MIDORIINU/DSE-CII/README.md

# DSE-CII
Repositorio de DSE/CII 2019 - 1C

* Luna Diego

* Neumarkt Fernández Leonardo

* Rizzo Gonzalo Gabriel

Prototipo:

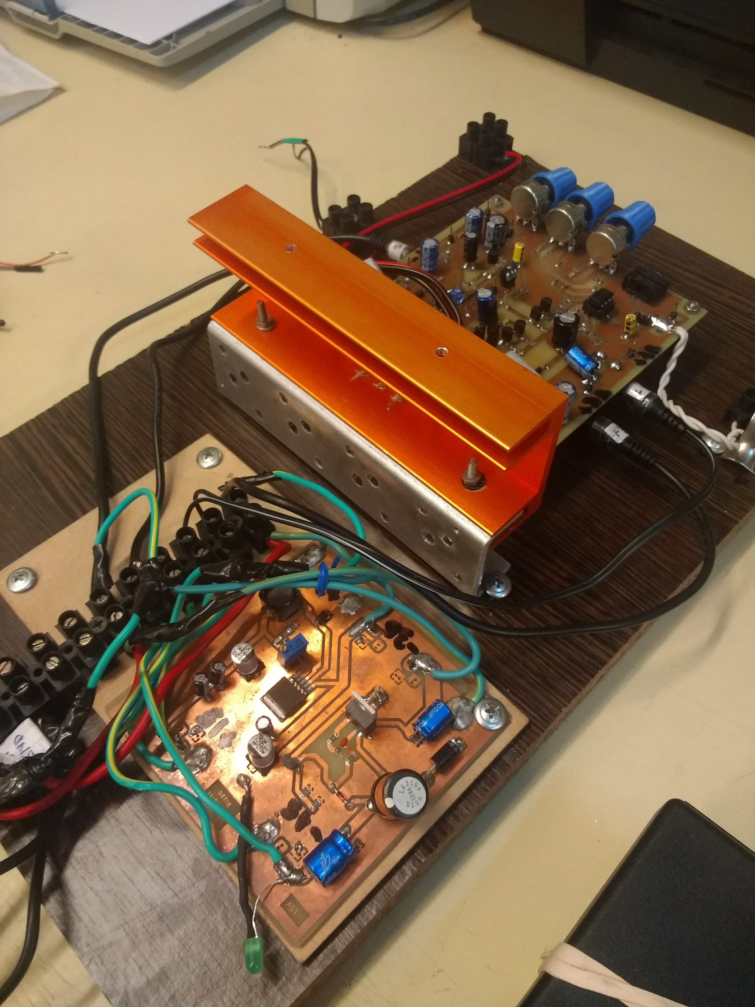
[picture p1: informe/final/informe/img/fotos/2.jpg]


Aprobado 20/12/2019.
