MIDORIINU/DSE-CII/informe/final/informe/datasheets.tex

%*********************************************

\subsection{BD135}
\label{datasheet_BD135}
\emph{NPN Plastic Medium-Power Silicon Transistors}\\
Manufacturer page:	\weblink{https://www.onsemi.com/PowerSolutions/product.do?id=BD135}{https://www.onsemi.com/PowerSolutions/product.do?id=BD135}\\
Manufacturer Datasheet:	\weblink{https://www.onsemi.com/pub/Collateral/BD135-D.PDF}{https://www.onsemi.com/pub/Collateral/BD135-D.PDF}\\

\subsection{BD136}
\label{datasheet_BD136}
\emph{PNP Plastic Medium-Power Silicon  Transistors}\\
Manufacturer page:	\weblink{https://www.onsemi.com/PowerSolutions/product.do?id=BD136}{https://www.onsemi.com/PowerSolutions/product.do?id=BD136}\\
Manufacturer Datasheet:	\weblink{https://www.onsemi.com/pub/Collateral/BD136G-D.PDF}{https://www.onsemi.com/pub/Collateral/BD136G-D.PDF}\\

\subsection{BC556}
\label{datasheet_BC556}
\emph{PNP Silicon Transistor}\\
Manufacturer page:	\weblink{https://www.onsemi.com/PowerSolutions/product.do?id=BC556}{https://www.onsemi.com/PowerSolutions/product.do?id=BC556}\\
Manufacturer Datasheet:	\weblink{https://www.onsemi.com/pub/Collateral/BC556BTA-D.pdf}{https://www.onsemi.com/pub/Collateral/BC556BTA-D.pdf}\\

\subsection{MJL21193}
\label{datasheet_MJL21193}
\emph{PNP Bipolar Power Transistor}\\
Manufacturer page:	\weblink{https://www.onsemi.com/PowerSolutions/product.do?id=MJL21193}{https://www.onsemi.com/PowerSolutions/product.do?id=MJL21193}\\
Manufacturer Datasheet:	\weblink{https://www.onsemi.com/pub/Collateral/MJL21193-D.PDF}{https://www.onsemi.com/pub/Collateral/MJL21193-D.PDF}\\

\subsection{MJL21194}
\label{datasheet_MJL21194}
\emph{NPN Bipolar Power Transistor}\\
Manufacturer page:	\weblink{https://www.onsemi.com/PowerSolutions/product.do?id=MJL21194}{https://www.onsemi.com/PowerSolutions/product.do?id=MJL21194}\\
Manufacturer Datasheet:	\weblink{https://www.onsemi.com/pub/Collateral/MJL21193-D.PDF}{https://www.onsemi.com/pub/Collateral/MJL21193-D.PDF}\\

\subsection{1N4148}
\label{datasheet_NE5532}
\emph{Small signal diode}\\
Manufacturer page:	\weblink{https://www.onsemi.com/PowerSolutions/product.do?id=1N4148}{https://www.onsemi.com/PowerSolutions/product.do?id=1N4148}\\
Manufacturer Datasheet:	\weblink{https://www.vishay.com/docs/81857/1n4148.pdf}{https://www.vishay.com/docs/81857/1n4148.pdf}\\

\subsection{1N4370}
\label{datasheet_1N4370}
\emph{Zener Voltage Regulator Diode}\\
Manufacturer page:	\weblink{https://www.microsemi.com/existing-parts/parts/121321}{https://www.microsemi.com/existing-parts/parts/121321}\\
Manufacturer Datasheet:	\weblink{http://pdf.datasheetcatalog.com/datasheet/microsemi/1N746\_759A\_4370\_4372A.pdf}{http://pdf.datasheetcatalog.com/datasheet/microsemi/1N746\_759A\_4370\_4372A.pdf}\\

\subsection{1N4007}
\label{datasheet_1N4007}
\emph{Silicon rectifier diode}\\
Manufacturer page:	\weblink{https://www.onsemi.com/products/discretes-drivers/diodes-rectifiers/rectifiers/1n4007}{https://www.onsemi.com/products/discretes-drivers/diodes-rectifiers/rectifiers/1n4007}\\
Manufacturer Datasheet:	\weblink{http://pdf.datasheetcatalog.com/datasheet/fairchild/1N4007.pdf}{http://pdf.datasheetcatalog.com/datasheet/fairchild/1N4007.pdf}\\

\subsection{1N5822}
\label{datasheet_1N5822}
\emph{Schottky Barrier Rectifier}\\
Manufacturer page:	\weblink{https://www.onsemi.com/products/discretes-drivers/diodes-rectifiers/schottky-diodes-schottky-rectifiers/1n5822}{https://www.onsemi.com/products/discretes-drivers/diodes-rectifiers/schottky-diodes-schottky-rectifiers/1n5822}\\
Manufacturer Datasheet:	\weblink{https://www.onsemi.com/pub/Collateral/1N5820-D.PDF}{https://www.onsemi.com/pub/Collateral/1N5820-D.PDF}\\

\subsection{Metal film resistor}
\label{datasheet_METALFILMRESISTOR}
\emph{Metal film resistor}\\
Manufacturer page:	\weblink{https://www.vishay.com/resistors-fixed/metal-film/tab/doclibrary/}{https://www.vishay.com/resistors-fixed/metal-film/tab/doclibrary/}\\

\subsection{Carbon film resistor}
\label{datasheet_CARBONFILMRESISTOR}
\emph{Carbon film resistor}\\
Manufacturer page:	\weblink{http://www.vishay.com/resistors-fixed/carbon-film/tab/doclibrary/}{http://www.vishay.com/resistors-fixed/carbon-film/tab/doclibrary/}\\

\subsection{Ceramic capacitor}
\label{datasheet_CERAMIC_CAPACITOR}
\emph{Ceramic disk capacitor}\\
Manufacturer page:	\weblink{https://www.vishay.com/capacitors/ceramic/disc/}{https://www.vishay.com/capacitors/ceramic/disc/}\\

\subsection{Electrolitic Aluminum capacitor}
\label{datasheet_ELECTROLITIC_CAPACITOR}
\emph{Electrolitic aluminum capacitor}\\
Manufacturer page:	\weblink{https://www.vishay.com/capacitors/aluminum/}{https://www.vishay.com/capacitors/aluminum/}\\
