MIDORIINU/DSE-CII/informe/final/informe/caratula.tex

\begin{titlepage}
%
% Sin cabecera ni pie de página:
%

\thispagestyle{empty}

 %Título:

	\begin{center}

   	\begin{figure}[H]
    		\centering
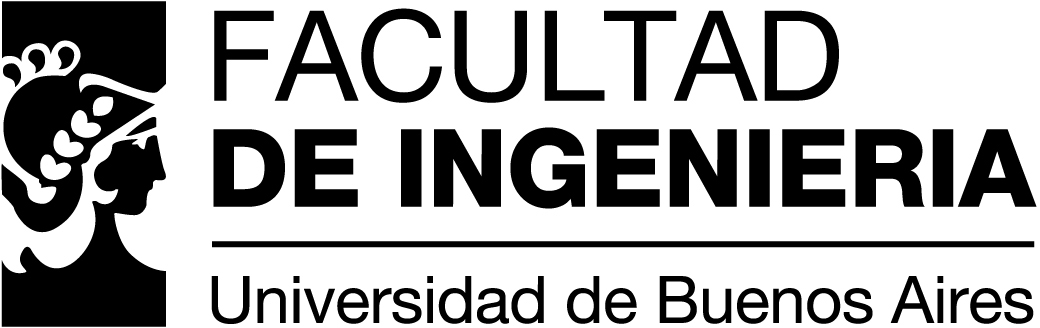
[picture p25: informe/final/informe/img/fiuba.png]
    		
  	\end{figure}

		\vspace{1.0cm}

		\textsc{\huge \materia}\\
		\vspace{0.30cm}
		\Huge{\titulo}\\
		\HRule \\
		\vspace{0.15cm}
		\Large{\textbf{\titulolargo}}\\
		\HRule \\
		\vspace{0.15cm}

		\begin{flushleft}
		    \resizebox{0.95 \textwidth}{!}{%
			\begin{tabularx}{\textwidth}{@{\extracolsep{\fill}} ll|l}
				\emph{Alumnos:}&&\emph{Docentes:} \\
				\autorA & Padrón N\textdegree \space \padronA & \docenteA \\
				\mailA  &  & \docenteB \\
				\autorB & Padrón N\textdegree \space \padronB & \docenteC \\
				\mailB  &  & \docenteD \\				
				\autorC & Padrón N\textdegree \space \padronC & \docenteE \\
				\mailC  &  &  \\	
				        &  & \\
			\end{tabularx}
			}
		\end{flushleft}

% \begin{normalsize}\textbf{(\textbf{*}) Docente asignado.}\end{normalsize}

		\vfill
%        \vspace{0.6cm}
		% Bottom of the page
		{\Large \thedate}

	\end{center}

\end{titlepage}
