MIDORIINU/DSE-CII/informe/final/informe-compilado/TP_Final_med_Informe.pdf

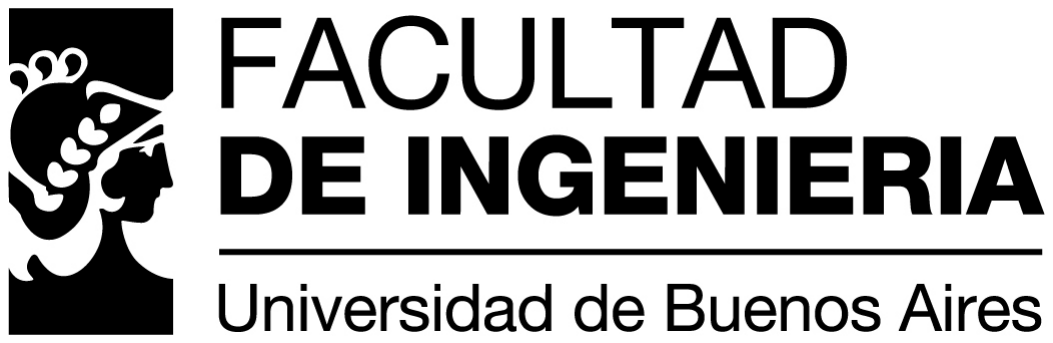
[picture p38: figure]

### Circuitos electrónicos II - 66.10 Diseño de circuitos electrónicos - 86.10

# Trabajo práctico final

## Diseño y construcción de un amplificador clase G - mediciones

Alumnos: | | Docentes:
Luna Diego | Padrón N° 75451 | Ing. Bertuccio José Alberto
diegorluna@gmail.com | | Ing. Marchi Edgardo
Neumarkt Fernández Leonardo Padrón N° 97471 | Ing. Bulacio Matías
leoneu928@gmail.com | | Ing. D’Angiolo Federico
Rizzo Gonzalo Gabriel | Padrón N° 96772 | Ing. Gamez Pablo

## gonzalorizzo95@gmail.com

## 12 de Diciembre de 2019

Circuitos electrónicos II - 66.10
Diseño de circuitos electrónicos - 86.10 | Trabajo práctico final

## Índice

Índice | I
1. Consideraciones previas al diseño | 1
2. Diseño circuital | 2
3. Simulaciones | 7
4. Mediciones | 23
5. Observaciones y conclusiones | 34
6. Bibliografía | 35
Apéndices | 37
A. Hojas de datos | 37

1

er c. 2019 | Índice | I

Circuitos electrónicos II - 66.10
Diseño de circuitos electrónicos - 86.10 | Trabajo práctico final
II | Índice | 1er c. 2019

Circuitos electrónicos II - 66.10
Diseño de circuitos electrónicos - 86.10 | Trabajo práctico final

## Índice de figuras

2.1. Circuito pre-amplificador | | 2
2.2. Circuito Step Down | | 3
2.3. Circuito Step Up | | 3
2.4. Vista 3D del PCB de la fuente switching interna | | 4
2.5. Esquemático de amplificador con clase G | | 5
2.6. PCB del amplificador | | 6
2.7. Vista 3D del PCB del amplificador | | 6
3.1. Circuito simulado mostrando los valores de polarización | | 8
3.2. Ganancia de lazo (simulación) | 10
3.3. Ancho de banda a baja potencia (simulación) | 12
3.4. Ancho de banda de potencia (simulación) | 14
3.5. Valores de impedancia de entrada (simulación) | 16
3.6. Valores de impedancia de salida (simulación) | 17
3.7. THD en función de la frecuencia (simulación) | 18
3.8. THD en función de la potencia (simulación) | 19
3.9. Tiempo de crecimiento (simulación) | 21
3.10. Tiempo de crecimiento, zoom sobre la pendiente (simulación) | 22
4.1. Medición de fl a baja potencia, mostrando el corrimiento de fase | 26
4.2. Cálculo del corrimiento de fase para fl a baja potencia | 27
4.3. Cálculo del corrimiento de fase para fh a baja potencia | 28
4.4. Medición de fl a máxima potencia, mostrando el corrimiento de fase | 29
4.5. Medición de fl a máxima potencia, mostrando el corrimiento de fase | 30
4.6. Medición de la sensibilidad del circuito amplificador | 31
4.7. Verificación de tiempo de crecimiento del generador | 32
4.8. Medición del Slew Rate del circuito amplificador | 33

1

er c. 2019 | Índice | III

Circuitos electrónicos II - 66.10
Diseño de circuitos electrónicos - 86.10 | Trabajo práctico final

## Índice de cuadros

3.1. Punto de reposo de los transistores y máxima potencia disipada en operación | 7
4.1. Primer punto de operación | 24
4.2. Segundo punto de operación | 24
4.3. Valores significativos del ancho de banda a baja potencia | 25
4.4. Comparación de ancho de banda a baja potencia | 25
4.5. Valores significativos del ancho de banda a máxima potencia | 28
4.6. Comparación de ancho de banda a máxima potencia | 29
4.7. Comparación del Slew Rate | 33
IV | Índice | 1er c. 2019

Circuitos electrónicos II - 66.10
Diseño de circuitos electrónicos - 86.10 | Trabajo práctico final

## 1. Consideraciones previas al diseño

### 1.1. Objetivo y requerimientos de usuario

El objetivo del presente trabajo es armar un circuito amplificador que amplifique una señal de audio que será reproducida en un Bafle (asumimos respuesta resistiva pura en todo el ancho de banda). Debe proveer al usuario con una buena calidad de sonido (algo subjetivo, no obstante acá solo se consideran medidas reales)

con volumen alto, sin consumir mucha más energía de la necesaria, ni ser muy grande y pesado. Es decir, debe tener baja distorsión (THD), alta relación señal-ruido (SNR), eficiencia razonable y buena potencia

máxima de salida.

### 1.2. Especificaciones

A continuación se enumeran las especificaciones que fueron tenidas en consideración para la implemen-tación del amplificador de audio.

- Máxima Potencia de Salida: > 40WRMS@8Ω
- Salida clase G
- THD: < 0,1%@1kHz, < 0,2%@10kHz , a 40W RMS@8Ω
- Slew-Rate: > 5

V
µS
- Impedancia de entrada: > 21kΩ
- Sensibilidad: 1,1V pico @8Ω
- Ancho de banda: 10Hz −→ 50kHz
- Factor de amortiguamiento: > 100
- Ancho de banda de potencia: > 30kHz
- Alimentación:
- Baja tensión: ±15V nominal (desde transformador de 10V + 10V), ripple máximo 10%
- Alta tensión: ±35V nominal (desde fuente switching implementada de 15V + 15V más fuente de alimentación de 25V + 25V), ripple máximo 10%
- Máxima excursión: 25V

1

er c. 2019 | Consideraciones previas al diseño | 1

Circuitos electrónicos II - 66.10
Diseño de circuitos electrónicos - 86.10 | Trabajo práctico final

## 2. Diseño circuital

### 2.1. Circuito Pre-amplificador

El circuito pre-amplificador consta de un integrado TL072 con una configuración de realimentación paralelo-serie, que tiene como fin, amplificar la señal de entrada para ser tratada mediante los filtros siguientes al capacitor de acople C12.

Los filtros tienen como fin disminuir el volumen de las frecuencias bajas o altas a modo de incluir una etapa de procesamiento de señal al proyecto. Esto se logra con los potenciómetros incluidos en la placa, para que el ajuste sea de fácil manejo.

Por último, se utiliza un divisor resistivo para controlar el volumen del amplificador en conjunto.

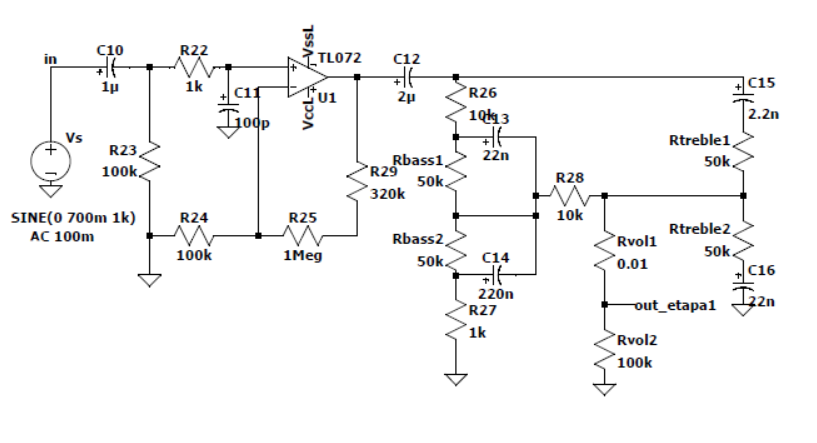
[picture p39: figure]

Figura 2.1: Circuito pre-amplificador.

### 2.2. Fuente Switching

El circuito amplificador se alimenta con 4 tensiones diferentes, las cuales son +35V, +15V, −35V y −15V ,

para ello se diseñaron dos fuentes switching, una step down para bajar de 35V a 15V y una step up para subir de −35V a −15V.

A partir de las hojas de datos de los reguladores LM2576 y LM2577, en configuraciones indicadas para entregar las alimentaciones correspondientes. Se implementaron los siguientes circuitos tomados de las hojas de datos:

2 | Diseño circuital | 1er c. 2019

Circuitos electrónicos II - 66.10
Diseño de circuitos electrónicos - 86.10 | Trabajo práctico final

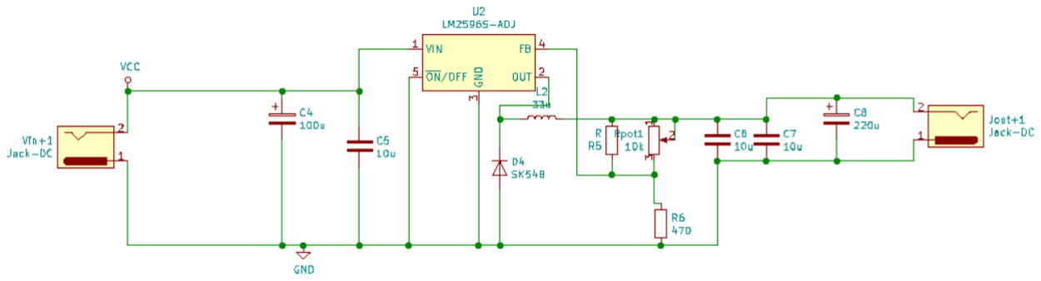
[picture p40: figure]

Figura 2.2: Circuito Step Down.

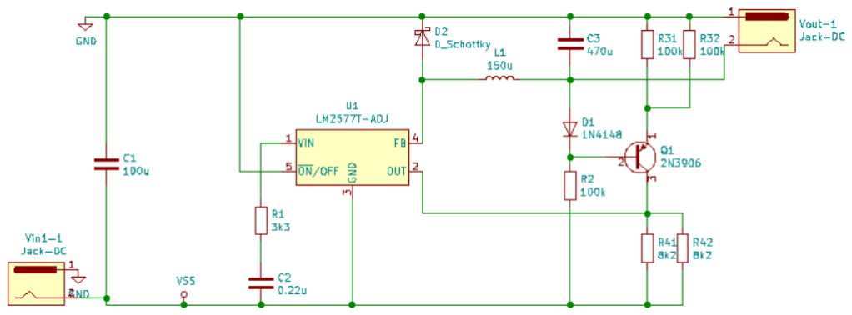
[picture p41: figure]

Figura 2.3: Circuito Step Up.

Luego se diseñó el PCB de la fuente Switching en Kicad a partir de los circuitos mencionados, el resultado se puede observar a continuación:

1

er c. 2019 | Diseño circuital | 3

Circuitos electrónicos II - 66.10
Diseño de circuitos electrónicos - 86.10 | Trabajo práctico final

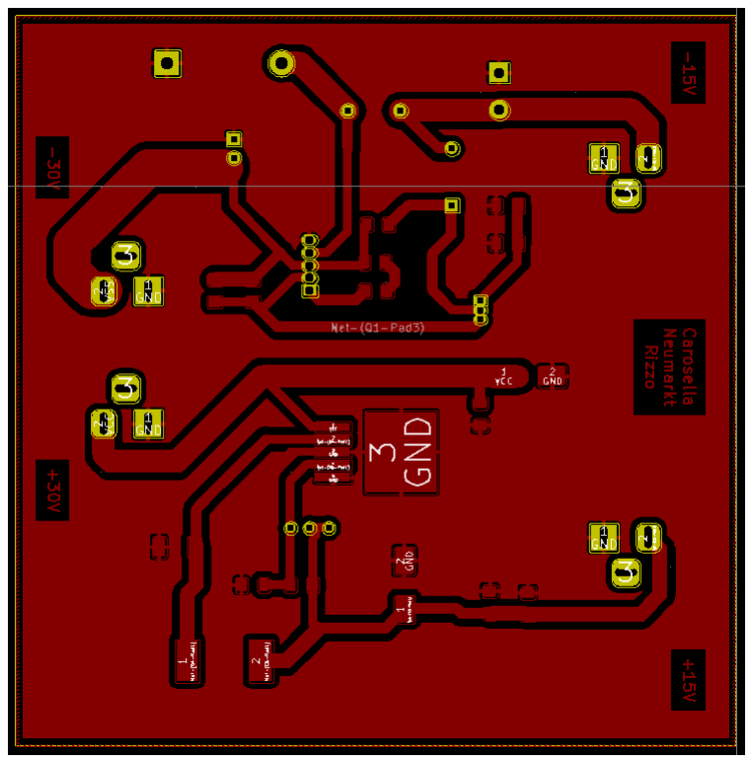
[picture p42: figure]
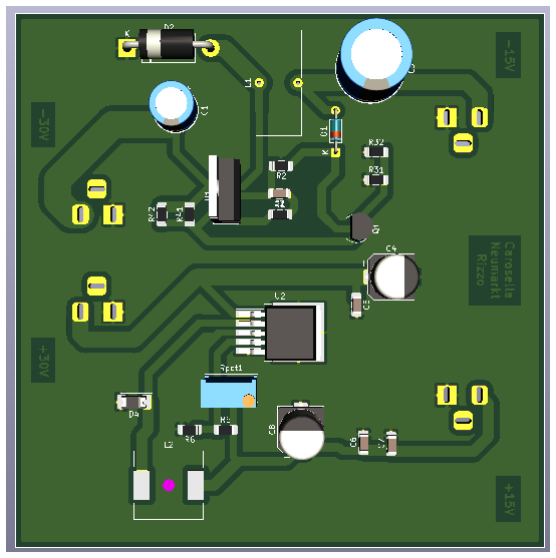
[picture p43: figure]

(a) Vista superior. | (b) Vista inferior.

Figura 2.4: Vista 3D del PCB de la fuente switching interna.

### 2.3. Circuito amplificador

A continuación, se muestran el esquemático del circuito implementado en Kicad. En primer lugar, en la figura [2.5] muestra el amplificador principal clase G diseñado junto con el circuito de pre-amplificador.

Luego se prosiguió por realizar el diseño del PCB. Para ello se aplicó un plano de masa en la capa superior de la placa. Por otro lado se utilizaron pistan anchas y cortas, de un espesor de 60mils a 118mils y separaciones entre pistas mayores a 12mils. A continuación se muestran imágenes del PCB para el amplificador clase G a implementar:

4 | Diseño circuital | 1er c. 2019

Circuitos electrónicos II - 66.10
Diseño de circuitos electrónicos - 86.10 | Trabajo práctico final

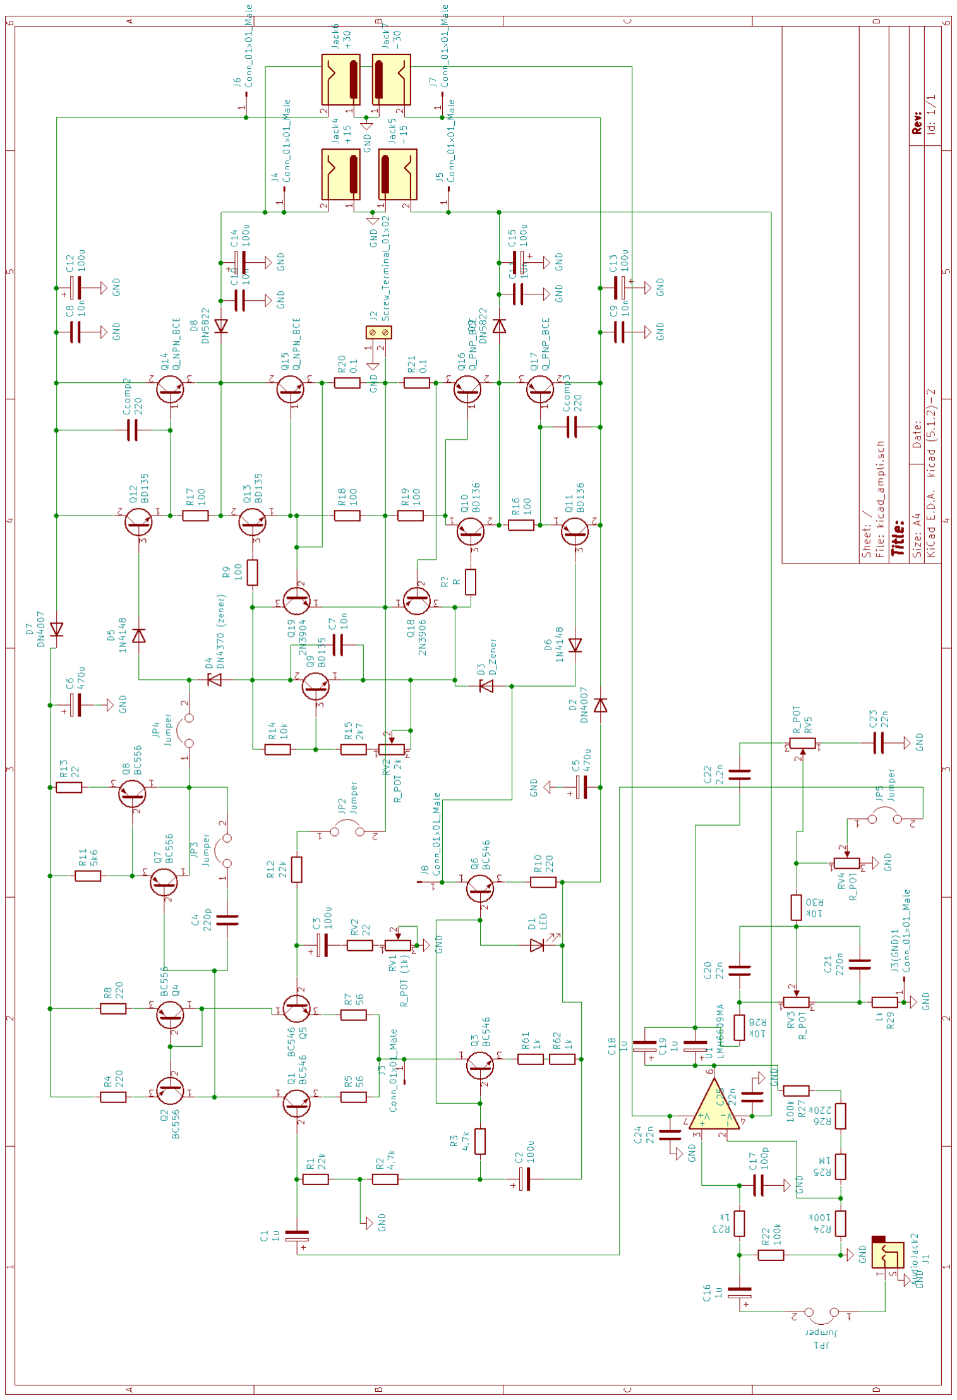
[picture p44: figure]

Figura 2.5: Esquemático de amplificador con clase G.

1

er c. 2019 | Diseño circuital | 5

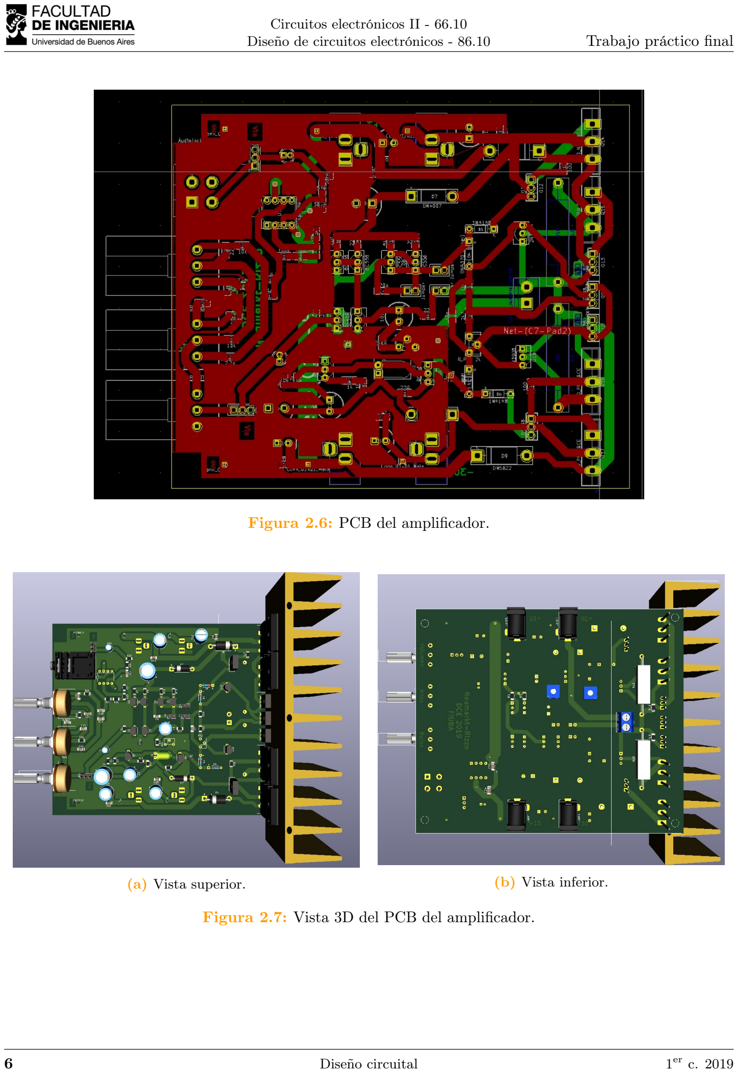
[picture p45: page 12]

Circuitos electrónicos II - 66.10
Diseño de circuitos electrónicos - 86.10 | Trabajo práctico final

Figura 2.6: PCB del amplificador.

(a) Vista superior. | (b) Vista inferior.

Figura 2.7: Vista 3D del PCB del amplificador.

6 | Diseño circuital | 1er c. 2019

Circuitos electrónicos II - 66.10
Diseño de circuitos electrónicos - 86.10 | Trabajo práctico final

## 3. Simulaciones

### 3.1. Polarización

Se simularon los valores en reposo de los transistores de la etapa amplificadora clase G, junto con la máxima potencia disipada en cada uno. Los resultados se muestran en el cuadro [3.1]

Transistor | VBEQ | VCEQ | ICQ | PQ
Q1 (BC546C) | 612mV | 33,87V | 549µA | 18,6mW
Q2 (BC556B) | −610mV | −1,31V | 549µA | 722µW
Q3 (BC546B) | 631mV | 31,78V | 1,1mA | 35mW
Q4 (BC556B) | −610mV | 33,78V | 549µA | 334mW
Q5 (BC546B) | 612mV | 34,6V | 549µA | 19mW
Q6 (BC546B) | 693mV | 28,8V | 9,71mA | 280mW
Q7 (BC556B) | −557mV | 30V | 170µA | 5mW
Q8 (BC556B) | −669mV | 30,71V | 9,57mA | 294mW
Q9 (BD135) | 676mV | 2,96V | 9,40mA | 28mW
Q10(BD136) | −722mV | 13,9V | 15mA | 208mW
Q11(BD136) | 10,95V | 20,32V | 31pA | 1,1anoW
Q12(BD135) | −10,93V | 20,32V | 31pA | 1,1anoW
Q13(BD135) | 693mV | 13,88V | 18,9mA | 263mW
Q14(MJL21194) | 1,04nV | 20,32V | 26pA | 522pW
Q15(MJL21194) | 722mV | 14,6V | 714mA | 10,43W
Q16(MJL21193) | −678mV | 14,6V | 718mA | 10,49W
Q17(MJL21193) | −986mV | 20,32V | 1,76pA | 459pW
Q18(2N3906) | −72mV | 1,47V | 1,47pA | 2,2pW
Q19(2N3904) | 72mV | 1,48V | 1,58pA | 2,3pW

Cuadro 3.1: Punto de reposo de los transistores y máxima potencia disipada en operación.

En la figura [3.1] se pueden verificar los resultados de la simulación con las referencias en el circuito

pertinente.

1

er c. 2019 | Simulaciones | 7

Circuitos electrónicos II - 66.10
Diseño de circuitos electrónicos - 86.10 | Trabajo práctico final

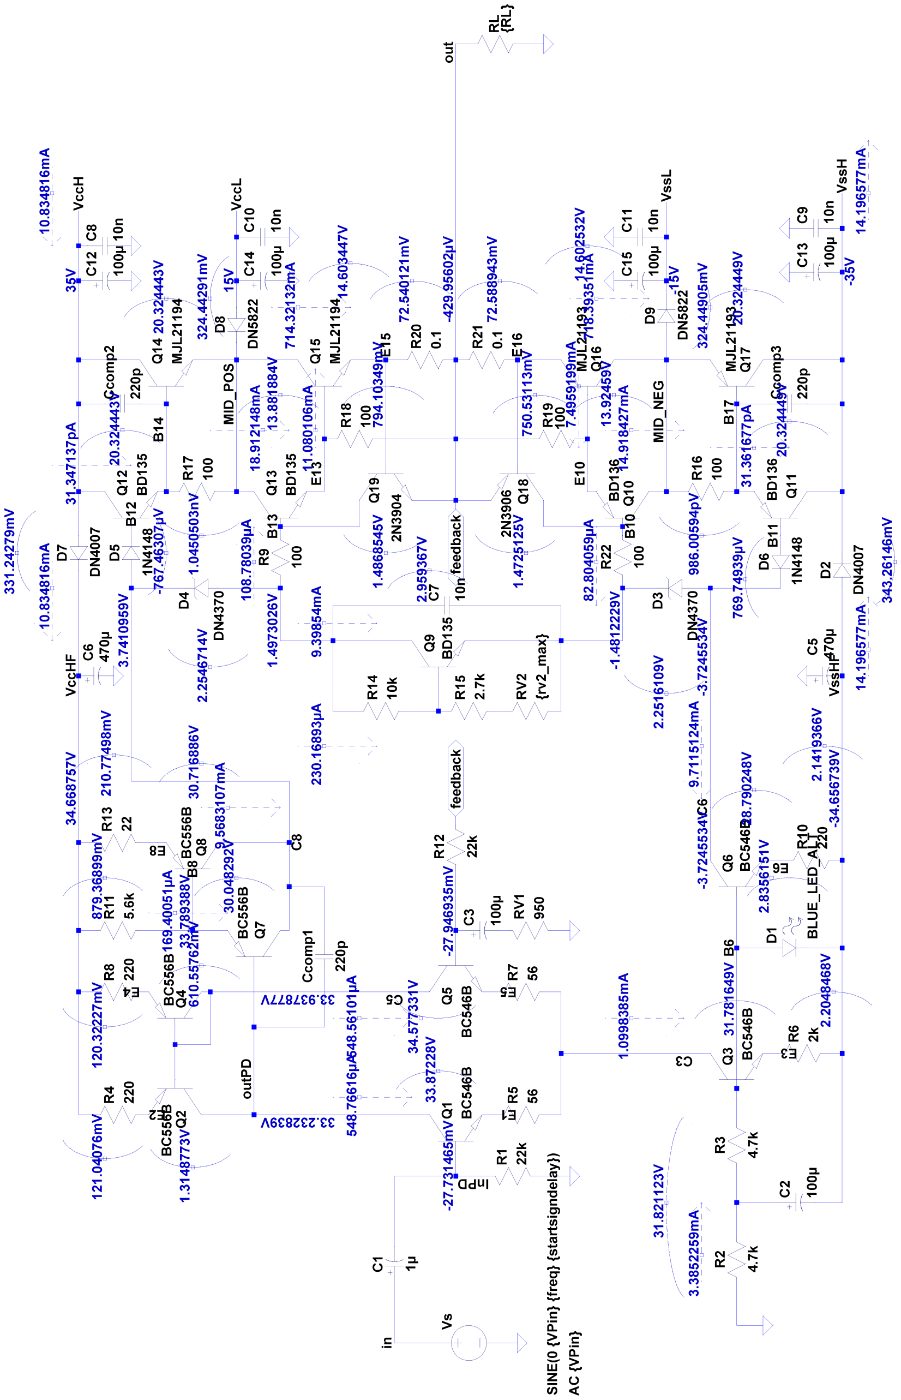
[picture p46: figure]

Figura 3.1: Circuito simulado mostrando los valores de polarización.

8 | Simulaciones | 1er c. 2019

Circuitos electrónicos II - 66.10
Diseño de circuitos electrónicos - 86.10 | Trabajo práctico final

### 3.2. Ganancia de lazo

En la figura [3.2] se puede observar la ganancia de lazo del circuito, simulado a distintas frecuencias. A

su vez, se especifica el margen de ganancia y de fase, para verificar la correcta estabilización del circuito. Obteniéndose de este modo:

- Margen de ganancia: 29,21dB
- Margen de fase: 86,12°

1

er c. 2019 | Simulaciones | 9

Circuitos electrónicos II - 66.10
Diseño de circuitos electrónicos - 86.10 | Trabajo práctico final

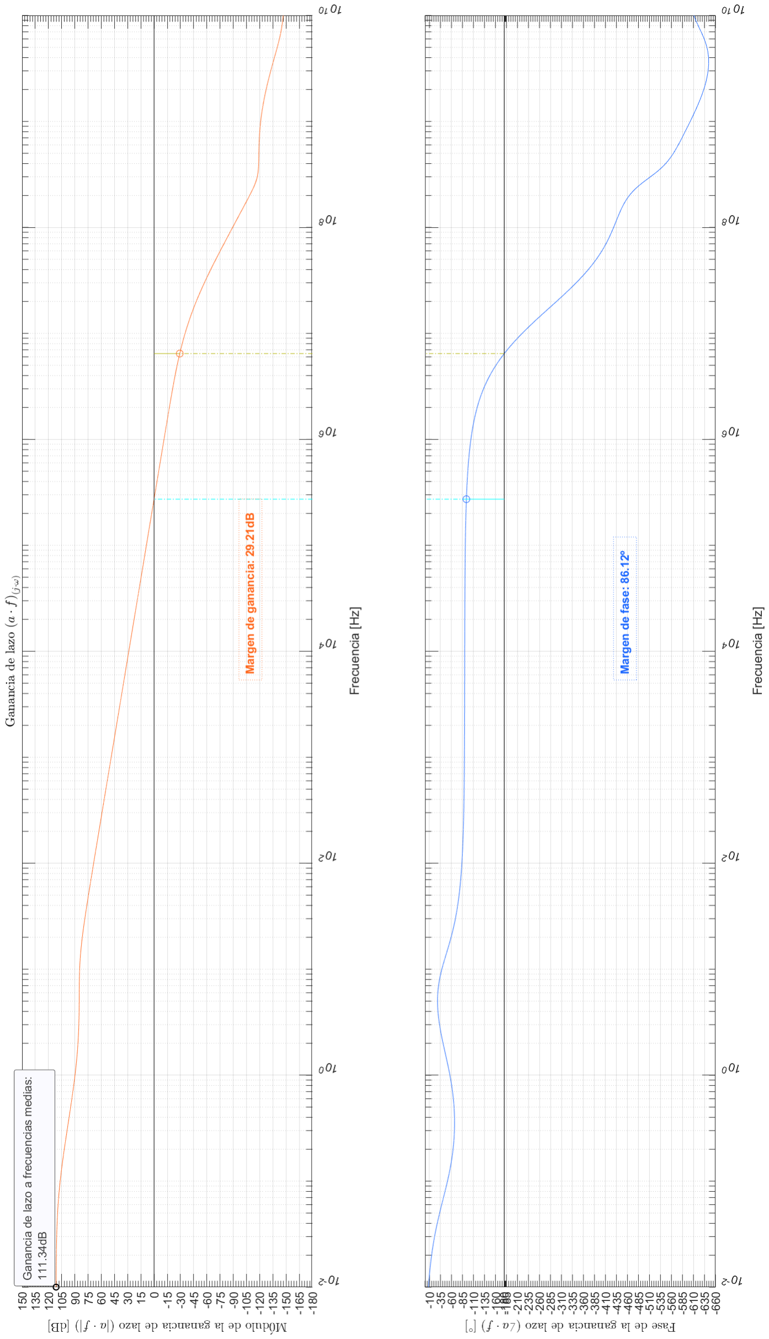
[picture p47: figure]

Figura 3.2: Ganancia de lazo (simulación).

10 | Simulaciones | 1er c. 2019

Circuitos electrónicos II - 66.10
Diseño de circuitos electrónicos - 86.10 | Trabajo práctico final

### 3.3. Ancho de banda

En la figura [3.3] se muestra el resultado de la simulación del ancho de banda del circuito.

Obtenemos un ancho de banda de 97,89kHz con frecuencias de corte:

- fl = 22,34Hz
- fh = 97,92kHz

1

er c. 2019 | Simulaciones | 11

Circuitos electrónicos II - 66.10
Diseño de circuitos electrónicos - 86.10 | Trabajo práctico final

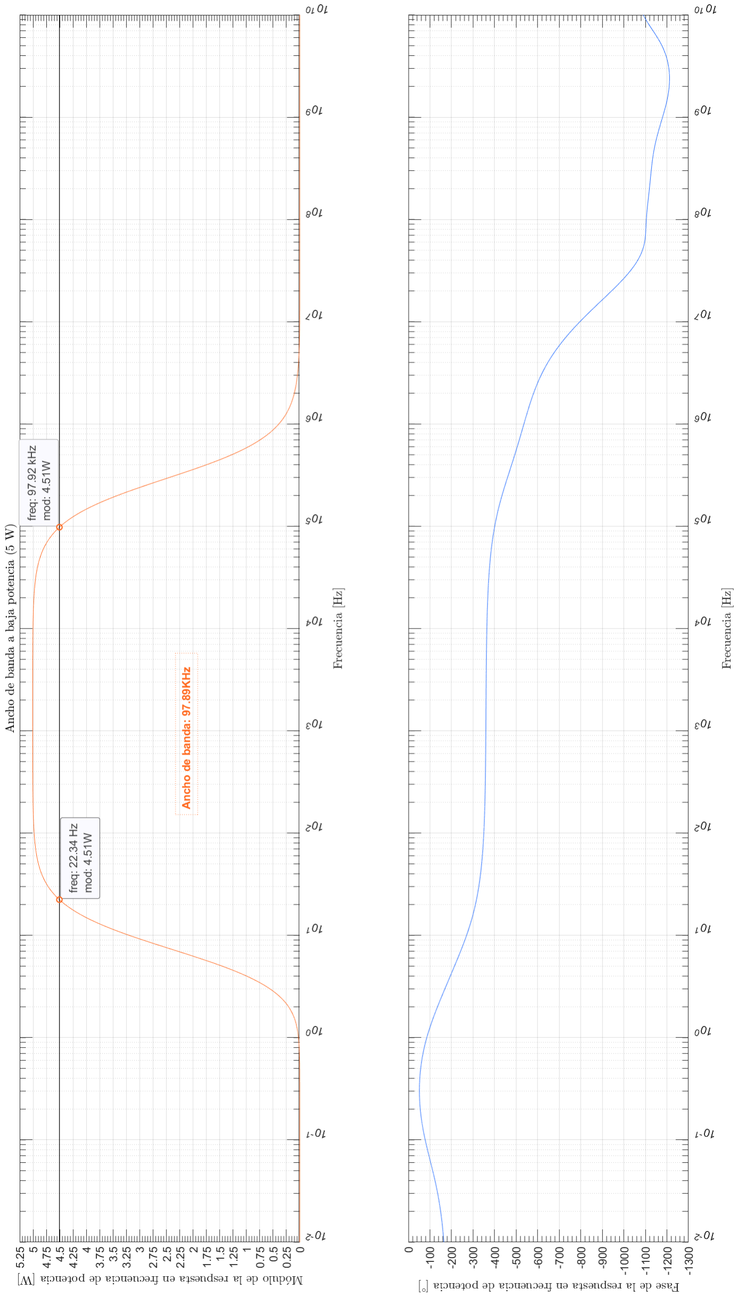
[picture p48: figure]

Figura 3.3: Ancho de banda a baja potencia (simulación).

12 | Simulaciones | 1er c. 2019

Circuitos electrónicos II - 66.10
Diseño de circuitos electrónicos - 86.10 | Trabajo práctico final

### 3.4. Ancho de banda de potencia

En la figura [3.4], se observa el resultado de la simulación del ancho de banda de potencia simulado.

Obtenemos en el circuito un ancho de banda de potencia de 97,89kHz con frecuencias de corte:

- fl = 22,34Hz
- fh = 97,84kHz

1

er c. 2019 | Simulaciones | 13

Circuitos electrónicos II - 66.10
Diseño de circuitos electrónicos - 86.10 | Trabajo práctico final

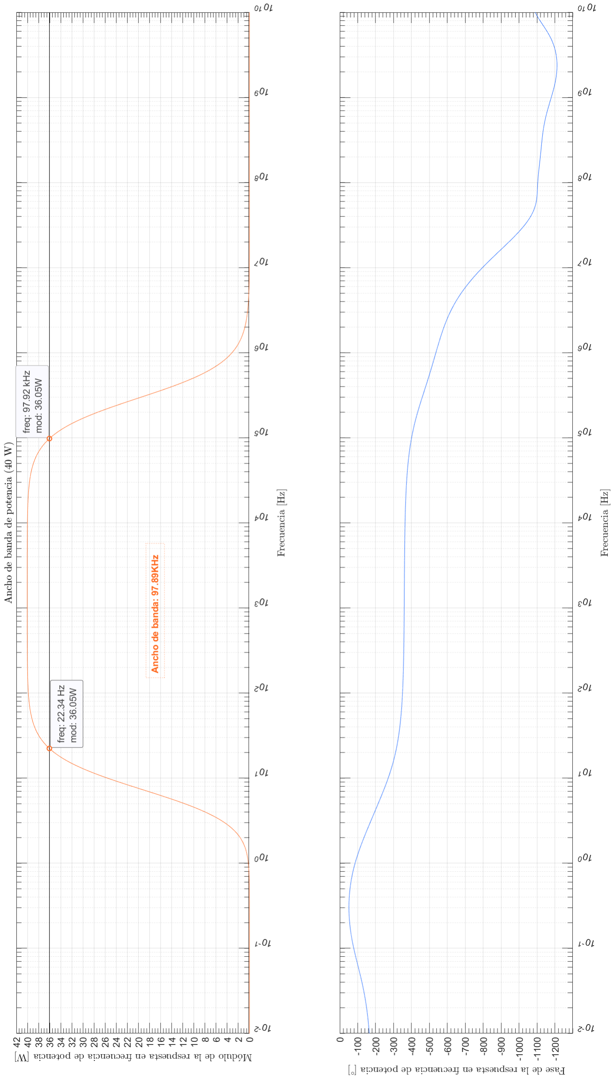
[picture p49: figure]

Figura 3.4: Ancho de banda de potencia (simulación).

14 | Simulaciones | 1er c. 2019

Circuitos electrónicos II - 66.10
Diseño de circuitos electrónicos - 86.10 | Trabajo práctico final

### 3.5. Impedancias de entrada y salida

En las figuras [3.5] y [3.6] , se observa los valores de la resistencia de entrada y salida del amplificador,

respectivamente, en función de la frecuencia.

1

er c. 2019 | Simulaciones | 15

Circuitos electrónicos II - 66.10
Diseño de circuitos electrónicos - 86.10 | Trabajo práctico final

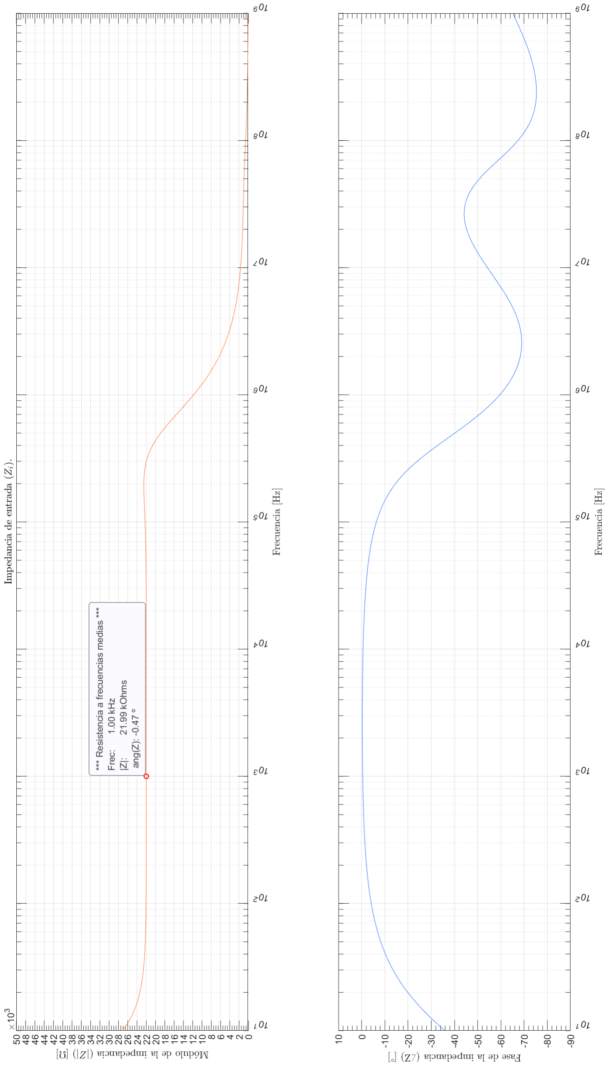
[picture p50: figure]

Figura 3.5: Valores de impedancia de entrada (simulación).

16 | Simulaciones | 1er c. 2019

Circuitos electrónicos II - 66.10
Diseño de circuitos electrónicos - 86.10 | Trabajo práctico final

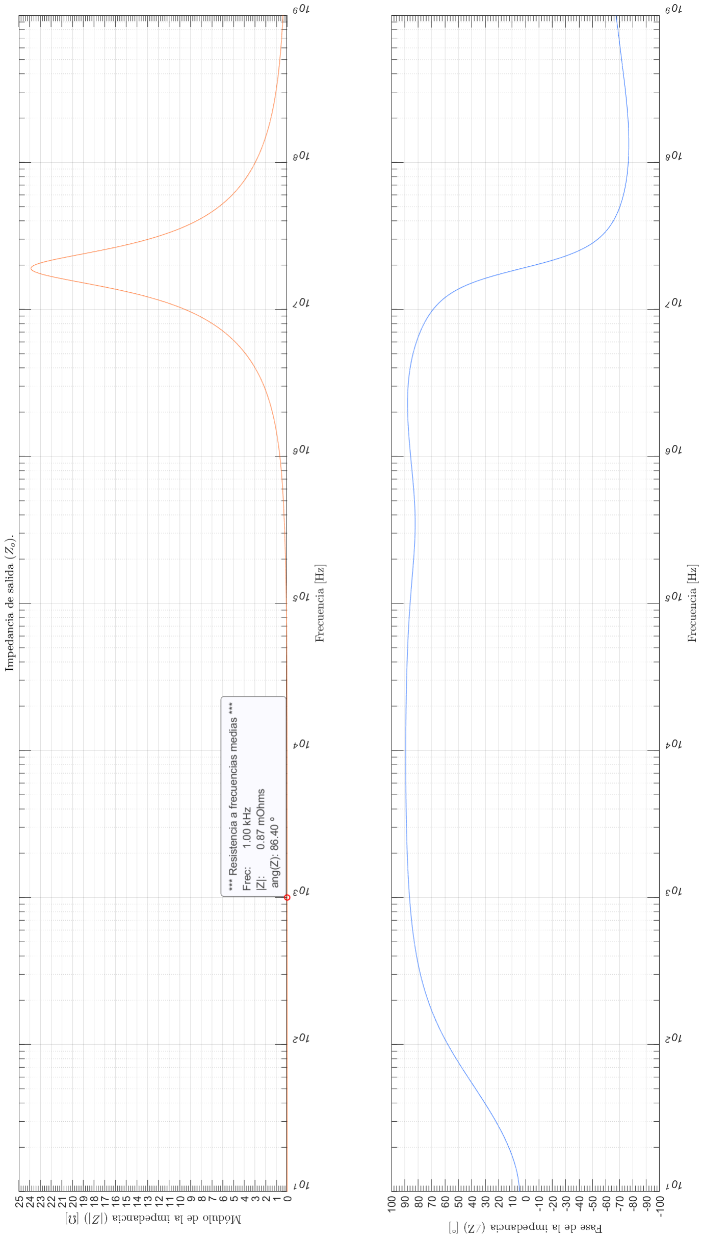
[picture p51: figure]

Figura 3.6: Valores de impedancia de salida (simulación).

1

er c. 2019 | Simulaciones | 17

Circuitos electrónicos II - 66.10
Diseño de circuitos electrónicos - 86.10 | Trabajo práctico final

### 3.6. THD

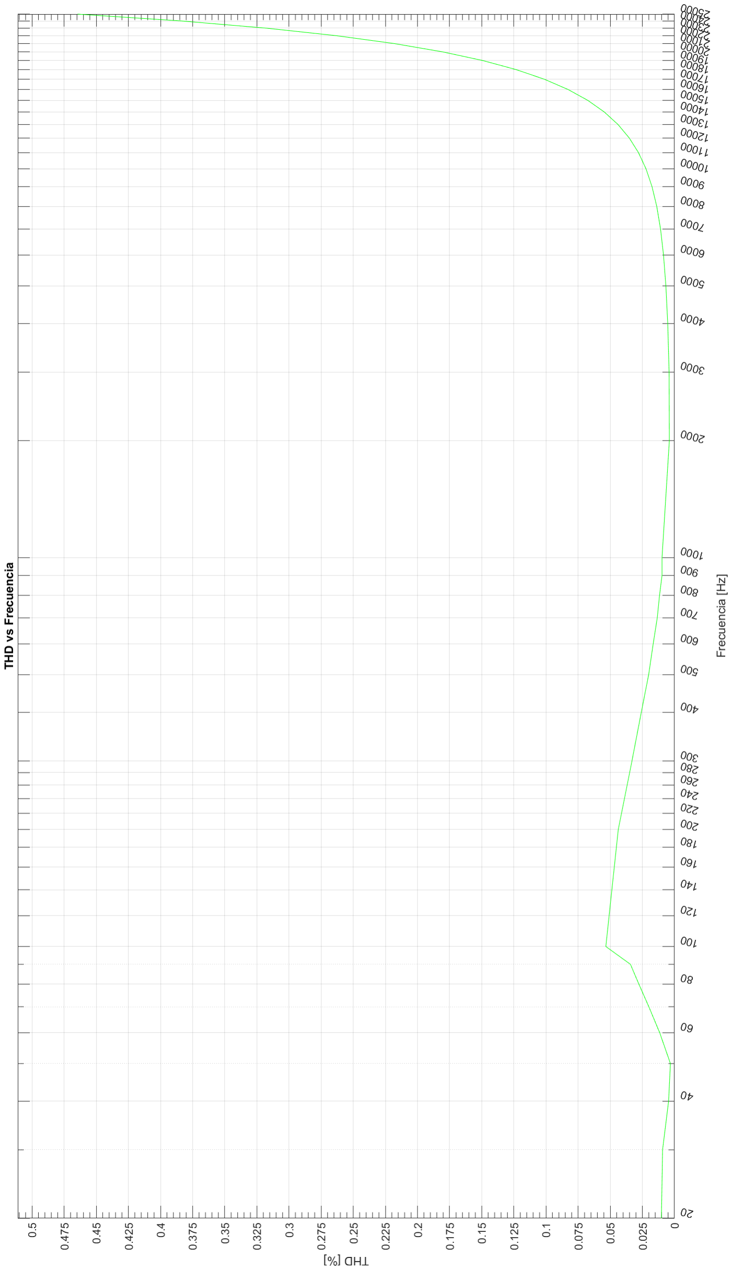
[picture p52: figure]

Figura 3.7: THD en función de la frecuencia (simulación).

18 | Simulaciones | 1er c. 2019

Circuitos electrónicos II - 66.10
Diseño de circuitos electrónicos - 86.10 | Trabajo práctico final

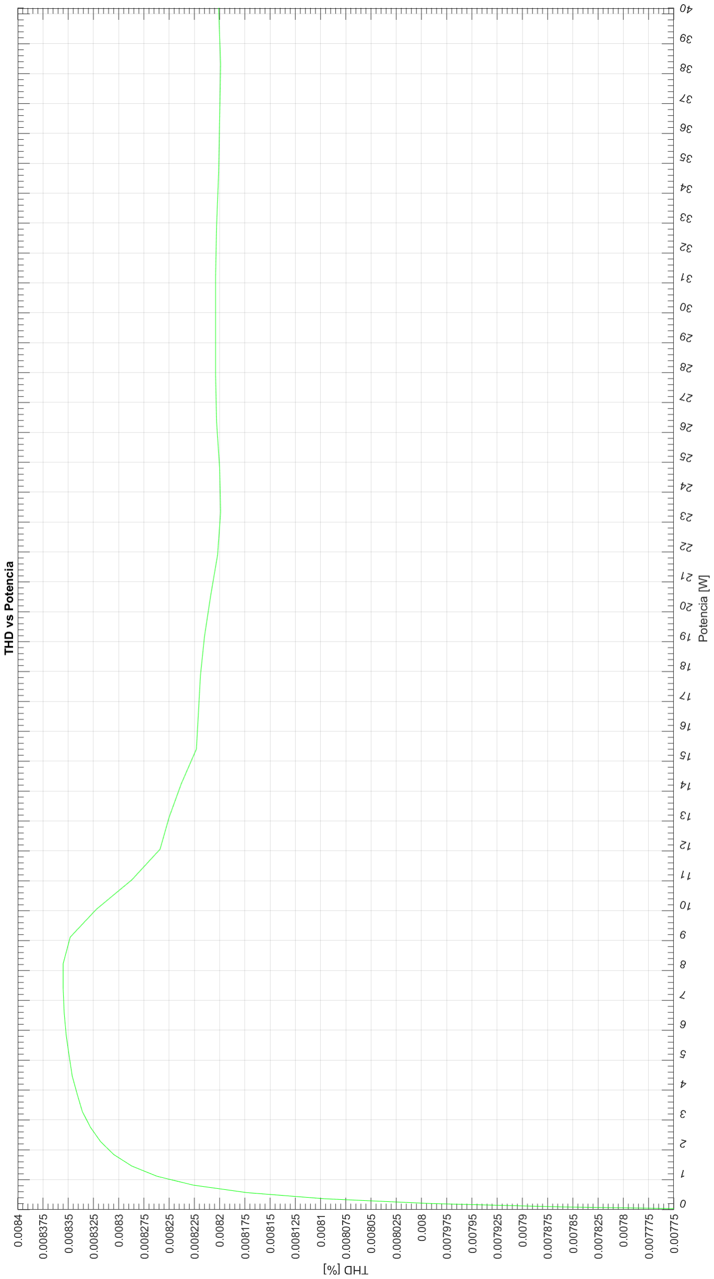
[picture p53: figure]

Figura 3.8: THD en función de la potencia (simulación).

1

er c. 2019 | Simulaciones | 19

Circuitos electrónicos II - 66.10
Diseño de circuitos electrónicos - 86.10 | Trabajo práctico final

### 3.7. Slew Rate

En la figura [3.9] observamos el resultado de la simulación utilizada para el cálculo del Slew Rate. En la figura [3.10], se aprecia con más claridad la pendiente para el cálculo, además del efecto que produce la

conmutación entre las fuentes de 15V y 35V.
A partir del cálculo de la pendiente producida por la respuesta al escalón obtenemos como resultado del Slew Rate:
- Slew Rate = 4,79V/µs
20 | Simulaciones | 1er c. 2019

Circuitos electrónicos II - 66.10
Diseño de circuitos electrónicos - 86.10 | Trabajo práctico final

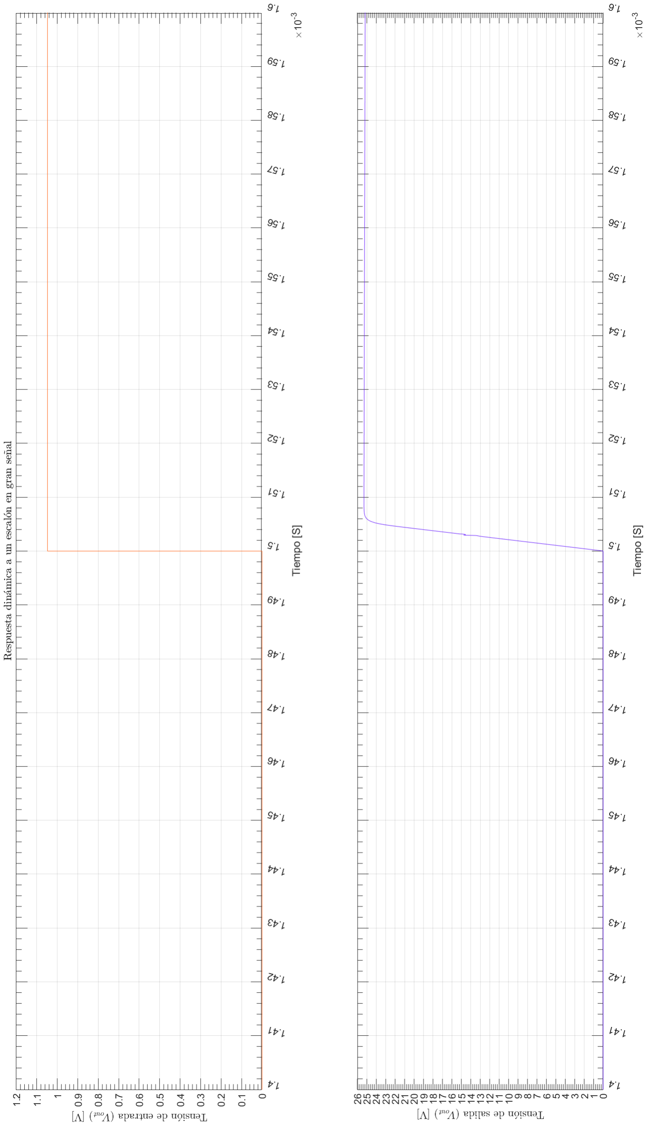
[picture p54: figure]

Figura 3.9: Tiempo de crecimiento (simulación).

1

er c. 2019 | Simulaciones | 21

Circuitos electrónicos II - 66.10
Diseño de circuitos electrónicos - 86.10 | Trabajo práctico final

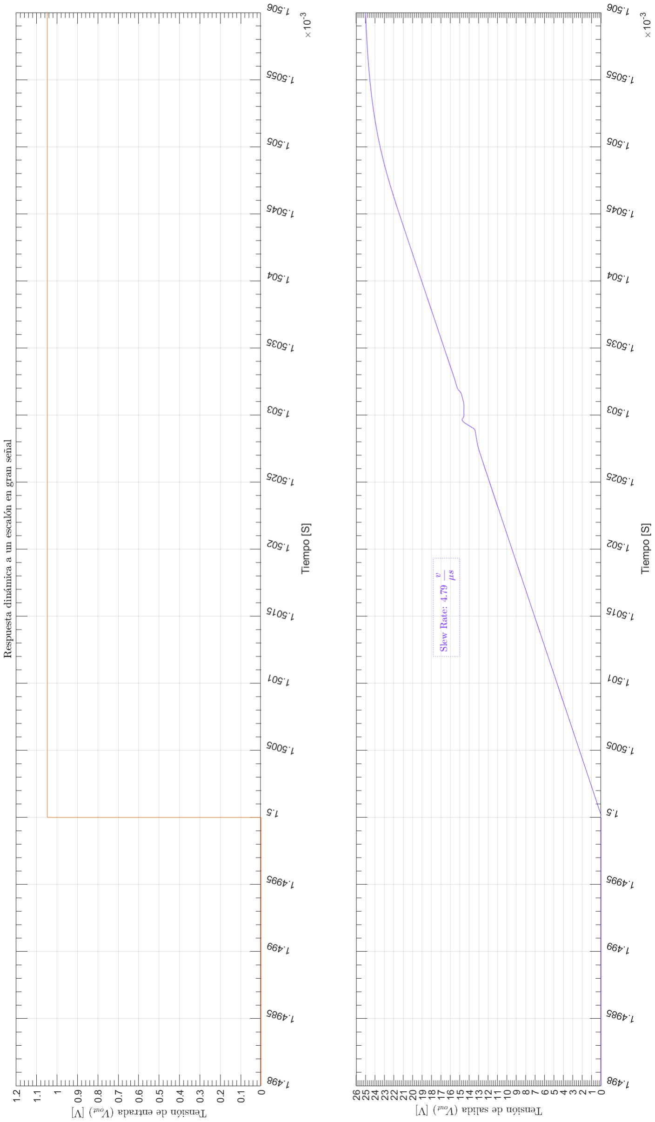
[picture p55: figure]

Figura 3.10: Tiempo de crecimiento, zoom sobre la pendiente (simulación).

22 | Simulaciones | 1er c. 2019

Circuitos electrónicos II - 66.10
Diseño de circuitos electrónicos - 86.10 | Trabajo práctico final

## 4. Mediciones

### 4.1. Polarización

Se realizaron las mediciones de punto de polarización del amplificador sin señal aplicada, obteniéndose los resultados del cuadro [4.1]. Los mismos se verificaron con y sin la carga conectada para observar que no haya

cambios en la polarización, una vez ajustada la corriente de polarización de salida, para este primer caso se ajustó la corriente de los transistores de salida en aproximadamente 190mA. El segundo caso medido se muestra en el cuadro [4.2], en este caso se ajusto la corriente al máximo que permite el preset del multiplicador

de VBE, aproximadamente 700mA, como puede observarse en este caso la potencia disipada en reposo es considerable, unos 22W, pero puede verse como las primeras etapas prácticamente no se ven afectadas por el cambio en la corriente de reposo de los transistores de salida.

1

er c. 2019 | Mediciones | 23

Circuitos electrónicos II - 66.10
Diseño de circuitos electrónicos - 86.10 | Trabajo práctico final
Transistor | VCEQ | ICQ | PQ
Q1 (BC546C) | 33,87V | 548,76µA | 18,57mW
Q2 (BC556B) | 1,31V | 548,76mA | 718,88µW
Q3 (BC546B) | 31,78V | 1,1mA | 34,96mW
Q4 (BC556B) | 610,56mV | 548,56µA | 334,93µW
Q5 (BC546B) | 34,58V | 548,56µA | 18,97mW
Q6 (BC546B) | 29,02V | 9,71mA | 281,78mW
Q7 (BC556B) | 30,32V | 169,17µA | 5,13mW
Q8 (BC556B) | 30,86V | 9,55mA | 295,55mW
Q9 (BD135) | 2,71V | 9,46mA | 25,64mW
Q10(BD136) | 14,09V | 8,28mA | 116,67mW
Q11(BD136) | 20,26V | 0mA | 0mW
Q12(BD135) | 20,27V | 0mA | 0mW
Q13(BD135) | 14,06V | 9,7mA | 136,38mW
Q14(MJL21194) | 20,27V | 0mA | 0mW
Q15(MJL21194) | 14,72V | 192,02mA | 2,83W
Q16(MJL21193) | 14,71V | 193,5mA | 2,85W
Q17(MJL21193) | 20,26V | 0mA | 0mW
Q18(2N3906) | 1,36V | 0mA | 0mW
Q19(2N3904) | 1,35V | 0mA | 0mW

Cuadro 4.1: Primer punto de operación.

Transistor | VCEQ | ICQ | PQ
Q1 (BC546C) | 33,87V | 548,76µA | 18,57mW
Q2 (BC556B) | 1,31V | 548,76mA | 718,88µW
Q3 (BC546B) | 31,78V | 1,1mA | 34,96mW
Q4 (BC556B) | 610,56mV | 548,56µA | 334,93µW
Q5 (BC546B) | 34,58V | 548,56µA | 18,97mW
Q6 (BC546B) | 28,79V | 9,71mA | 279,55mW
Q7 (BC556B) | 30,05V | 169,4µA | 5,09mW
Q8 (BC556B) | 30,72V | 9,57mA | 294mW
Q9 (BD135) | 2,95V | 9,40mA | 27,73mW
Q10(BD136) | 13,93V | 14,73mA | 205,19mW
Q11(BD136) | 20,32V | 0mA | 0mW
Q12(BD135) | 20,30V | 0mA | 0mW
Q13(BD135) | 13,89V | 18,66mA | 259,19mW
Q14(MJL21194) | 20,32V | 0mA | 0mW
Q15(MJL21194) | 14,62V | 700,06mA | 10,23W
Q16(MJL21193) | 14,61V | 704,1mA | 10,29W
Q17(MJL21193) | 20,32V | 0mA | 0mW
Q18(2N3906) | 1,47V | 0mA | 0mW
Q19(2N3904) | 1,48V | 0mA | 0mW

Cuadro 4.2: Segundo punto de operación.

24 | Mediciones | 1er c. 2019

Circuitos electrónicos II - 66.10
Diseño de circuitos electrónicos - 86.10 | Trabajo práctico final

### 4.2. Ancho de banda

Para la medición del ancho de banda, se buscaron las frecuencias de corte para una señal tal que sea el 10% de la potencia máxima de 40W especificada. Por lo tanto, se obtiene que la tensión de salida deberá tener un valor de vout = 8,9V, y las frecuencias de corte se determinaran cuando vout ≈ 8,48V.

Se pueden observar los resultados de la medición en el cuadro [4.3].

Frecuencia | Vout | P | Fase
10Hz | 7,2V | 3,24W | 38,9°
17,32Hz | 8,4V | 4,41W | 23,13◦
100Hz | 8,9V | 5W | -
1kHz | 8,9V | 5W | -
10kHz | 8,9V | 5W | -
42,3kHz | 8,4V | 4,41W | 0,12°
100kHz | 8V | 4W | 29,52°

Cuadro 4.3: Valores significativos del ancho de banda a baja potencia.

En el cuadro [4.4] se comparan los ancho de banda obtenidos por simulación, los medidos y los especifi-

cados:

Valor | Especificación | Simulación | Medición
fl | 10Hz | 22,34Hz | 17,32Hz
fh | 50kHz | 97,92kHz | 42,3kHz

Cuadro 4.4: Comparación de ancho de banda a baja potencia

En la figura [4.1] se muestra la medición para el valor de fl para baja potencia, y en las figuras [4.2] y [4.3], se muestran las mediciones para el cálculo de la fase de corrimiento de las señales.

1

er c. 2019 | Mediciones | 25

Circuitos electrónicos II - 66.10
Diseño de circuitos electrónicos - 86.10 | Trabajo práctico final

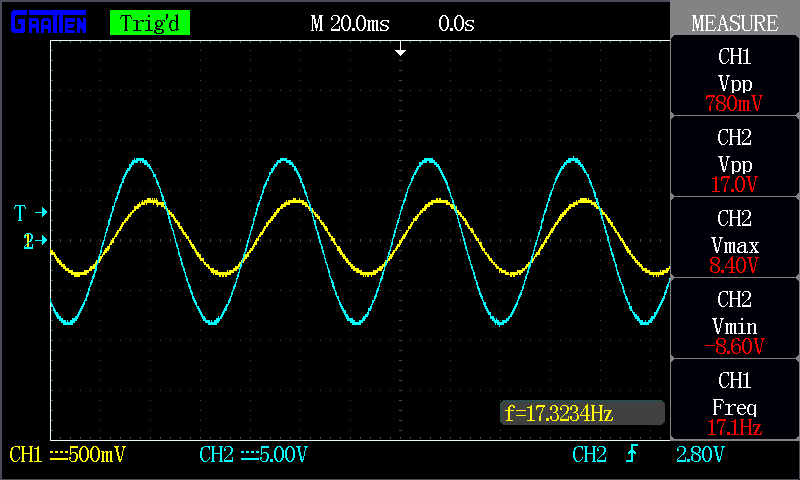
[picture p56: figure]

Figura 4.1: Medición de fl a baja potencia, mostrando el corrimiento de fase.

26 | Mediciones | 1er c. 2019

Circuitos electrónicos II - 66.10
Diseño de circuitos electrónicos - 86.10 | Trabajo práctico final

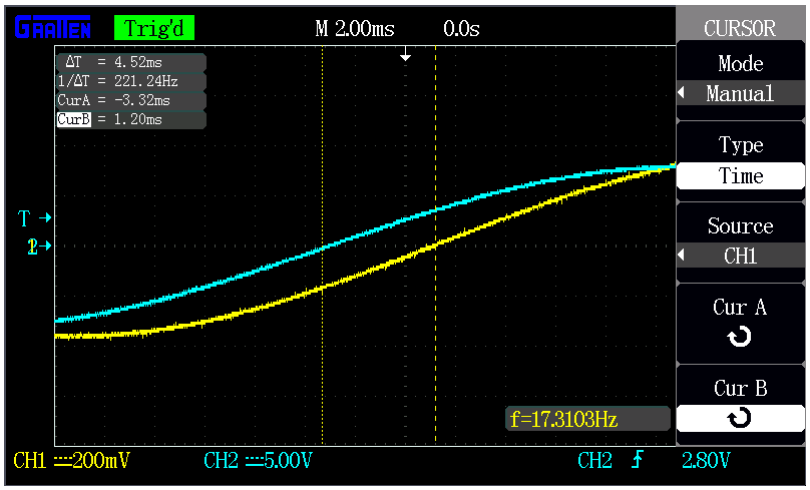
[picture p57: figure]

Figura 4.2: Cálculo del corrimiento de fase para fl a baja potencia.

1

er c. 2019 | Mediciones | 27

Circuitos electrónicos II - 66.10
Diseño de circuitos electrónicos - 86.10 | Trabajo práctico final

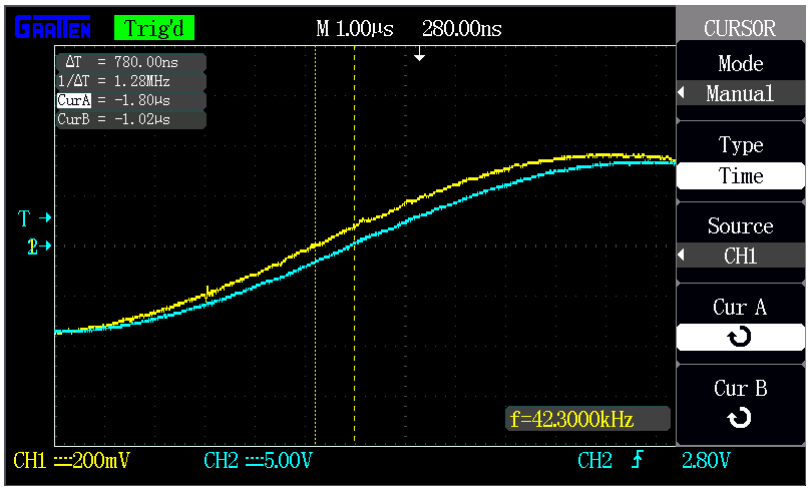
[picture p58: figure]

Figura 4.3: Cálculo del corrimiento de fase para fh a baja potencia.

### 4.3. Ancho de banda de potencia

Para el caso del ancho de banda de potencia, se repite el procedimiento de la sección anterior pero con una señal de salida Vout = 25,3V a máxima potencia (40W). En este caso, las frecuencias de corte se determinan

cuando Vout = 24V.

Se pueden observar los resultados de la medición en el cuadro [4.5].

Frecuencia | Vout | P | Fase
10Hz | 20,8V | 27,09W | 49,32°
19,75Hz | 24V | 4,41W | 24,56°
100Hz | 25,3V | 5W | -
1kHz | 25,3V | 5W | -
10kHz | 25,3V | 5W | -
37,54kHz | 24V | 4,41W | 23,09°

Cuadro 4.5: Valores significativos del ancho de banda a máxima potencia.

En el cuadro [4.6] se comparan los anchos de banda obtenidos por simulación, los medidos y los especi-

ficados:

28 | Mediciones | 1er c. 2019

Circuitos electrónicos II - 66.10
Diseño de circuitos electrónicos - 86.10 | Trabajo práctico final
Valor | Especificación | Simulación | Medición
fl | − | 22,34Hz | 19,75Hz
fh | 30kHz | 97,84kHz | 37,54kHz

Cuadro 4.6: Comparación de ancho de banda a máxima potencia

En las figuras [4.4] y [4.5], se muestran las mediciones para el cálculo de la fase de corrimiento de las

señales.

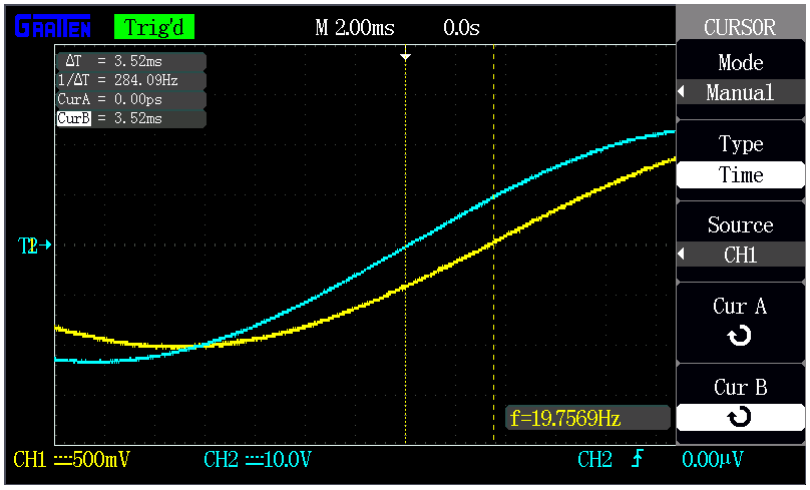
[picture p59: figure]

Figura 4.4: Medición de fl a máxima potencia, mostrando el corrimiento de fase.

1

er c. 2019 | Mediciones | 29

Circuitos electrónicos II - 66.10
Diseño de circuitos electrónicos - 86.10 | Trabajo práctico final

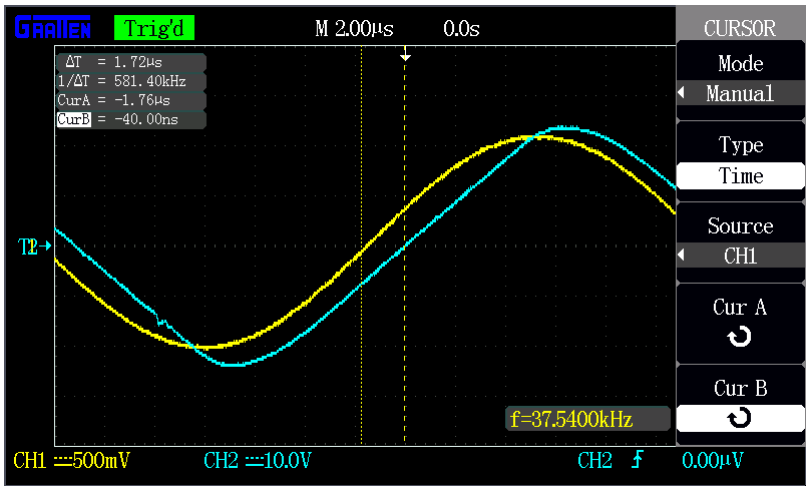
[picture p60: figure]

Figura 4.5: Medición de fl a máxima potencia, mostrando el corrimiento de fase.

### 4.4. Sensibilidad

Se midió el valor eficaz de una señal senoidal de 1kHz aplicada a la entrada vin = 1,08V, que produce la potencia especificada a la salida con carga nominal, siendo esta última vout = 25,2V. Se verifica dicha medición en la figura [4.6].

30 | Mediciones | 1er c. 2019

Circuitos electrónicos II - 66.10
Diseño de circuitos electrónicos - 86.10 | Trabajo práctico final

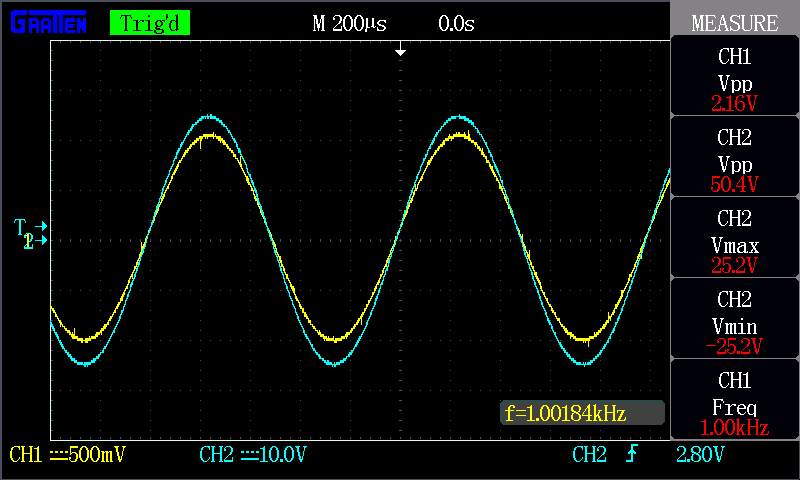
[picture p61: figure]

Figura 4.6: Medición de la sensibilidad del circuito amplificador.

### 4.5. THD

### 4.6. Slew Rate

Se aplicó una señal cuadrada de máxima potencia a modo de obtener el valor numérico del SR, calculando la pendiente de la recta obtenida en la figura [4.8]. Antes, se verficó en la figura [4.7] que el tiempo de

crecimiento de la fuente generadora de señal sea lo suficientemente baja para poder garantizar una correcta medición, siendo este tiempo de τ = 264ns.

1

er c. 2019 | Mediciones | 31

Circuitos electrónicos II - 66.10
Diseño de circuitos electrónicos - 86.10 | Trabajo práctico final

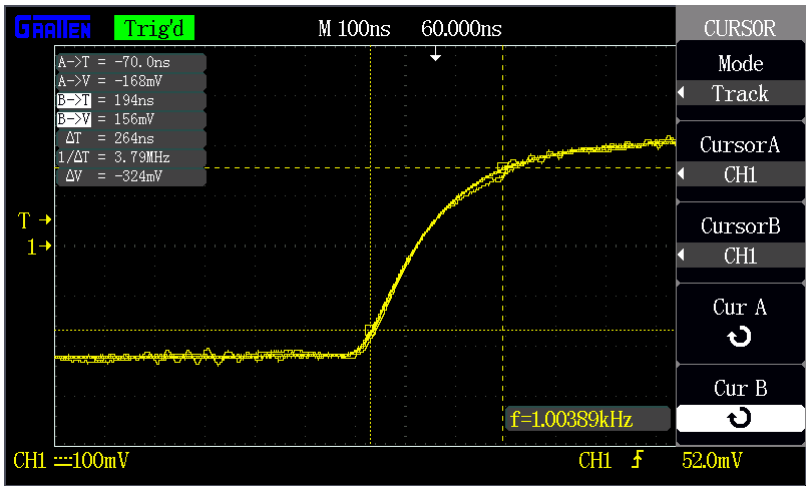
[picture p62: figure]

Figura 4.7: Verificación de tiempo de crecimiento del generador.

32 | Mediciones | 1er c. 2019

Circuitos electrónicos II - 66.10
Diseño de circuitos electrónicos - 86.10 | Trabajo práctico final

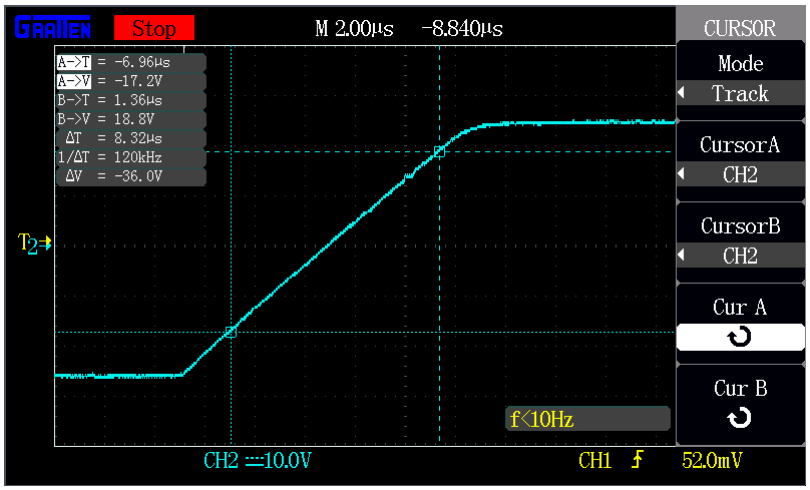
[picture p63: figure]

Figura 4.8: Medición del Slew Rate del circuito amplificador.

Mediante el cálculo pertinente, y comparando con las simulaciones, se obtiene el cuadro comparativo [4.7]:

Valor | Especificación | Simulación | Medición
Slew Rate | 5V/µs | 4,79V/µs | 4,32V/µs

Cuadro 4.7: Comparación del Slew Rate.

1

er c. 2019 | Mediciones | 33

Circuitos electrónicos II - 66.10
Diseño de circuitos electrónicos - 86.10 | Trabajo práctico final

## 5. Observaciones y conclusiones

34 | Observaciones y conclusiones | 1er c. 2019

Facultad de Ingeniería - UBA

Circuitos electrónicos II - 66.10
Diseño de circuitos electrónicos - 86.10 | Trabajo práctico final

## 6. Bibliografía

## Referencias

[1] Analysis and Design of Analog Integrated Circuits (3rd Edition)

Author: Paul R. Gray
Author: Robert G. Meyer
Publisher: John Wiley & Sons, Inc.; 3rd Edition (Janury 15, 1993)

Copyright: © 1993, John Wiley & Sons, Inc.

ISBN 10: 0471574953
Website: Analysis and Design of Analog Integrated Circuits (3rd Edition) (http://www.wiley.com/WileyCDA/WileyTitle/productCd-EHEP000220.html)
[2] Analysis and Design of Analog Integrated Circuits (4th Edition)

Author: Paul R. Gray
Author: Paul J. Hurst
Author: Stephen H. Lewis
Author: Robert G. Meyer
Publisher: John Wiley & Sons, Inc.; 4th Edition (2001)

Copyright: © 2001, John Wiley & Sons, Inc.

ISBN 10: 0471321680
ISBN 13: 9780471321682
Website: Analysis and Design of Analog Integrated Circuits (4th Edition) (http://www.wiley.com/WileyCDA/WileyTitle/productCd-EHEP000220.html)
[3] Analysis and Design of Analog Integrated Circuits (5th Edition)

Author: Paul R. Gray
Author: Paul J. Hurst
Author: Stephen H. Lewis
Author: Robert G. Meyer
Publisher: John Wiley & Sons, Inc.; 5th Edition (2009)

Copyright: © 2001, John Wiley & Sons, Inc.

ISBN 10: 0470245999
ISBN 13: 9780470245996
Website: Analysis and Design of Analog Integrated Circuits (5th Edition) (https://www.wiley.com/en-ar/Analysis+and+Design+of+Analog+Integrated+Circuits%2C+5th+Edition-p-9780470245996)

1

er c. 2019 | Bibliografía | 35

Facultad de Ingeniería - UBA

Circuitos electrónicos II - 66.10
Diseño de circuitos electrónicos - 86.10 | Trabajo práctico final
[4] Circuitos microelectrónicos (4ta Edición) español

Author: Adel. S. Sedra
Author: Kenneth C. Smith
Publisher: Oxford, University press; 4ta Edición (2001)

Copyright: © 1999, Oxford, University press México.
Original Copyright: © 1998, 1991, 1987, 1982, Oxford, University press Inc.

ISBN 10: 01951166310
Website: Circuitos microelectrónicos (4ta Edición) español (http://www.oup.com/us/companion.websites/0195142519/)
[5] Microelectronic circuits (5th Edition)

Author: Adel. S. Sedra
Author: Kenneth C. Smith
Publisher: Oxford, University press; 5th Edition (2004)

Copyright: © 2004, 1998, 1991, 1987, 1982, Oxford, University press Inc.

ISBN 10: 0195142527
Website: Microelectronic circuits (5th Edition) (http://www.oup.com/us/companion.websites/0195142519/)
[6] AUDIO POWER AMPLIFIER DESIGN HANDBOOK (5th Edition)

Author: Douglas Self
Publisher: Elsevier Ltd; 5th Edition (2009)

Copyright: © 2009, Douglas Self. Published by Elsevier Ltd. All rights reserved.

ISBN 13: 9780240521626
Website: AUDIO POWER AMPLIFIER DESIGN HANDBOOK (5th Edition) (http://douglas-self.com/ampins/books/book.htm)
36 | Bibliografía | 1er c. 2019

Circuitos electrónicos II - 66.10
Diseño de circuitos electrónicos - 86.10 | Trabajo práctico final

# Apéndices

## A. Hojas de datos

A.1. BD135

NPN Plastic Medium-Power Silicon Transistors
Manufacturer page: https://www.onsemi.com/PowerSolutions/product.do?id=BD135 Manufacturer Datasheet: https://www.onsemi.com/pub/Collateral/BD135-D.PDF

A.2. BD136

PNP Plastic Medium-Power Silicon Transistors
Manufacturer page: https://www.onsemi.com/PowerSolutions/product.do?id=BD136 Manufacturer Datasheet: https://www.onsemi.com/pub/Collateral/BD136G-D.PDF

A.3. BC556

PNP Silicon Transistor
Manufacturer page: https://www.onsemi.com/PowerSolutions/product.do?id=BC556 Manufacturer Datasheet: https://www.onsemi.com/pub/Collateral/BC556BTA-D.pdf

A.4. MJL21193

PNP Bipolar Power Transistor
Manufacturer page: https://www.onsemi.com/PowerSolutions/product.do?id=MJL21193 Manufacturer Datasheet: https://www.onsemi.com/pub/Collateral/MJL21193-D.PDF

A.5. MJL21194

NPN Bipolar Power Transistor
Manufacturer page: https://www.onsemi.com/PowerSolutions/product.do?id=MJL21194 Manufacturer Datasheet: https://www.onsemi.com/pub/Collateral/MJL21193-D.PDF

1

er c. 2019 | 37

Circuitos electrónicos II - 66.10
Diseño de circuitos electrónicos - 86.10 | Trabajo práctico final
A.6. | 1N4148

Small signal diode
Manufacturer page: https://www.onsemi.com/PowerSolutions/product.do?id=1N4148 Manufacturer Datasheet: https://www.vishay.com/docs/81857/1n4148.pdf

A.7. 1N4370

Zener Voltage Regulator Diode
Manufacturer page: https://www.microsemi.com/existing-parts/parts/121321
Manufacturer Datasheet: http://pdf.datasheetcatalog.com/datasheet/microsemi/1N746_759A_4370_4372A.pdf

A.8. 1N4007

Silicon rectifier diode
Manufacturer page: https://www.onsemi.com/products/discretes-drivers/diodes-rectifiers/rectifiers/1n4007 Manufacturer Datasheet: http://pdf.datasheetcatalog.com/datasheet/fairchild/1N4007.pdf

A.9. 1N5822

Schottky Barrier Rectifier
Manufacturer page: https://www.onsemi.com/products/discretes-drivers/diodes-rectifiers/schottky-diodes-schottky-rectifiers/1n5822 (https://www.onsemi.com/products/discretes-drivers/diodes-rectifiers/schottky-diodes-schottky-rectifiers/1n5822)
Manufacturer Datasheet: https://www.onsemi.com/pub/Collateral/1N5820-D.PDF

A.10. Metal film resistor

Metal film resistor
Manufacturer page: https://www.vishay.com/resistors-fixed/metal-film/tab/doclibrary/

A.11. Carbon film resistor

Carbon film resistor
Manufacturer page: http://www.vishay.com/resistors-fixed/carbon-film/tab/doclibrary/
38 | Hojas de datos | 1er c. 2019

Circuitos electrónicos II - 66.10
Diseño de circuitos electrónicos - 86.10 | Trabajo práctico final
A.12. | Ceramic capacitor

Ceramic disk capacitor
Manufacturer page: https://www.vishay.com/capacitors/ceramic/disc/

A.13. Electrolitic Aluminum capacitor

Electrolitic aluminum capacitor
Manufacturer page: https://www.vishay.com/capacitors/aluminum/

1

er c. 2019 | Hojas de datos | 39
