MIDORIINU/DSE-CII/informe/final/informe/TP_Final_med_Informe.tex

\input{config}

%\\\\\\\\\\\\\\\\\\\\\\\\\\\\\\\

%-------------------------------------------------
%--------------- BEGIN DOCUMENT ------------------
%-------------------------------------------------
\begin{document}

%\\\\\\\\\\\\\\\\\\\\\\\\\\\
%Incluyo la caratula
%Caratula
\input{caratula}
\thispagestyle{empty}
\cleardoublepage
%\\\\\\\\\\\\\\\\\\\\\\\\\\\
	
%\\\\\\\\\\\\\\\\\\\\\\\\\\\
%Reinicio la cuenta y seteo el estilo de headers y footers.
\pagestyle{indexstyle}
\pagenumbering{Roman}
\setcounter{page}{1}
%\\\\\\\\\\\\\\\\\\\\\\\\\\\

%\\\\\\\\\\\\\\\\\\\\\\\\\\\
\begin{small}
\tableofcontents 
\addcontentsline{toc}{section}{Índice}
%\phantomsection\pdfbookmark[0]{\indexname}{bookmarkForTheIndex}

\clearpage

\listoffigures

\clearpage

\listoftables

\end{small}

\cleardoublepage
%\\\\\\\\\\\\\\\\\\\\\\\\\\\

%\\\\\\\\\\\\\\\\\\\\\\\\\\\
%Reinicio la cuenta y seteo el stilo de headers y footers.
\pagestyle{allpages}
\setcounter{page}{1}
\pagenumbering{arabic}
%\\\\\\\\\\\\\\\\\\\\\\\\\\\

%\\\\\\\\\\\\\\\\\\\\\\\\\\\
\section{Consideraciones previas al diseño}
\resetallcounters
\input{specs}
\clearpage
%\\\\\\\\\\\\\\\\\\\\\\\\\\\

%%\\\\\\\\\\\\\\\\\\\\\\\\\\\
%\section{Diseño conceptual}
%\resetallcounters
%\input{concept}
%\clearpage
%%\\\\\\\\\\\\\\\\\\\\\\\\\\\
%
%
%%\\\\\\\\\\\\\\\\\\\\\\\\\\\
\section{Diseño circuital}
\resetallcounters
\input{design}
\clearpage
%%\\\\\\\\\\\\\\\\\\\\\\\\\\\
%
%
%%\\\\\\\\\\\\\\\\\\\\\\\\\\\
\section{Simulaciones}
\resetallcounters
\input{simulations}
\clearpage
%%\\\\\\\\\\\\\\\\\\\\\\\\\\\
%
%%\\\\\\\\\\\\\\\\\\\\\\\\\\\
\section{Prototipo}
\resetallcounters
\input{prototype}
\clearpage
%%\\\\\\\\\\\\\\\\\\\\\\\\\\\
%
%%\\\\\\\\\\\\\\\\\\\\\\\\\\\
\section{Validación del prototipo}
\resetallcounters
\input{measurements}
\clearpage
%%\\\\\\\\\\\\\\\\\\\\\\\\\\\

%\\\\\\\\\\\\\\\\\\\\\\\\\\\
\section{Observaciones}
\resetallcounters
\input{observations}
\clearpage
%\\\\\\\\\\\\\\\\\\\\\\\\\\\
%
%\\\\\\\\\\\\\\\\\\\\\\\\\\\
\section{Conclusiones}
\resetallcounters
\input{conclusiones}
\cleardoublepage
%\\\\\\\\\\\\\\\\\\\\\\\\\\\

%\\\\\\\\\\\\\\\\\\\\\\\\\\\
%Reinicio la cuenta y seteo el estilo de headers y footers.
\pagestyle{bibliostyle}
%\\\\\\\\\\\\\\\\\\\\\\\\\\\

%\\\\\\\\\\\\\\\\\\\\\\\\\\\
\section{Bibliografía}
\resetallcounters
\input{bibliografia}
\cleardoublepage
%\\\\\\\\\\\\\\\\\\\\\\\\\\\

%\\\\\\\\\\\\\\\\\\\\\\\\\\\
%Seteo el stilo de headers y footers.
\pagestyle{allpages}
%\\\\\\\\\\\\\\\\\\\\\\\\\\\

\appendix

\appendixpage
\addappheadtotoc

%\\\\\\\\\\\\\\\\\\\\\\\\\\\

\section{Hojas de datos}

\input{datasheets}

\clearpage
%\\\\\\\\\\\\\\\\\\\\\\\\\\\

\end{document}
