MIDORIINU/DSE-CII/LTSPICE/amplifier.pdf

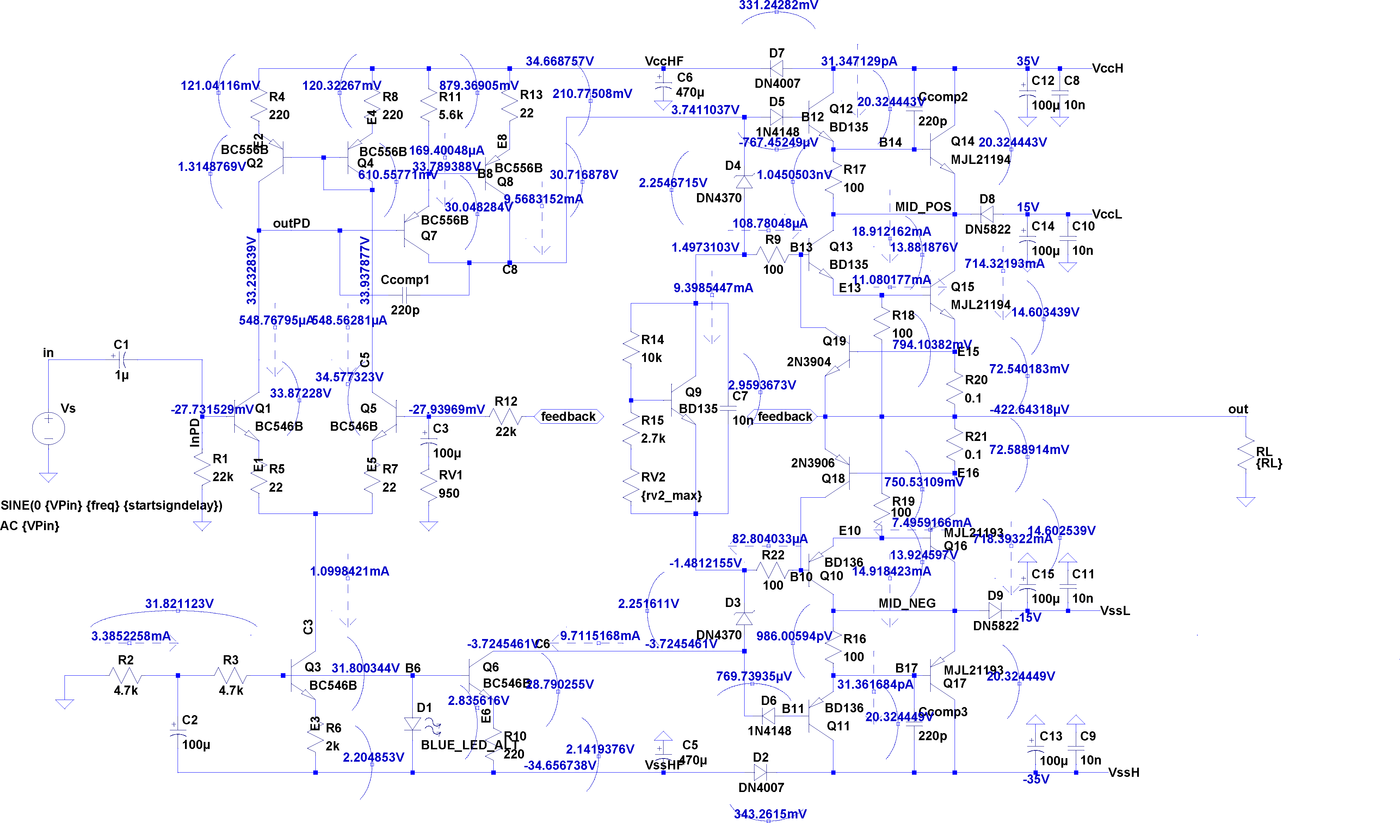
[picture p64: page 1]
