MIDORIINU/DSE-CII/informe/final/informe/img/circuito/PCB_3D.jpeg

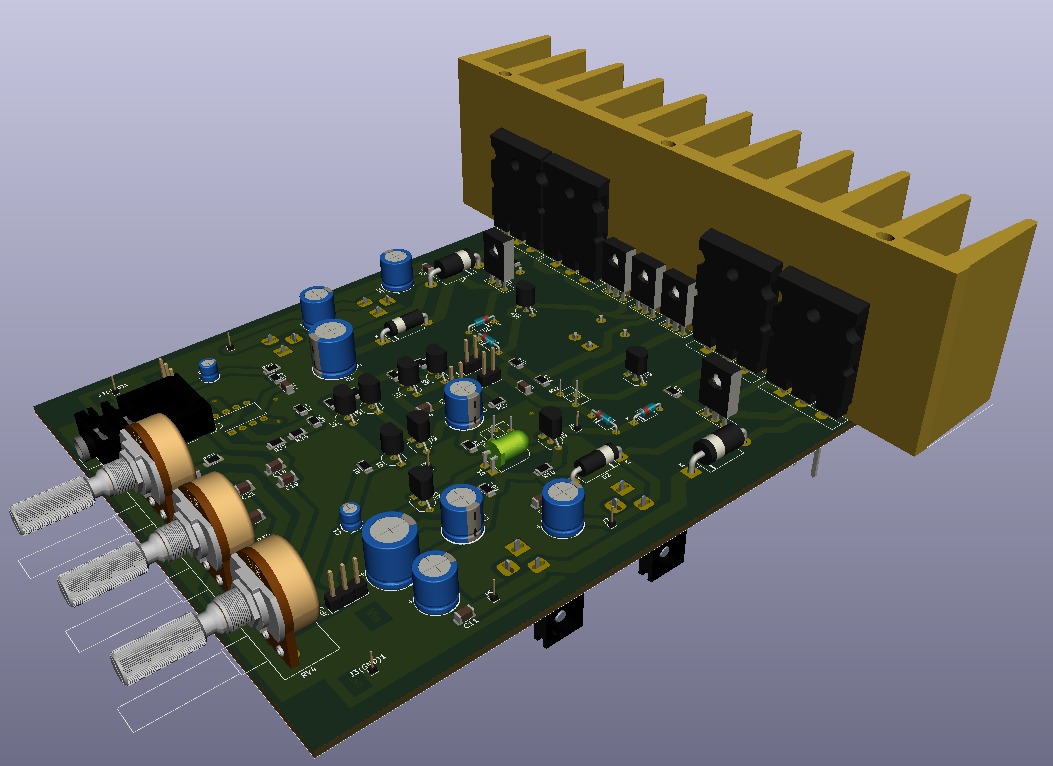
informe/final/informe/img/circuito/PCB_3D.jpeg
