MIDORIINU/DSE-CII/informe/final/informe/img/fotos/final1.jpg

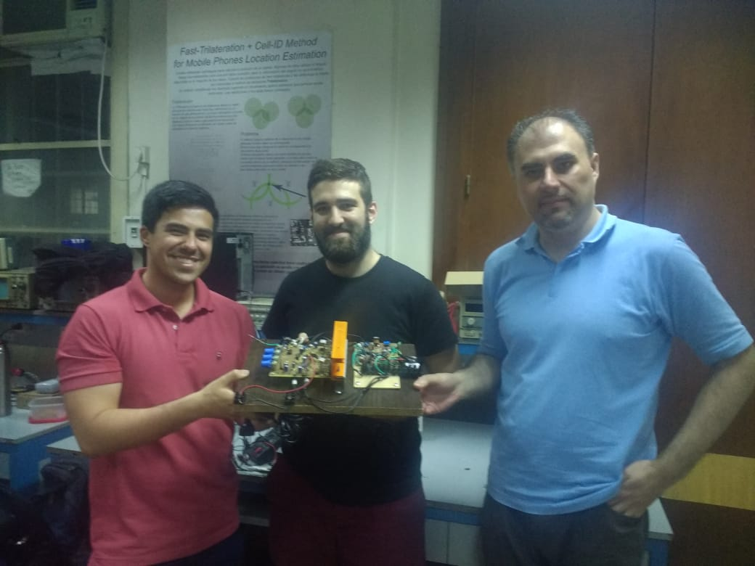
informe/final/informe/img/fotos/final1.jpg
