MIDORIINU/DSE-CII/informe/final/informe/img/fotos/final2.jpg

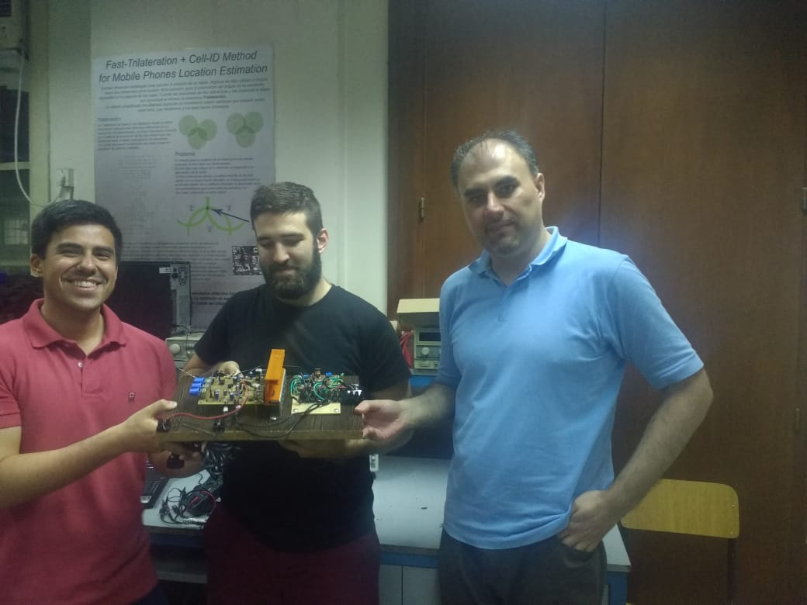
informe/final/informe/img/fotos/final2.jpg
