MIDORIINU/DSE-CII/informe/final/informe/img/fotos/final3.jpg

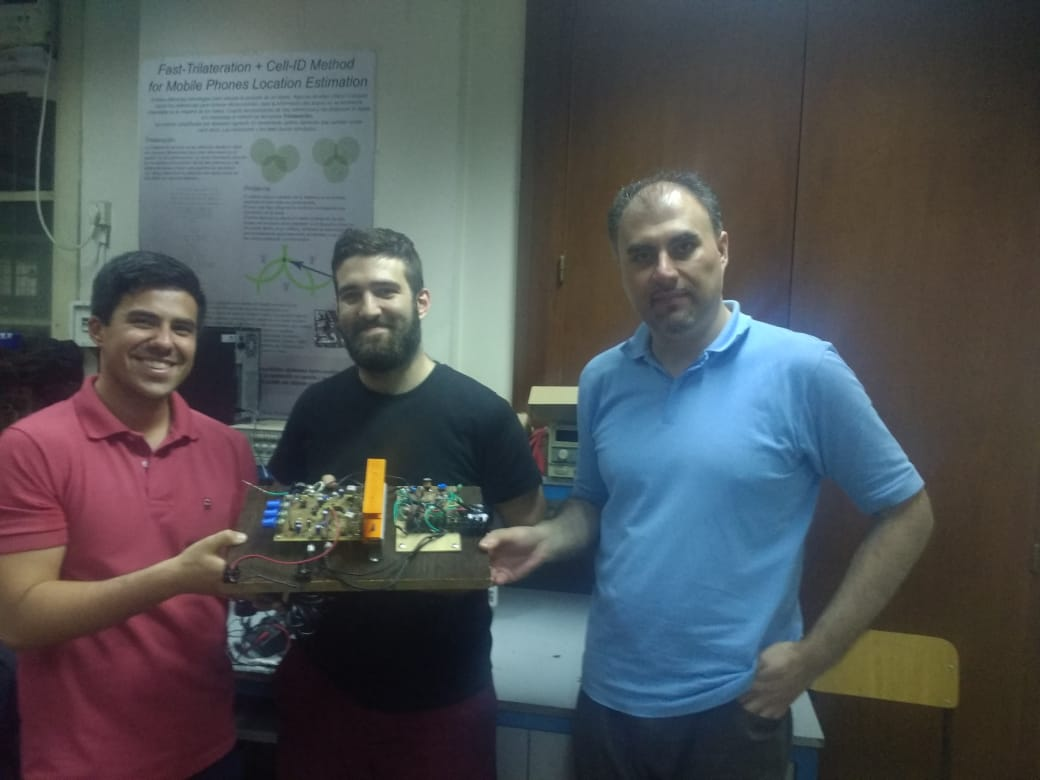
informe/final/informe/img/fotos/final3.jpg
