MIDORIINU/DSE-CII/informe/final/informe/img/instrumentos/osciloscopio1.png

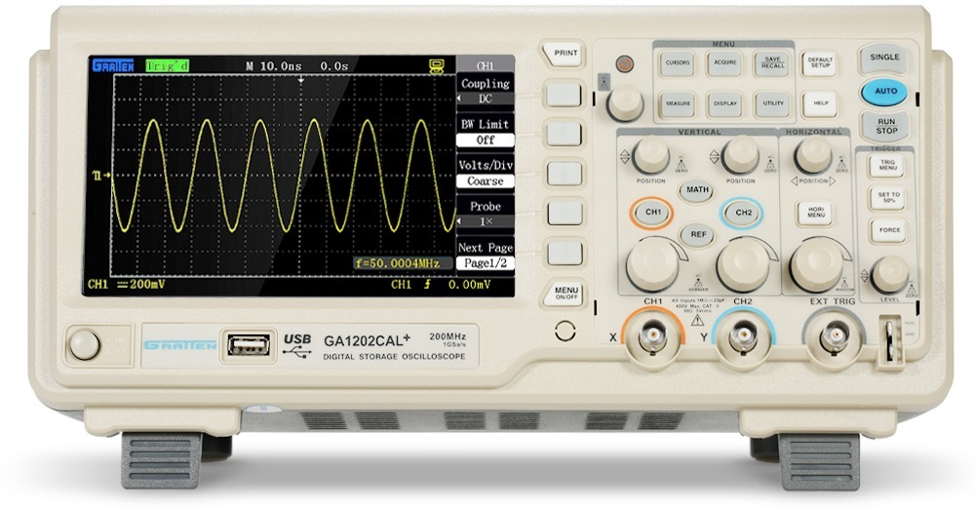
informe/final/informe/img/instrumentos/osciloscopio1.png
