MIDORIINU/DSE-CII/informe/final/informe/img/mediciones/BW_low_power/2.png

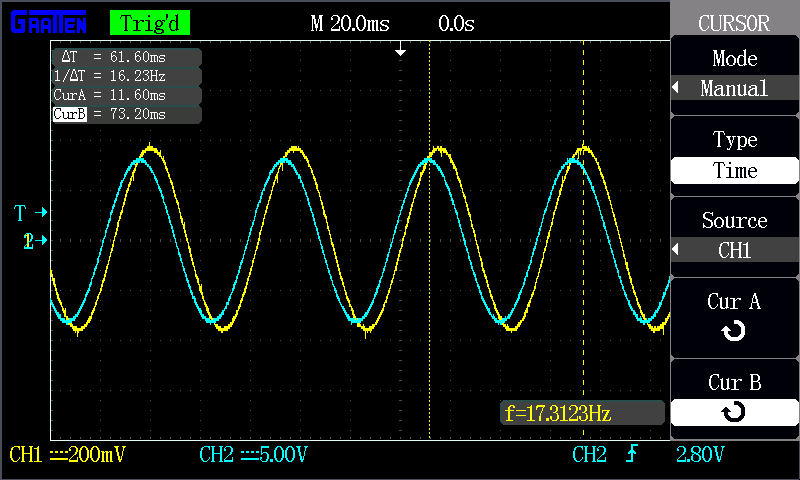
informe/final/informe/img/mediciones/BW_low_power/2.png
