MIDORIINU/DSE-CII/informe/final/informe/img/mediciones/BW_power/1.png

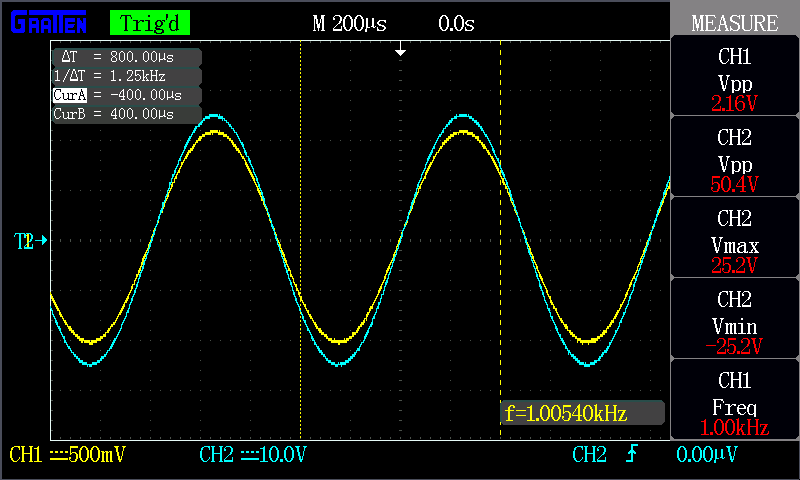
informe/final/informe/img/mediciones/BW_power/1.png
