MIDORIINU/DSE-CII/informe/final/informe/img/mediciones/Photos/3.jpg

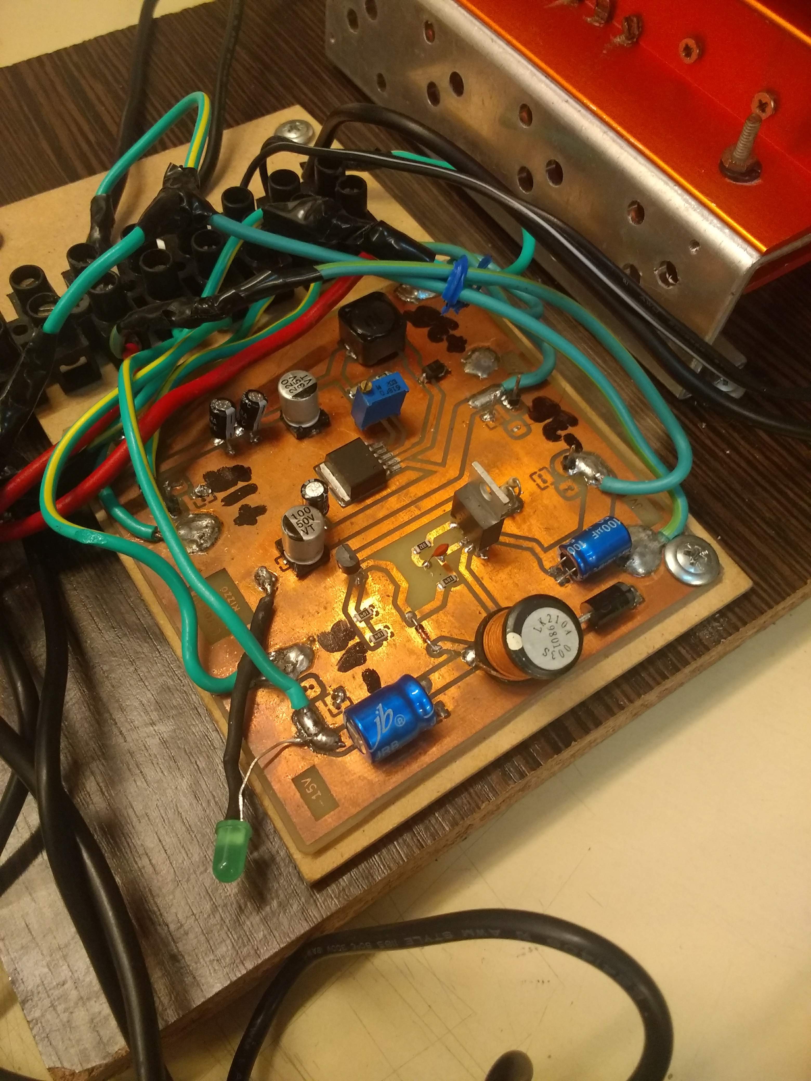
informe/final/informe/img/mediciones/Photos/3.jpg
