MIDORIINU/DSE-CII/informe/final/informe/img/mediciones/Photos/5.jpg

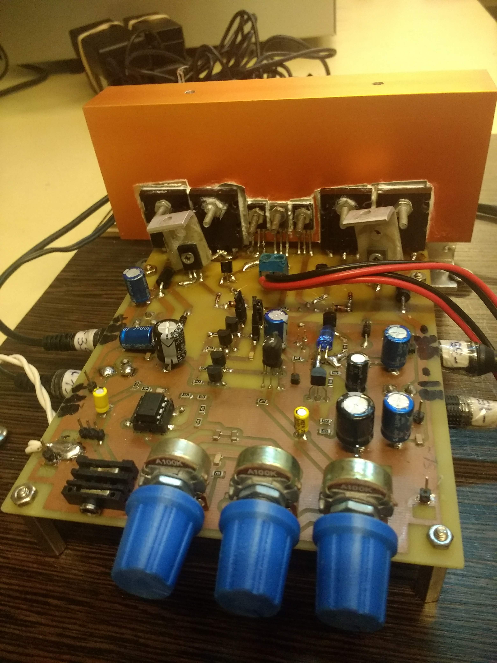
informe/final/informe/img/mediciones/Photos/5.jpg
