MIDORIINU/DSE-CII/informe/final/informe/img/mediciones/Photos/6.jpg

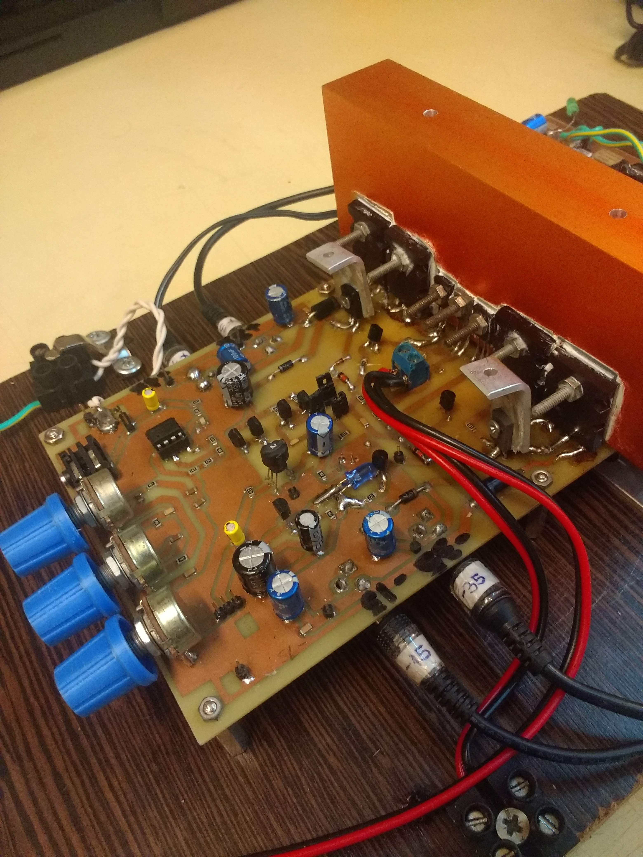
informe/final/informe/img/mediciones/Photos/6.jpg
