MIDORIINU/DSE-CII/informe/final/informe/img/mediciones/Photos/7.jpg

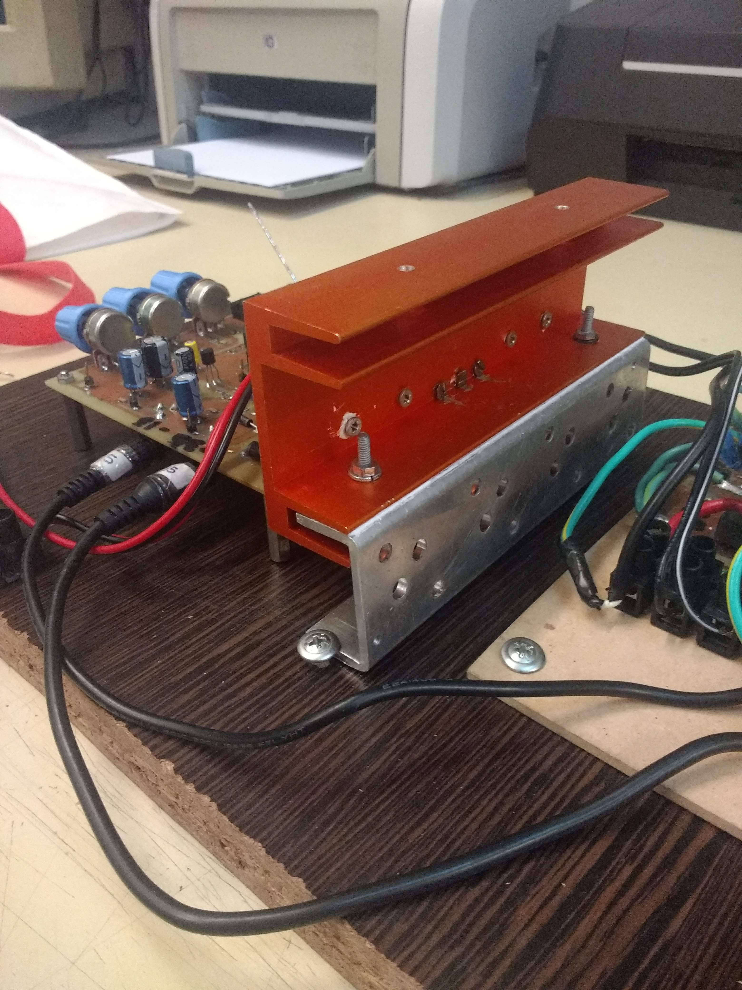
informe/final/informe/img/mediciones/Photos/7.jpg
