MIDORIINU/DSE-CII/informe/final/informe/img/mediciones/Photos/9.jpg

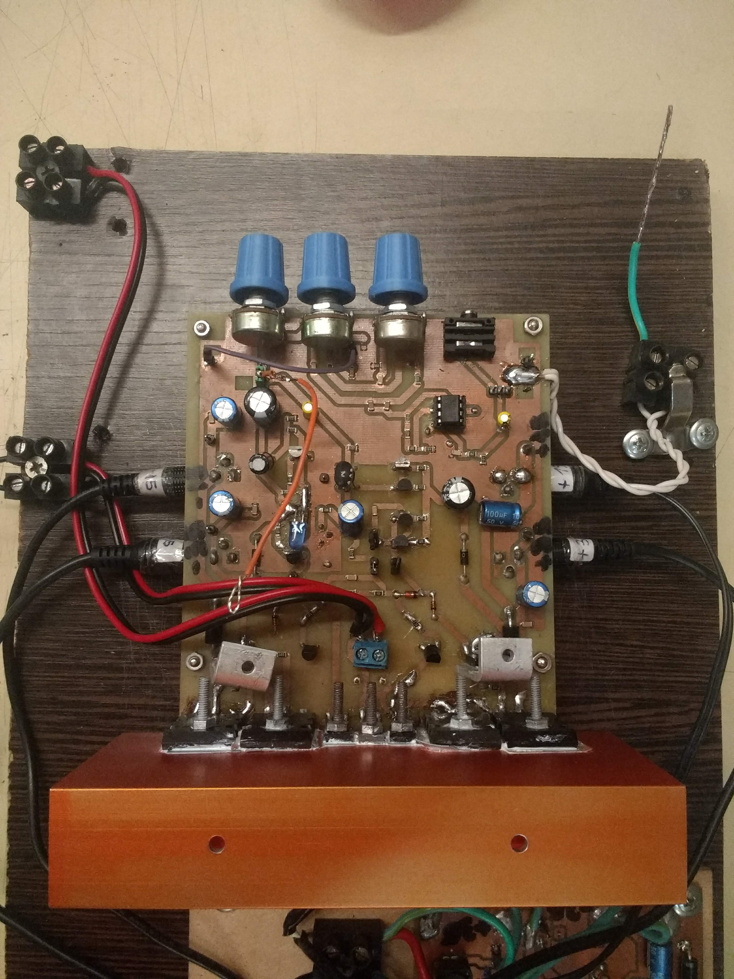
informe/final/informe/img/mediciones/Photos/9.jpg
