MIDORIINU/DSE-CII/informe/final/informe/img/mediciones/Slew_Rate/3.png

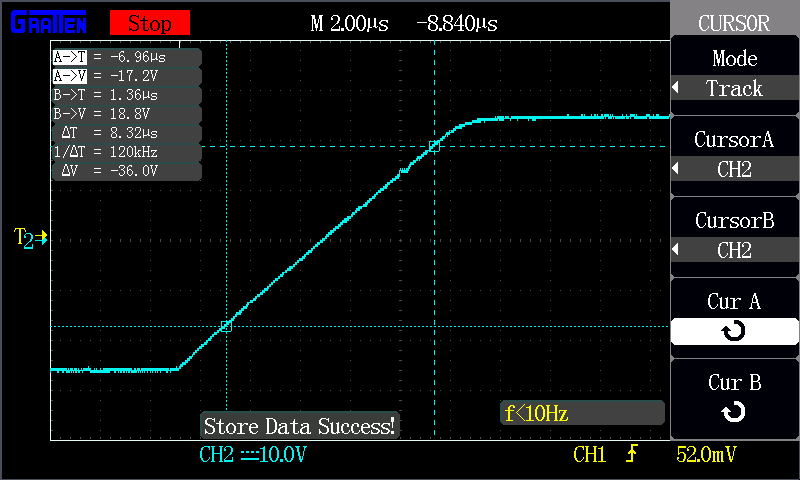
informe/final/informe/img/mediciones/Slew_Rate/3.png
