MIDORIINU/DSE-CII/informe/final/informe/img/mediciones/THD/10khz.png

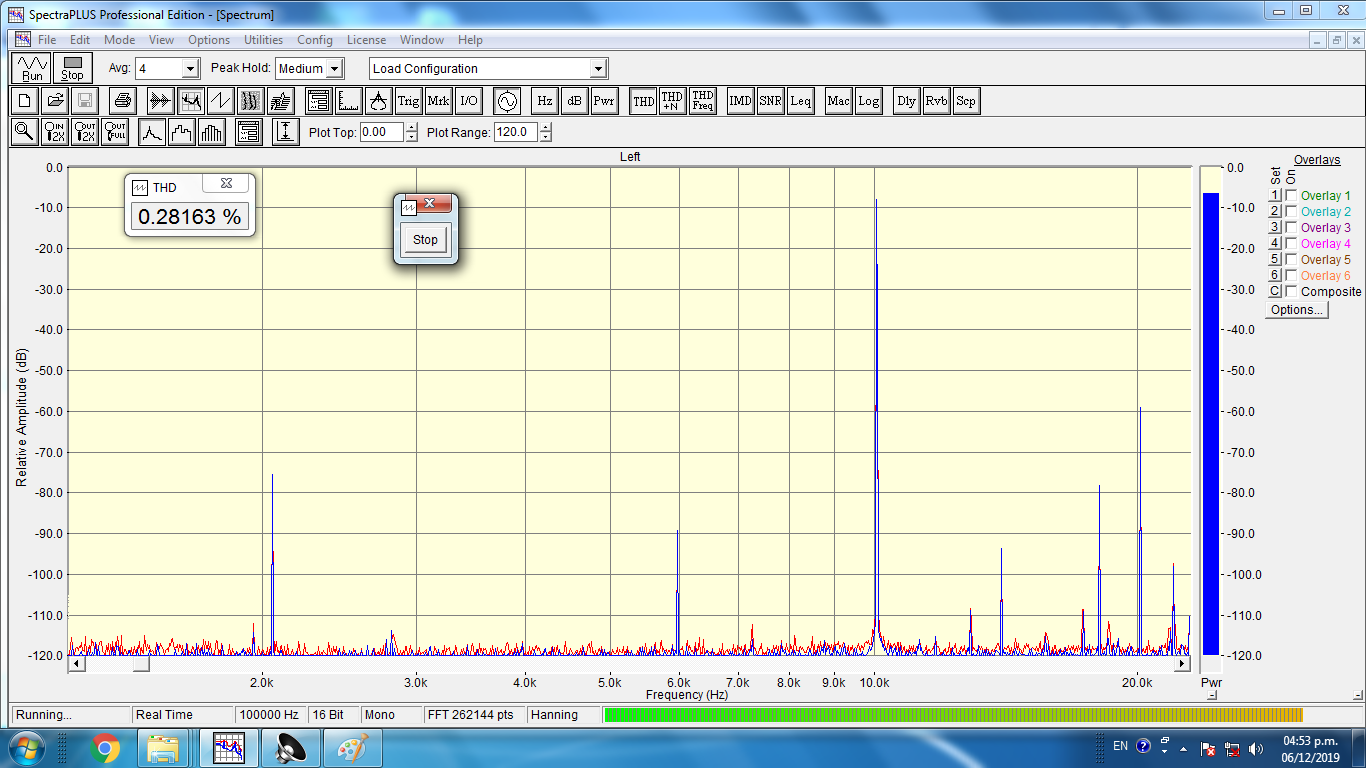
informe/final/informe/img/mediciones/THD/10khz.png
