MIDORIINU/DSE-CII/informe/final/informe/img/mediciones/THD/11khz.png

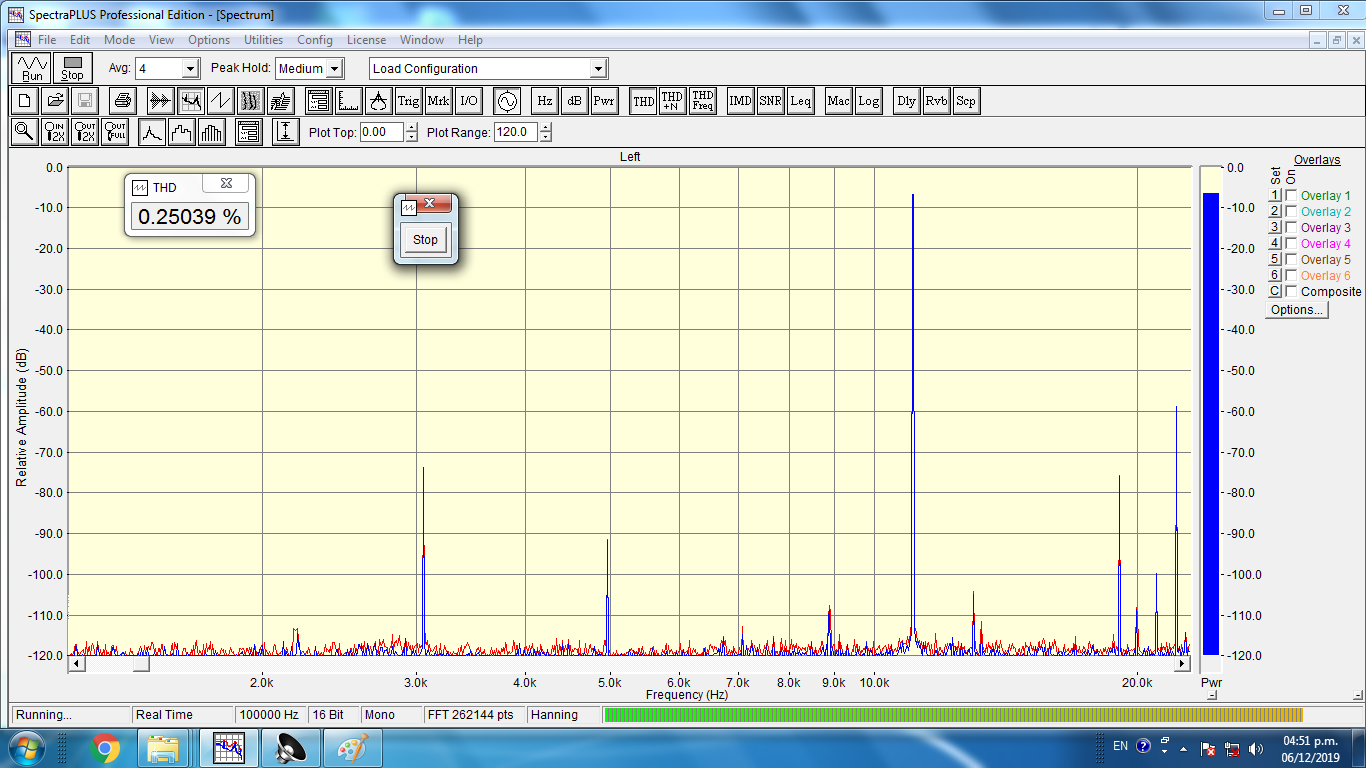
informe/final/informe/img/mediciones/THD/11khz.png
