MIDORIINU/DSE-CII/informe/final/informe/img/mediciones/THD/20khz.png

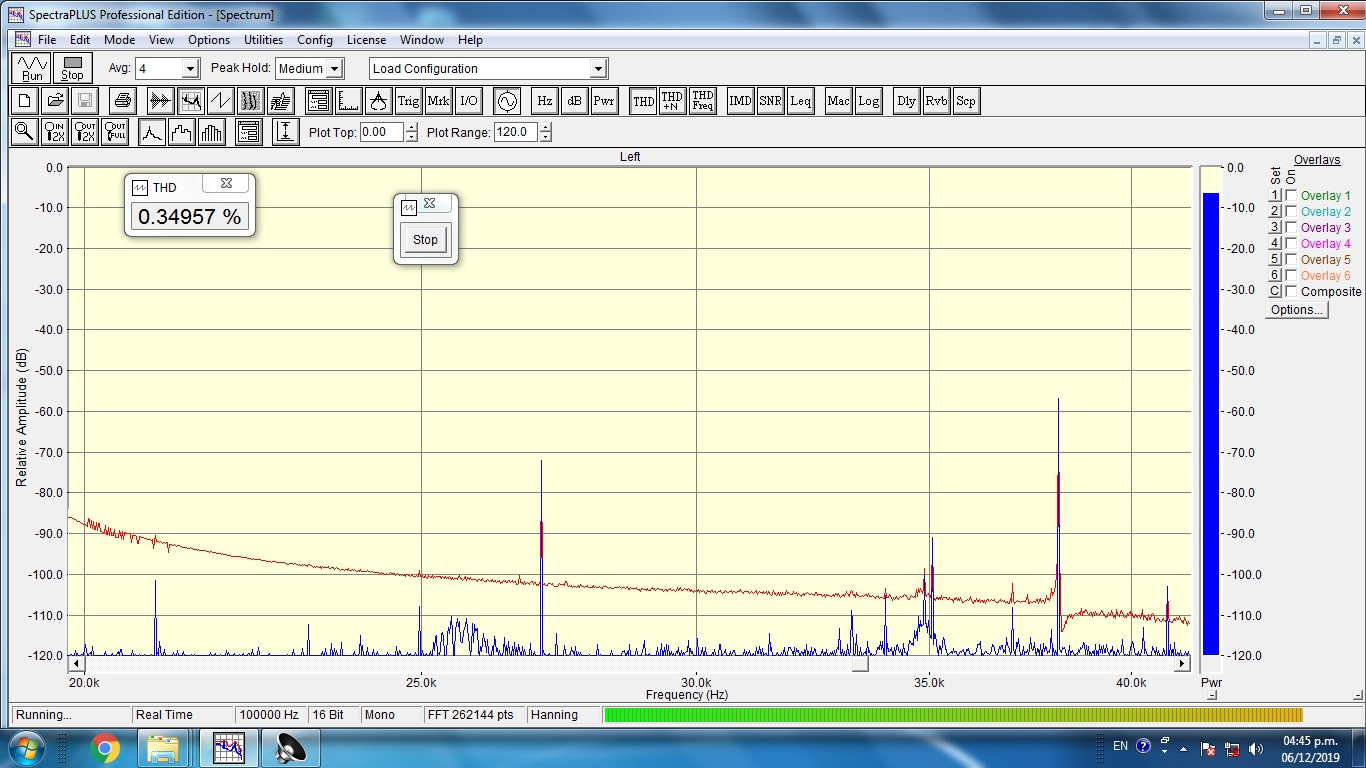
informe/final/informe/img/mediciones/THD/20khz.png
