MIDORIINU/DSE-CII/informe/final/informe/img/simulaciones/Efficiency/Efficiency_vs_power_sim_org.png

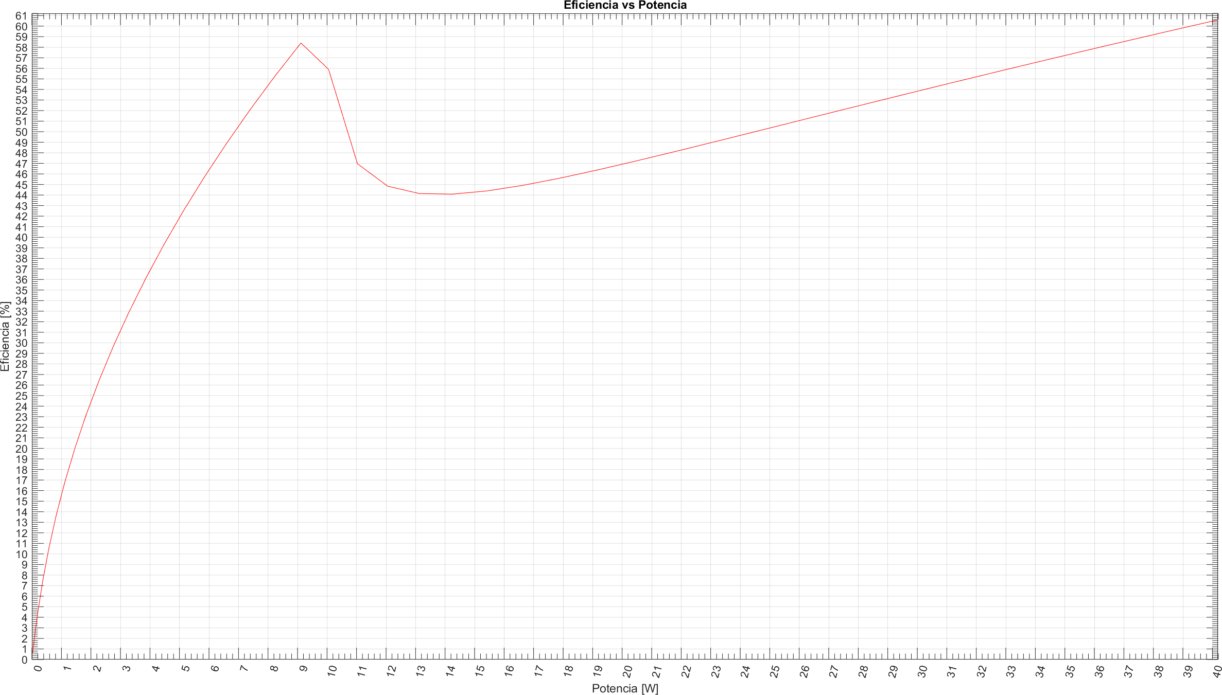
informe/final/informe/img/simulaciones/Efficiency/Efficiency_vs_power_sim_org.png
