MIDORIINU/DSE-CII/instrumentos/multímetro1.png

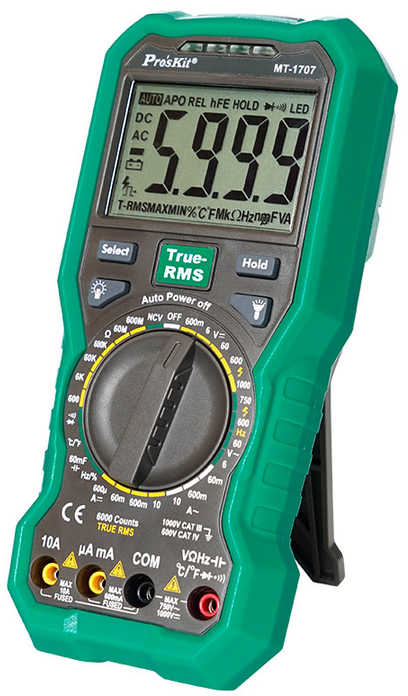
instrumentos/multímetro1.png
