MIDORIINU/DSE-CII/LTSPICE/amplifier/plots/amplifier_LOOP.png

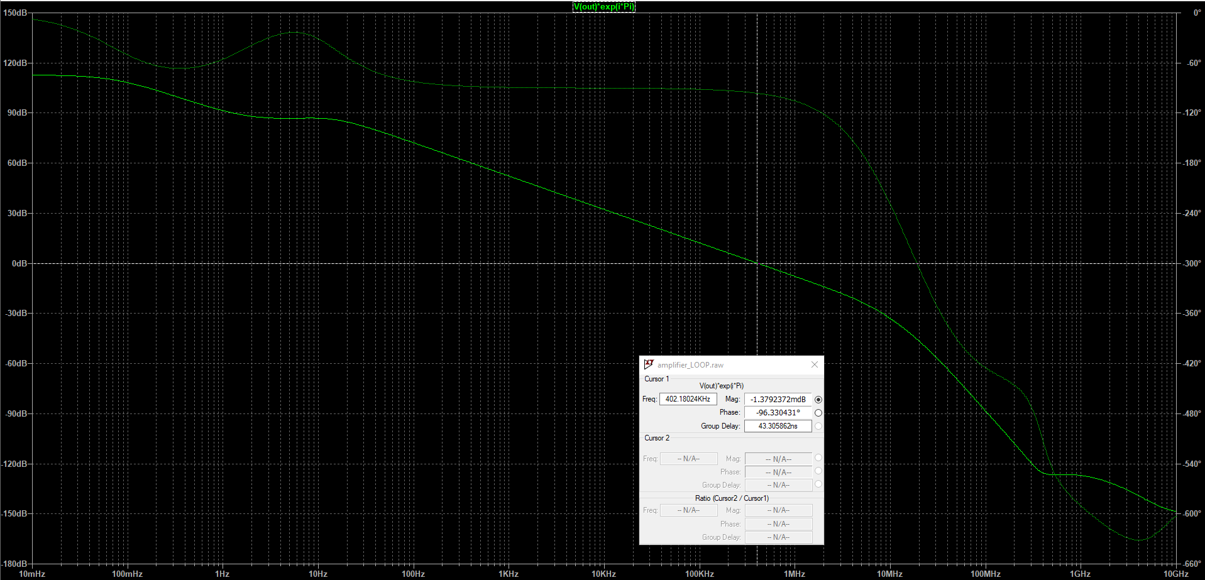
LTSPICE/amplifier/plots/amplifier_LOOP.png
