MIDORIINU/DSE-CII/LTSPICE/amplifier/plots/amplifier_POWER_BW.png

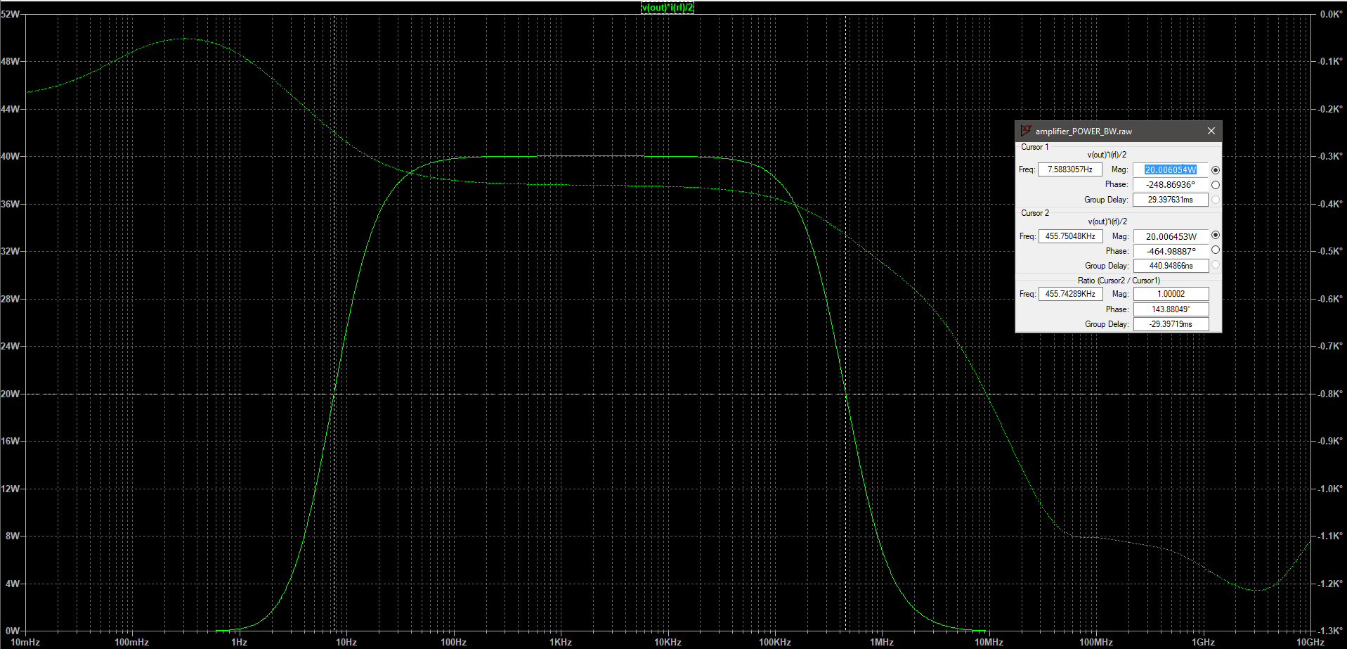
LTSPICE/amplifier/plots/amplifier_POWER_BW.png
