MIDORIINU/DSE-CII/LTSPICE/amplifier/plots/amplifier_SWITCHING.png

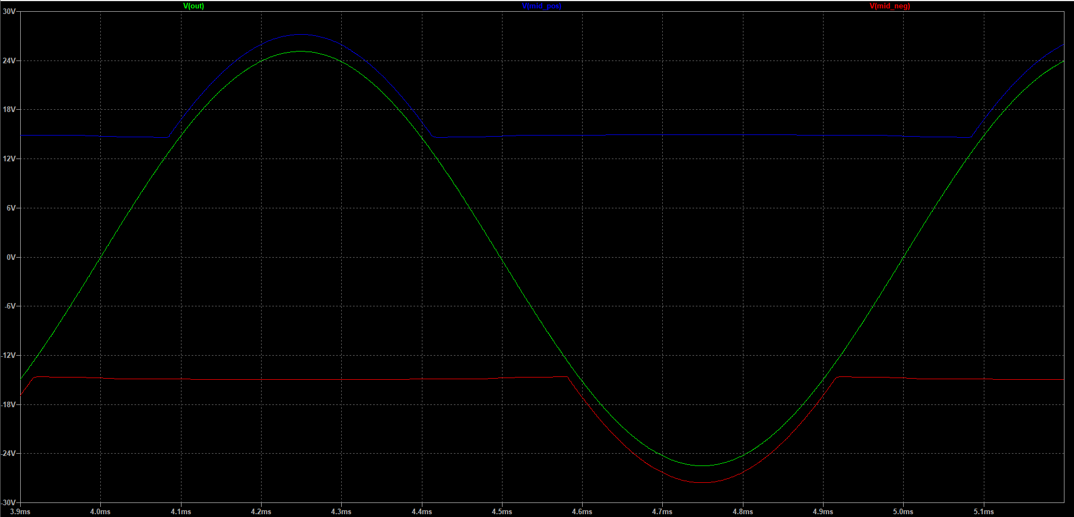
LTSPICE/amplifier/plots/amplifier_SWITCHING.png
