MIDORIINU/DSE-CII/LTSPICE/amplifier/plots/amplifier_Zi.png

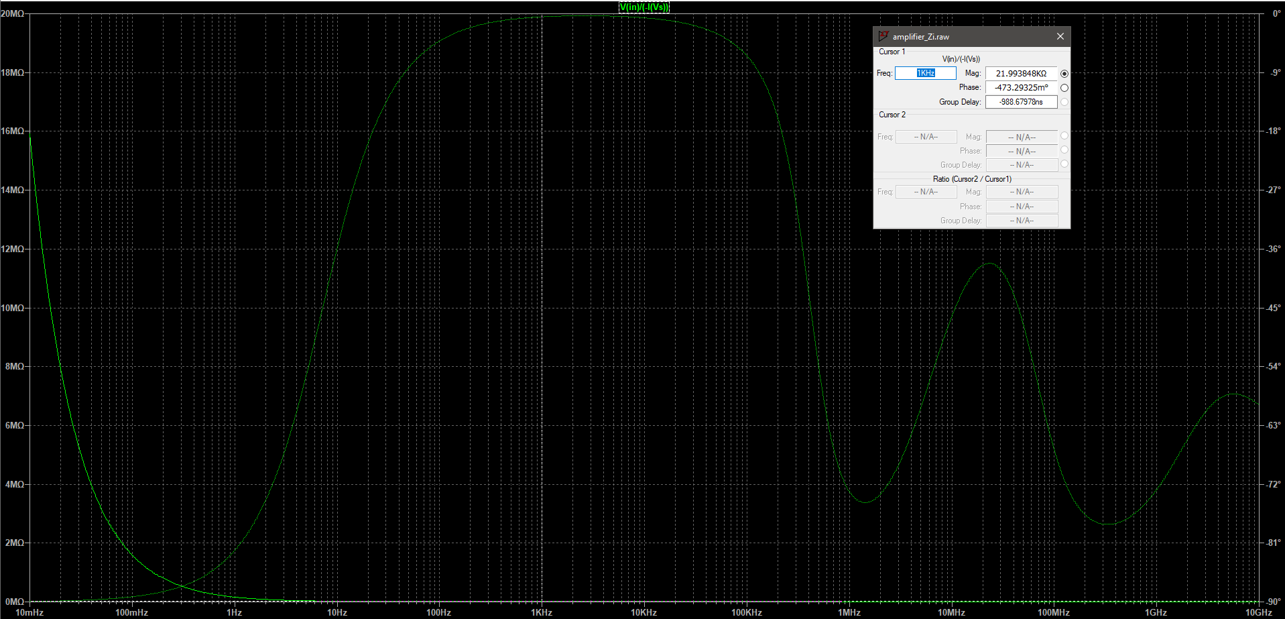
LTSPICE/amplifier/plots/amplifier_Zi.png
