MIDORIINU/DSE-CII/LTSPICE/amplifier/plots/amplifier_Zo.png

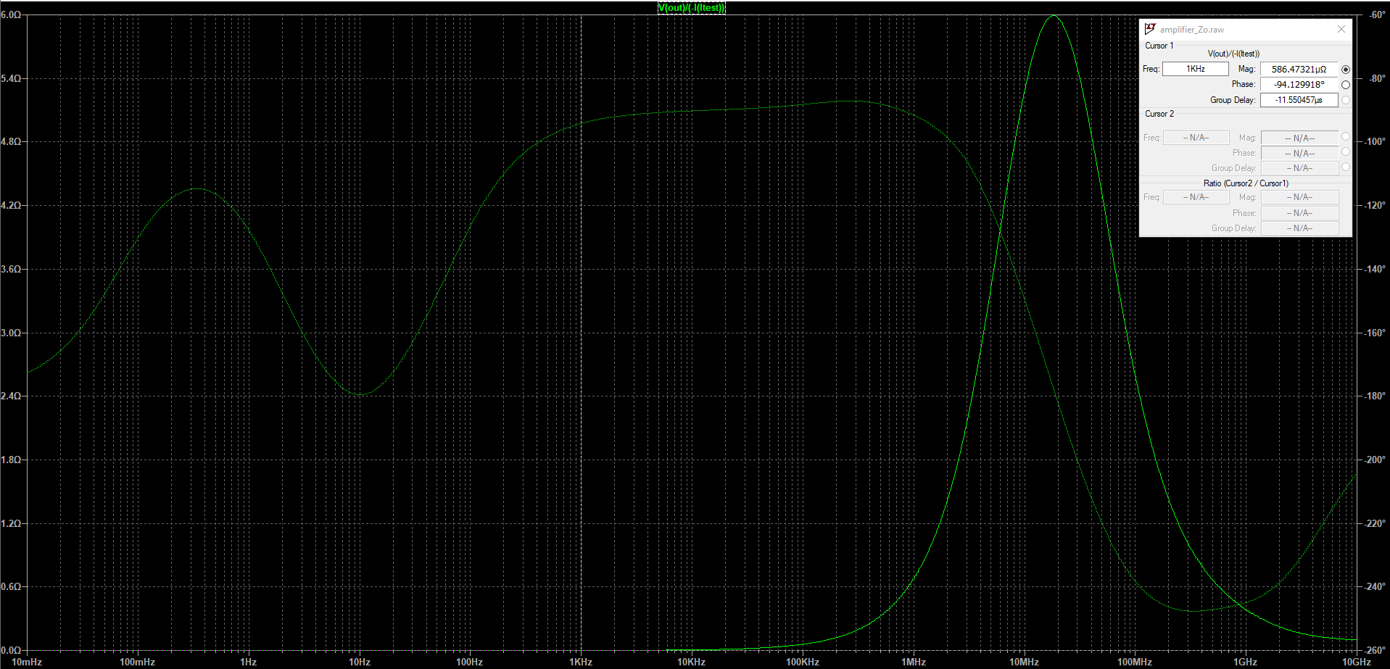
LTSPICE/amplifier/plots/amplifier_Zo.png
