MIDORIINU/DSE-CII/Mediciones/Ancho de banda 1W/0.9W - 18Hz.jpeg

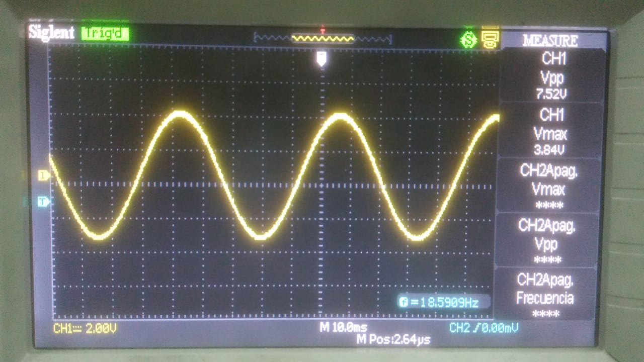
Mediciones/Ancho de banda 1W/0.9W - 18Hz.jpeg
