MIDORIINU/DSE-CII/Mediciones/Ancho de banda 1W/0.9W - 79.2KHz.jpeg

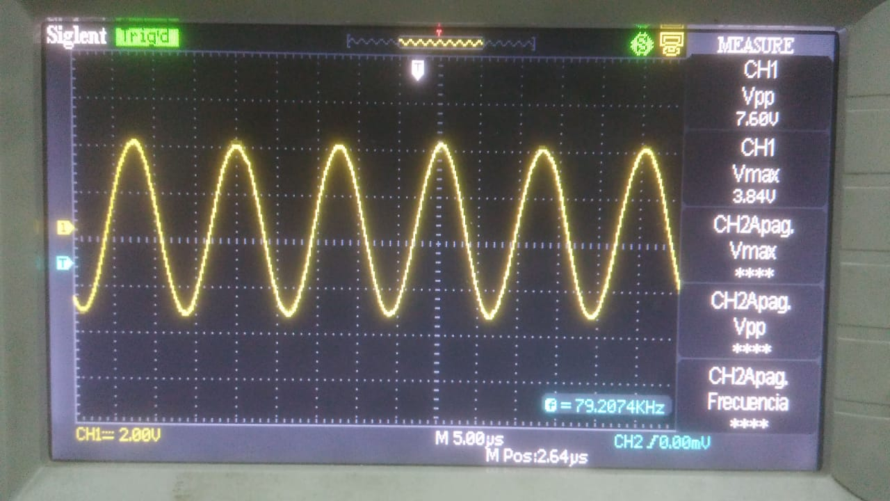
Mediciones/Ancho de banda 1W/0.9W - 79.2KHz.jpeg
