MIDORIINU/DSE-CII/Mediciones/Ancho de banda 1W/1W - 1KHz.jpeg

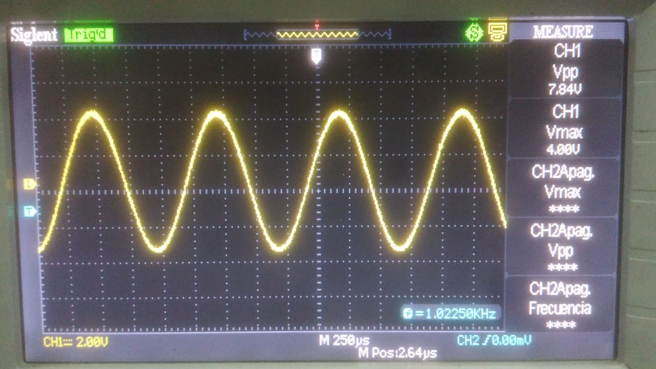
Mediciones/Ancho de banda 1W/1W - 1KHz.jpeg
