MIDORIINU/DSE-CII/Mediciones/Ancho de banda de potencia/36W - 47Hz.jpeg

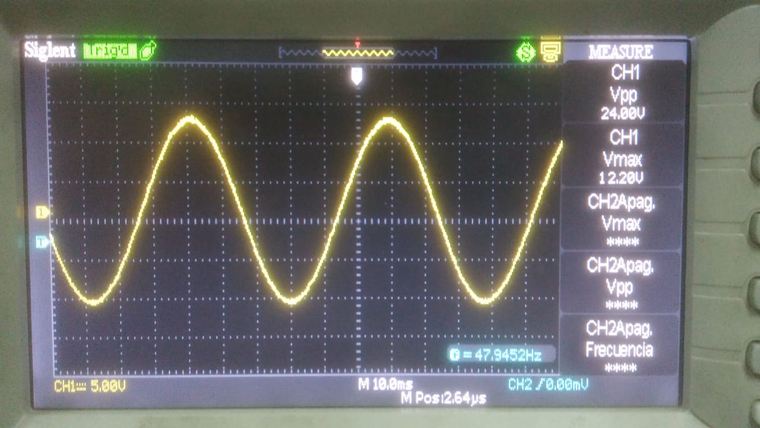
Mediciones/Ancho de banda de potencia/36W - 47Hz.jpeg
