MIDORIINU/DSE-CII/Mediciones/Ancho de banda de potencia/36W - 60KHz.jpeg

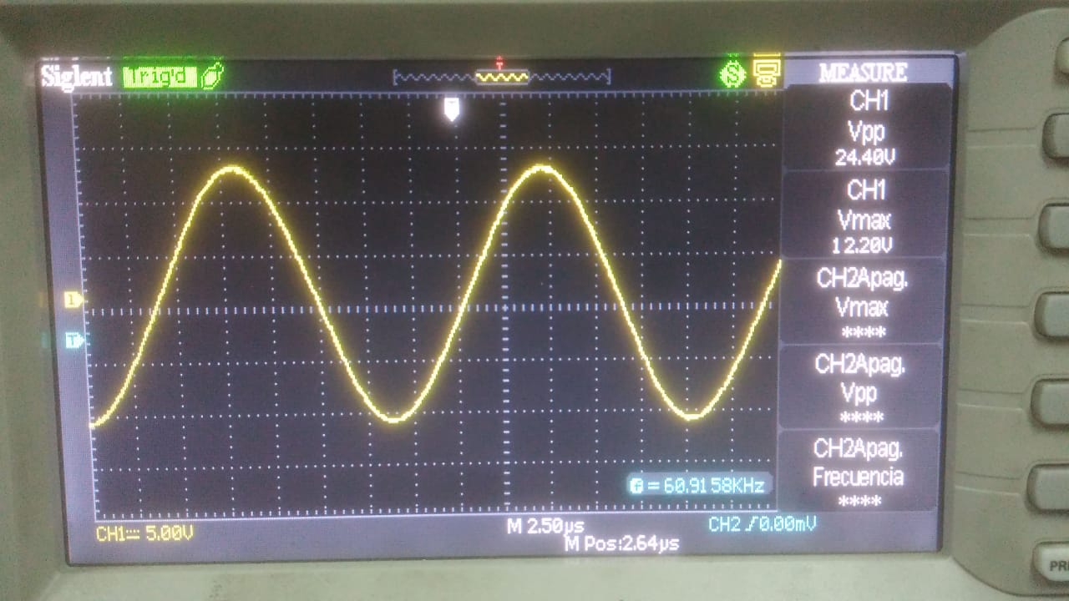
Mediciones/Ancho de banda de potencia/36W - 60KHz.jpeg
