MIDORIINU/DSE-CII/Mediciones/Ancho de banda de potencia/40W - 1KHz.jpeg

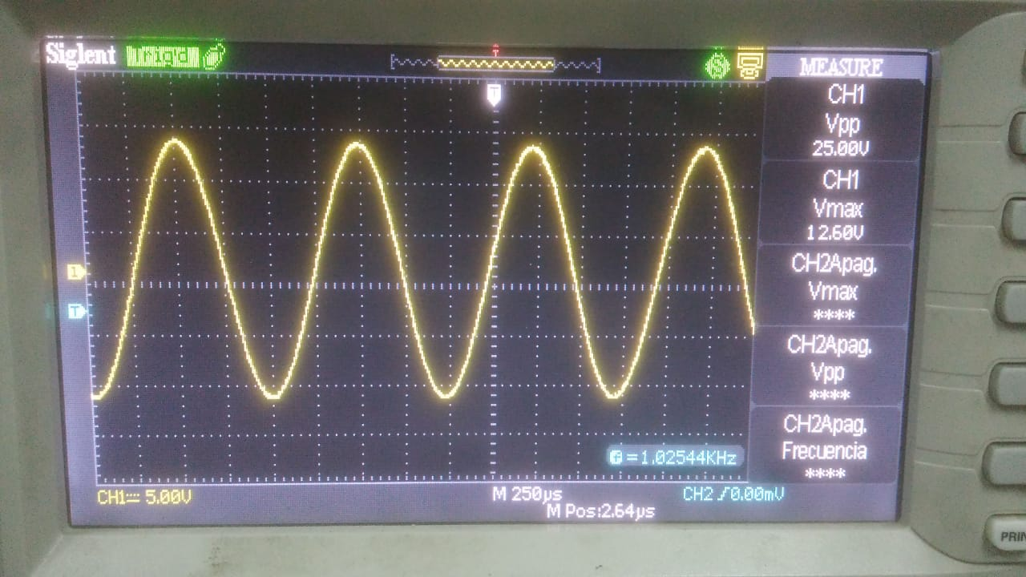
Mediciones/Ancho de banda de potencia/40W - 1KHz.jpeg
