MIDORIINU/DSE-CII/Mediciones/Slew-Rate/Slew rate 5.53 V-us V2.jpeg

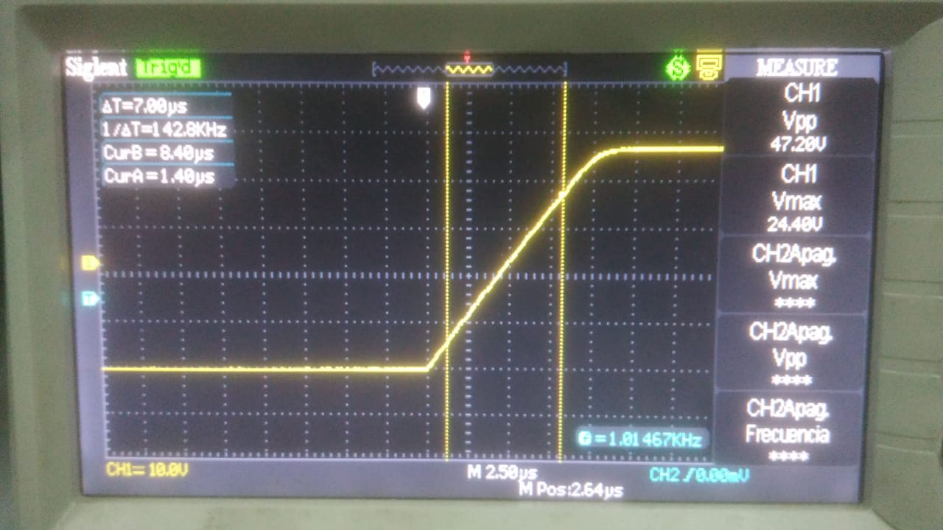
Mediciones/Slew-Rate/Slew rate 5.53 V-us V2.jpeg
