MIDORIINU/DSE-CII/Mediciones/Slew-Rate/Slew rate 5.53 V-us.jpg

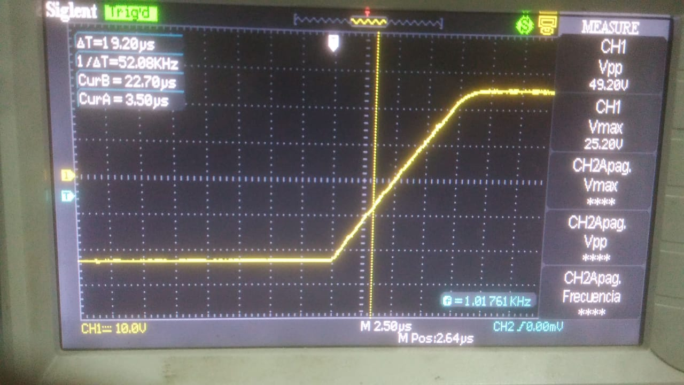
Mediciones/Slew-Rate/Slew rate 5.53 V-us.jpg
