MIDORIINU/DSE-CII/Mediciones/Slew-Rate/Tiempo de crecimiento del generador.jpg

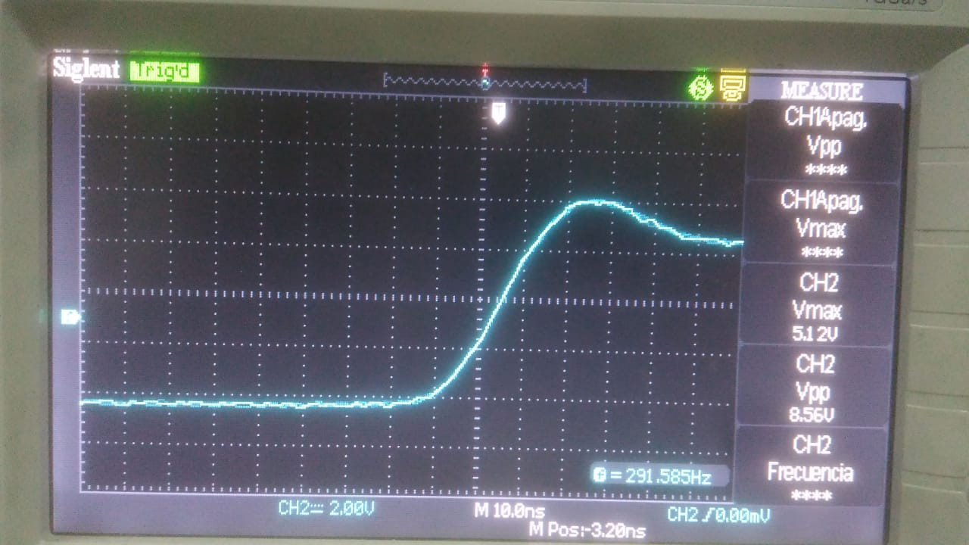
Mediciones/Slew-Rate/Tiempo de crecimiento del generador.jpg
