MIDORIINU/DSE-CII/design/Lista componentes.rtf

Transistores (todos tht):
-2x BD136
-2x BD135
-2x MJL21194
-2x MJL21193
-6x BC546C
-6x BC556C
-2x BC548C
-2x BC558C
-1x 2N3904
-1x 2N3906

Resistores (en ohm):
SMD paquete 1026:
-5x 220
-5x 50
-5x 22k
-2x 5k
-2x 22
-2x 10k
-2x 2.7k
-5x 4.7k
-2x 2k
-6x 100
-2x 250
-2x 500
THT:
-2x 0.1ohm pelicula metalica de 5W
-1x potenciometro 5k (paquete chiquito)
-1x potenciometro 1k (paquete chiquito)

Capacitores:
SMD paquete 1026:
-6x 10n
-2x 220p
THT:
-8x 100u para 30V minimo
-2x 470u para 30V minimo
-1x 1u

Diodos (todos tht):
-2x 1N5822
-2x 1N4148
-2x 1N4007

Varios:
-1x audio jack THT horizontal
-1x bornera doble THT (screw terminal 01x02)
-4x jack DC para pcb horizontales
-Tira de pines para jumper
-8x jumpers
