MIDORIINU/DSE-CII/design/componentes.xlsx

Microelectronica | Cantidad | Precio x unidad | Precio
TRANSISTORES |  |  | 0
BD136 | 2 | 18.9658 | 37.9316
BD135 | 2 | 18.8922 | 37.7844
BC546B | 6 | 3.5052 | 21.0312
BC556B | 6 | 3.3948 | 20.3688
BC548B | 2 |  | 0
BC558B | 2 |  | 0
2N3906 |  |  | 0
RESISTENCIAS |  |  | 0
R1206-22 |  |  | 0
R1206-220 |  |  | 0
R1206-22K |  |  | 0
R1206-2K7 |  |  | 0
R1206-2K2 |  |  | 0
R1206-56 |  |  | 0
R1206-5K6 |  |  | 0
R1206-10K |  |  | 0
R1206-4.7 |  |  | 0
R1206-100 |  |  | 0
R1206-560 |  |  | 0
PRESET |  |  | 0
3386P102 |  |  | 0
3386P502 |  |  | 0
3386P501 |  |  | 0
CAPACITORES |  |  | 0
C1206-0.01 |  |  | 0
C1206-220 |  |  | 0
CE100X35 |  |  | 0
CE105-470X35 |  |  | 0
CE100X50 |  |  | 0
CE105-470X50 |  |  | 0
DIODOS |  |  | 0
1N4148 |  |  | 0
1N4007 |  |  | 0
CONECTORES |  |  | 0
AMPH-ACJM-NH35 |  |  | 0
B162401 |  |  | 0
JK-DC025 |  |  | 0
B2P |  |  | 0
PL-DC021L |  |  | 0
