MIDORIINU/DSE-CII/Kicad-original/3D/ACJS-NH35.step

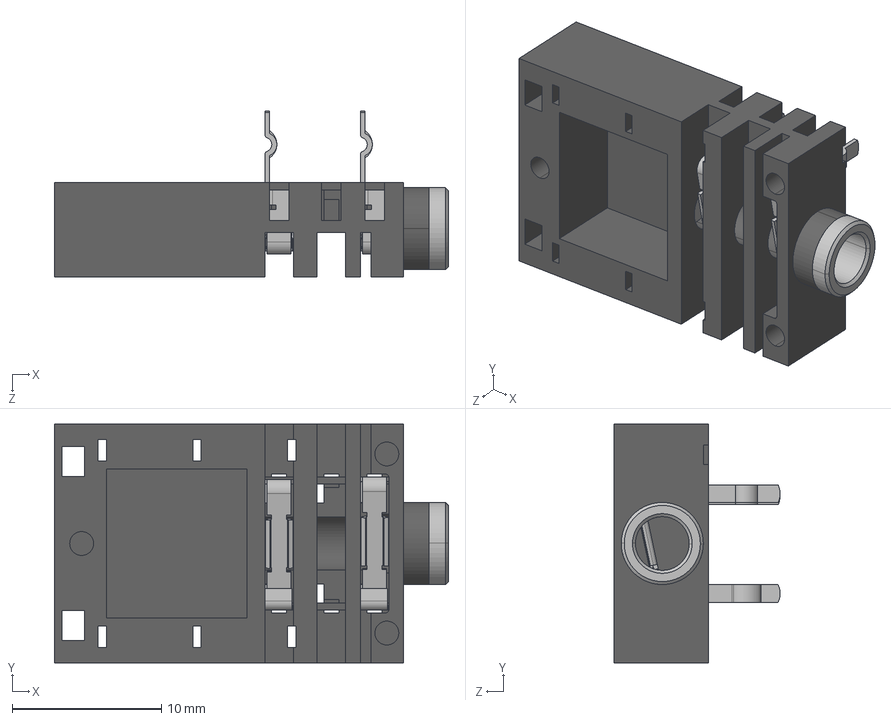
[picture p101: CAD file, 2019-12-07]
Kicad-original/3D/ACJS-NH35.step
26.4 x 16.0 x 11.2 mm
Metal_Tube.step.STEP
50300125-331C.step001.STEP x 2
50300126-331C.step001.STEP x 2
53480035-532b.step.STEP
