MIDORIINU/DSE-CII/Kicad-original/3D/DIP-8_W7.62mm_Socket.step

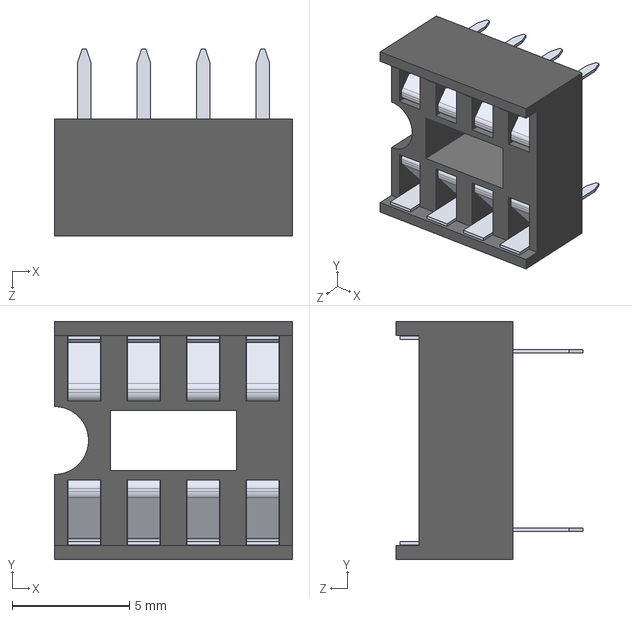
[picture p102: CAD file, 2019-12-07]
Kicad-original/3D/DIP-8_W7.62mm_Socket.step
10.2 x 10.2 x 8.00 mm
