MIDORIINU/DSE-CII/Kicad-original/3D/HS150mmx59mmx28mm.step

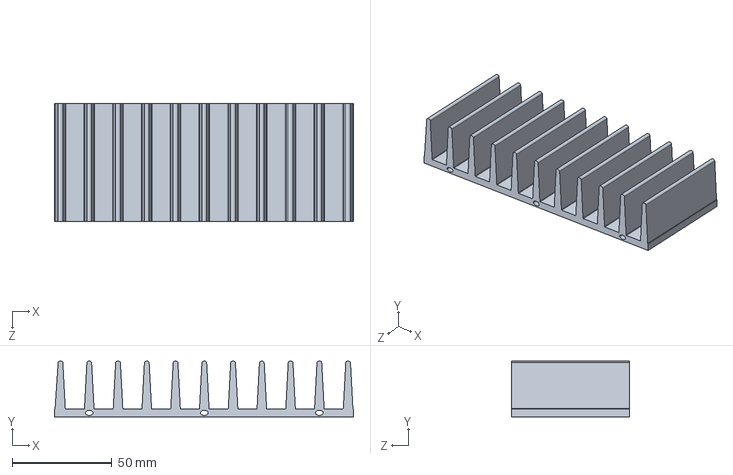
[picture p103: CAD file, 2019-12-07]
Kicad-original/3D/HS150mmx59mmx28mm.step
150.0 x 28.0 x 59.0 mm
