MIDORIINU/DSE-CII/Kicad-original/3D/POTENTIOMETER.step

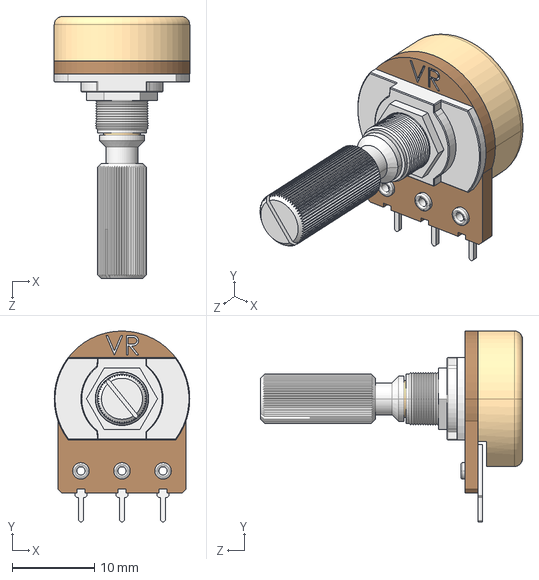
[picture p104: CAD file, 2019-12-07]
Kicad-original/3D/POTENTIOMETER.step
16.5 x 23.2 x 31.9 mm
