MIDORIINU/DSE-CII/Kicad-original/3D/Terminal block 2 POS.step

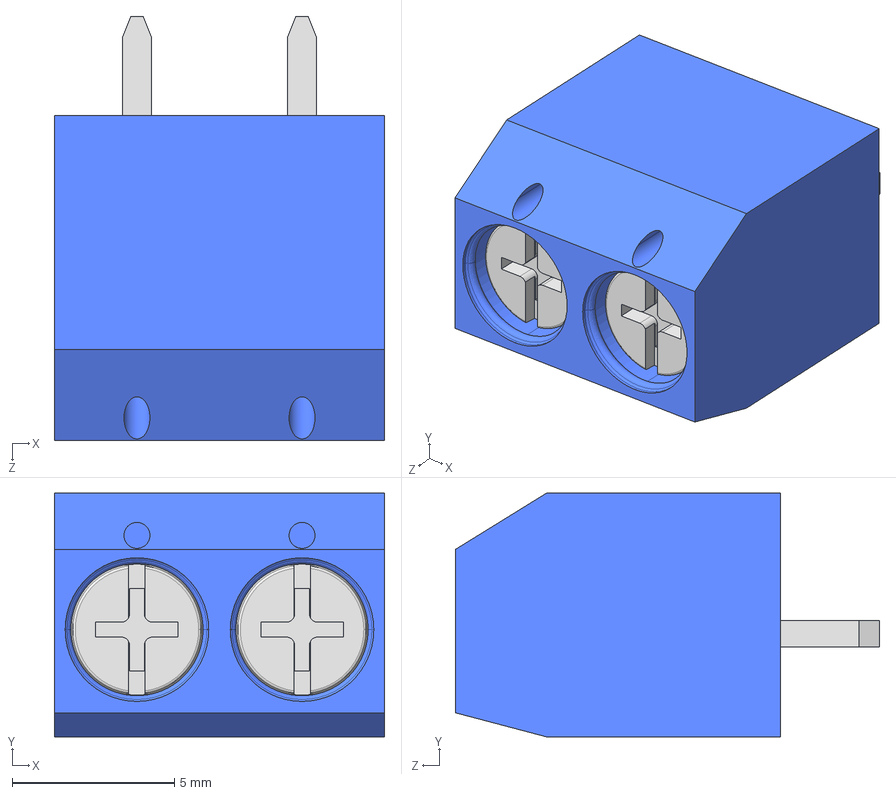
[picture p105: CAD file, 2019-12-07]
Kicad-original/3D/Terminal block 2 POS.step
10.2 x 7.50 x 13.0 mm
User Library-Terminal block 2 POS_395443002
User Library-Terminal block 2 POS__155
User Library-Terminal block 2 POS__532
User Library-Terminal block 2 POS__752
User Library-Terminal block 2 POS_395443002_2
