MIDORIINU/DSE-CII/Kicad-original/3D/DIP-8_W7.62mm.step

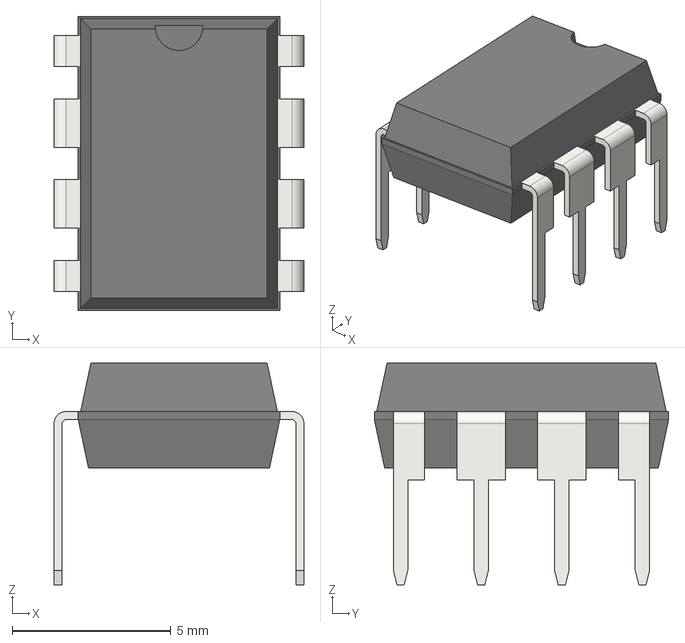
[picture p106: CAD file, 2019-12-07]
Kicad-original/3D/DIP-8_W7.62mm.step
7.87 x 9.27 x 6.98 mm
