MIDORIINU/DSE-CII/Kicad-original/3D/PJ-102B.step

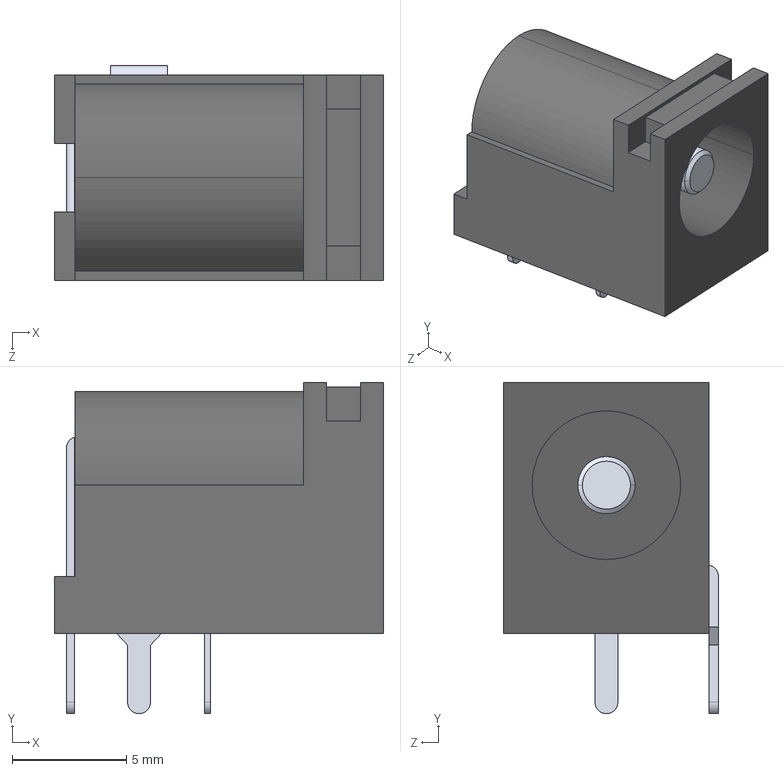
[picture p107: CAD file, 2019-12-07]
Kicad-original/3D/PJ-102B.step
14.4 x 14.5 x 9.40 mm
