MIDORIINU/DSE-CII/Kicad-original/3D/Bourns 3362R.step

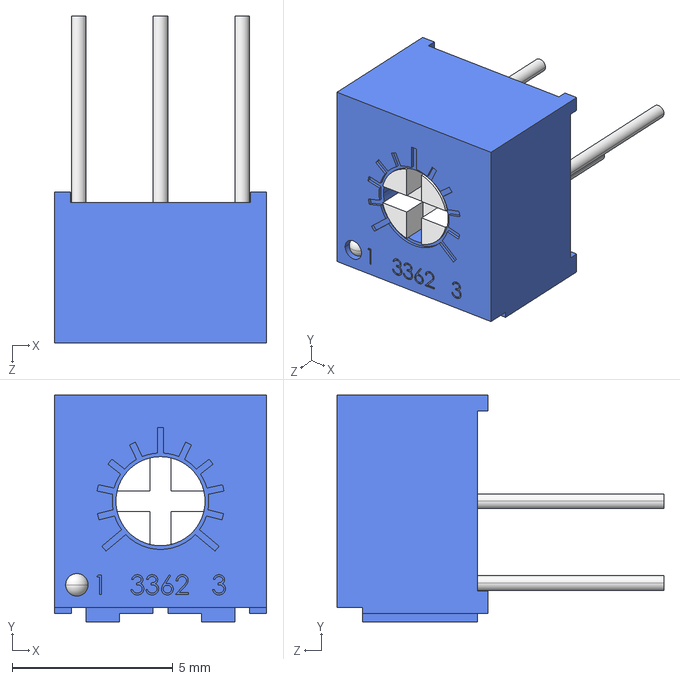
[picture p108: CAD file, 2019-12-07]
Kicad-original/3D/Bourns 3362R.step
6.60 x 7.05 x 10.2 mm
