MIDORIINU/DSE-CII/(list of files, cad)

Other CAD files:
Kicad/3D/Bourns 3362R.step
Kicad/3D/HS150mmx59mmx28mm.step
Kicad/3D/DIP-8_W7.62mm_Socket.step
Kicad/3D/ACJS-NH35.step
Kicad/3D/Terminal block 2 POS.step
Kicad/3D/POTENTIOMETER.step
Kicad/3D/PJ-102B.step
Kicad/3D/DIP-8_W7.62mm.step
