MIDORIINU/DSE-CII/LTSPICE/preamp.pdf

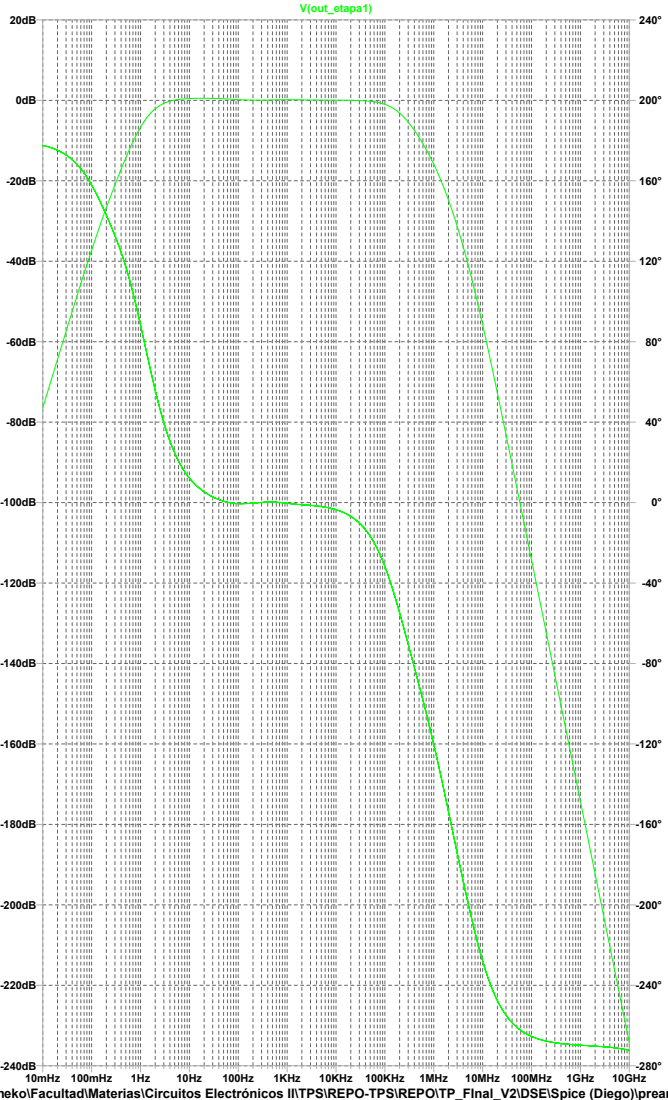
[picture p142: page 1]
10mHz 100mHz; 1KHz; 10KHz 100KHz; 1MHz; 10MHz 100MHz 1GHz; 10GHz; V(out_etapa1)

neko\Facultad\Materias\Circuitos Electrónicos II\TPS\REPO-TPS\REPO\TP_FInal_V2\DSE\Spice (Diego)\pream
