MIDORIINU/DSE-CII/design/etapa G/etapa_clase_G.asc

C1: cap; 100µ
C2: cap; 100µ
C3: cap; 1µ
C4: cap; 220p
C5: cap; 100µ
C6: cap; 100µ
D1: diode; 1N5817
D2: diode; 1N5817
D3: diode; 1N4148
D4: diode; 1N4148
D5: zener; 1N5371B
D6: zener; 1N5371B
Q1: npn; BD135
Q2: npn; TIP41C
Q3: npn; BD135
Q4: npn; TIP41C
Q5: pnp; BD136
Q6: pnp; TIP42C
Q7: npn; BC548C
Q8: pnp; BD136
Q9: pnp; TIP42C
Q10: npn; BC548C
Q11: npn; BC548C
Q12: npn; BC548C
Q13: npn; BC548C
Q14: pnp; BC558C
Q15: pnp; BC558C
Q16: pnp; BD136
R1: res; 100
R2: res; 100
R3: res; 100
R4: res; 220
R5: res; 220
R6: res; 100
R7: res; 800
R8: res; 56
R9: res; 22k
R10: res; 1k
R11: res; 220
R12: res; 470
R13: res; 4.7k
R14: res; 22k
R15: res; 4.7k
R16: res; 22
R17: res; 0.4
R18: res; 0.4
R19: res; 0.4
R20: res; 0.4
RL: res; 8
V1: voltage; 15
V2: voltage; 15
V3: voltage; 30
V4: voltage; 30
V5: voltage; SINE(0 5 1k)
Named nets: VccL, VccH, 0, VssH, VssL, Out
.model MyDiode D(Ron=0.0001 Roff=100G Vfwd=0.7)
.lib standard_bjt.lib
.tran 2m
.model MyZener D(Ron=0.0001 Roff=100G Vfwd=0.7 Vrev=3.3 )
