MIDORIINU/DSE-CII/design/Spice Completo/circuito_completo.asc

C1: cap; 100µ
C2: cap; 10n
C3: cap; 100µ
C4: cap; 10n
C5: cap; 100µ
C6: cap; 10n
C7: cap; 100µ
C8: cap; 10n
C9: cap; 100µ
C10: polcap; 1µ
C11: polcap; 100p
C12: polcap; 2µ
C13: polcap; 22n
C14: polcap; 220n
C15: polcap; 2.2n
C16: polcap; 22n
C17: cap; 10n
Ccomp1: cap; 220p
Cf1: cap; 100µ
Cpop1: cap; 470µ
Cpop2: cap; 470µ
Cs1: cap; 1µ
D1: diode; DN5822
D2: diode; DN5822
D3: diode; 1N4148
D4: diode; 1N4148
D5: zener; DN4370
D6: zener; DN4370
Dled1: LED; NSCW100
Dpop1: diode; DN4007
Dpop2: diode; DN4007
Q1: npn; BD135
Q2: npn; mjl21194
Q3: npn; BD135
Q4: npn; mjl21194
Q5: pnp; BD136
Q6: pnp; mjl21193
Q7: pnp; BD136
Q8: pnp; mjl21193
Q9: npn; BC548C
Q10: npn; BC546B
Q11: npn; BC548C
Q12: npn; BC546B
Q13: npn; BC546B
Q14: pnp; BC556B
Q15: pnp; BC556B
Q16: pnp; BC556B
Q17: pnp; BC558C
Q18: npn; 2N3904
Q19: pnp; 2N3906
R2: res; 220
R3: res; 220
R4: res; 50
R5: res; 50
R6: res; 22k
R7: res; 5k
R8: res; 22
R9: res; 10k
R10: res; 2.7k
R11: res; 4.7k
R12: res; 4.7k
R13: res; 2k
R14: res; 250
R15: res; 100
R16: res; 100
R17: res; 100
R18: res; 100
R19: res; 0.22
R20: res; 0.22
R22: res; 1k
R23: res; 100k
R24: res; 100k
R25: res; 1Meg
R26: res; 10k
R27: res; 1k
R28: res; 10k
R29: res; 320k
Rbass1: res; 50k
Rbass2: res; 50k
Rf1: res; 22k
Rf2: res; 950
RL1: res; 8
Rpot1: res; 2k
Rtreble1: res; 50k
Rtreble2: res; 50k
Rvol1: res; 0.01
Rvol2: res; 100k
U1: opamp2; TL072
V1: voltage; 15
V2: voltage; 15
V3: voltage; 30
V4: voltage; 30
Vs: voltage; SINE(0 700m 1k); AC 100m
Named nets: 0, VccH, VccL, VssH, VssL, out_etapa1, in, Out, InPD, outPD
.lib standard_bjt.lib
.tran 0 80m 70m 1u
.lib MBR1645.LIB
.lib TL072.301
Volumen: subir R10_1 baja el volumen
Treble: subir R9_2 suben los agudos
Bass: subir R6_2 sube los bajos
.MODEL mjl21193 pnp IS=1.6p BF=110 VAF=300 IKF=4 ISE=5p NE=1.5
+ NF=0.95 RB=2.0 RBM=2 IRB=10 RC=0.06 CJE=13n MJE=0.35 VJE=0.5
+ RE=0.001 CJC=1.5n MJC=0.5 VJC=0.6 FC=0.5 TF=24n XTF=1.0 VTF=10 ITF=10
+ TR=100n BR=5 VAR=100 NR=1.1 EG=1.1 XCJC=0.96 XTB=0.1 XTI=1 NC=4
+ ISC=0.3p mfg=CA112210
.MODEL mjl21194 npn IS=4p BF=70 VAF=500 IKF=14 ISE=1.2n NE=2.0 NF=1.01
+ RB=3.4 RBM=0.1 IRB=1.0 RC=0.06 CJE=8n MJE=0.35 VJE=0.5 RE=0.01 CJC=1.2n
+ MJC=0.5 VJC=0.6 FC=0.5 TF=21n XTF=90 VTF=10 ITF=100 TR=100n BR=5 VAR=100
+ NR=1.1 EG=1.1 XCJC=0.96 XTB=0.1 XTI=1 NC=4 ISC=0.3p mfg=CA112210
.MODEL DN4370 D(RS=15.156 BV=2.0969     
+ CJO=757.62P TT=50N M=.33 VJ=.75 IS=1E-11 N=1.27 IBV=10MA)
.four 1k V(out)
.MODEL DN5822 D (IS=218U N=1.45 BV=4.00E+01 IBV=100E-06
+ RS=2.71E-02 CJO=4.39E-10 VJ=4.462 M=.699 TT=2.16E-11 XTI=2 EG=.69)
.MODEL DN4007 D (IS=5.86E-06 N=1.70 BV=1.33E+03 IBV=5.00E-07
+ RS=4.22E-02 CJO=3.65E-11 VJ=.2 M=.333 TT=7.20E-06)
