MIDORIINU/DSE-CII/design/Tone control/tone_control.asc

C1: polcap; 1µ
C2: polcap; 100p
C3: polcap; 2µ
C4: polcap; 22n
C5: polcap; 220n
C6: polcap; 2.2n
C7: polcap; 22n
R1: res; 100k
R2: res; 1.25Meg
R3: res; 1k
R4: res; 100k
R5: res; 10k
R6_1: res; 50k
R6_2: res; 50k
R7: res; 1k
R8: res; 10k
R9_1: res; 50k
R9_2: res; 50k
R10_1: res; 10
R10_2: res; 100k
RL: res; 25k
U1: opamp2; TL072
V1: voltage; SINE(0 700m {freq}); AC 100m
V2: voltage; 15
V3: voltage; 15
Named nets: 0, Vcc, Vss, out, in
R6 Bass
R10 Vol
R9 Treble
.lib TL072.301
.tran 0 30m 20m
Volumen: subir R10_1 baja el volumen
En esta etapa entra directo la salida del celular, que segun lo que medi son como mucho 0.7V pico.
Deberia tener una ganancia (regulada por R2 y R1) tal que a la salida hayan aproximadamente 1V.
Treble: subir R9_2 suben los agudos
Bass: subir R6_2 sube los bajos
.fourier {freq} 30 -1 V(out)
.param freq 1k
