MIDORIINU/DSE-CII/LTSPICE/amplifier/amplifier_eff_vs_power.asc

C1: polcap; 1µ
C2: polcap; 100µ
C3: polcap; 100µ
C5: polcap; 470µ
C6: polcap; 470µ
C7: cap; 10n
C8: cap; 10n
C9: cap; 10n
C10: cap; 10n
C11: cap; 10n
C12: polcap; 100µ
C13: polcap; 100µ
C14: polcap; 100µ
C15: polcap; 100µ
Ccomp1: cap; 220p
Ccomp2: cap; 220p
Ccomp3: cap; 220p
D1: LED; BLUE_LED_ALT
D2: diode; DN4007
D3: zener; DN4370
D4: zener; DN4370
D5: diode; 1N4148
D6: diode; 1N4148
D7: diode; DN4007
D8: diode; DN5822
D9: diode; DN5822
Q1: npn; BC546B
Q2: pnp; BC556B
Q3: npn; BC546B
Q4: pnp; BC556B
Q5: npn; BC546B
Q6: npn; BC546B
Q7: pnp; BC556B
Q8: pnp; BC556B
Q9: npn; BD135
Q10: pnp; BD136
Q11: pnp; BD136
Q12: npn; BD135
Q13: npn; BD135
Q14: npn; MJL21194
Q15: npn; MJL21194
Q16: pnp; MJL21193
Q17: pnp; MJL21193
Q18: pnp; 2N3906
Q19: npn; 2N3904
R1: res; 22k
R2: res; 4.7k
R3: res; 4.7k
R4: res; 220
R5: res; 56
R6: res; 2k
R7: res; 56
R8: res; 220
R9: res; 100
R10: res; 220
R11: res; 5.6k
R12: res; 22k
R13: res; 22
R14: res; 10k
R15: res; 2.7k
R16: res; 100
R17: res; 100
R18: res; 100
R19: res; 100
R20: res; 0.1
R21: res; 0.1
R22: res; 100
RL: res; {RL}
RV1: res; 950
RV2: res; {rv2_min_THD}
V1: voltage; {LH}
V2: voltage; {LH}
V3: voltage; {VH}
V4: voltage; {VH}
Vs: voltage; SINE(0 {VPin} {freq} {startsigndelay}); AC {VPin}
Named nets: 0, VccH, VccL, VssH, VssL, in, out, InPD, outPD, feedback, E15, E16, MID_NEG, MID_POS, B17, B14, E10, E13, B13, B10, C8, C6, VccHF, VssHF, E6, E8, B6, B8, C3, E3, C5, E5, E1, B11, B12, E2, E4
.lib BC548C.lib
.lib MBR1645.lib
.lib TL072.lib
.lib DN4370.lib
.lib MJL21193.lib
.lib MJL21194.lib
.lib DN5822.lib
.lib DN4007.lib
.lib BC558C.lib
.lib BD135.lib
.lib BD136.lib
.option plotwinsize=0
.meas TRAN Vrms RMS V(out) FROM {datastart}
.meas TRAN Pout AVG V(out)*I(RL) FROM {datastart}
.option numdgt=9
.meas TRAN Vout_max MAX V(out)
.param datastart=+{startsigndelay}-{startdelay}
.tran 0 {datastop} {startdelay} {datastep}
.param freq=1k
.param RL=8
.param startdelay=4m
.param startsigndelay=5m
.param dataduration=10m
.param datastop=+{dataduration}+{startdelay}
.param datastep=0.0001m
.lib NE5532.lib
.lib LEDS.lib
.param VH=35
.param LH=15
.param rv2_10m=2.943k
.param rv2_min_THD=2.3k
Simulación paramétrica
.step param VPin 25m 1050m 25m
.meas TRAN PVCCL AVG -V(VccL)*I(V1) FROM {datastart}
.meas TRAN PVSSL AVG V(VssL)*I(V2) FROM {datastart}
.meas TRAN PVCCH AVG -V(VccH)*I(V3) FROM {datastart}
.meas TRAN PVSSH AVG V(VssH)*I(V4) FROM {datastart}
.meas TRAN Pin PARAM +PVCCL+PVSSL+PVCCH+PVSSH
.meas TRAN Eff PARAM +Pout*100/Pin
