MIDORIINU/DSE-CII/LTSPICE/amplifier/amplifier_PSRR_real_circ.asc

C1: polcap; 1µ
C2: polcap; 100µ
C3: polcap; 100µ
C4: polcap; 1000µ
C5: polcap; 470µ
C6: polcap; 470µ
C7: cap; 10n
C8: cap; 10n
C9: cap; 10n
C10: cap; 10n
C11: cap; 10n
C12: polcap; 100µ
C13: polcap; 100µ
C14: polcap; 100µ
C15: polcap; 100µ
C16: polcap; 1000µ
C17: cap; 100n
Ccomp1: cap; 220p
Ccomp2: cap; 220p
Ccomp3: cap; 220p
D1: LED; BLUE_LED_ALT
D2: diode; DN4007
D3: zener; DN4370
D4: zener; DN4370
D5: diode; 1N4148
D6: diode; 1N4148
D7: diode; DN4007
D8: diode; DN5822
D9: diode; DN5822
D10: diode; 1N4007
D11: zener; 1N758
M1: IRF9530
Q1: npn; BC546B
Q2: pnp; BC556B
Q3: npn; BC546B
Q4: pnp; BC556B
Q5: npn; BC546B
Q6: npn; BC546B
Q7: pnp; BC556B
Q8: pnp; BC556B
Q9: npn; BD135
Q10: pnp; BD136
Q11: pnp; BD136
Q12: npn; BD135
Q13: npn; BD135
Q14: npn; MJL21194
Q15: npn; MJL21194
Q16: pnp; MJL21193
Q17: pnp; MJL21193
Q18: pnp; 2N3906
Q19: npn; 2N3904
R1: res; 22k
R2: res; 4.7k
R3: res; 4.7k
R4: res; 220
R5: res; 56
R6: res; 2k
R7: res; 56
R8: res; 220
R9: res; 100
R10: res; 220
R11: res; 5.6k
R12: res; 22k
R13: res; 22
R14: res; 10k
R15: res; 2.7k
R16: res; 100
R17: res; 100
R18: res; 100
R19: res; 100
R20: res; 0.1
R21: res; 0.1
R22: res; 100
R23: res; 1
R24: res; 10k
RL: res; {RL}
RV1: res; 950
RV2: res; {rv2_max}
V1: voltage; {LH}
V2: voltage; {LH}
V3: voltage; {VH}
V4: voltage; {VH}
V5: voltage; 5
V6: voltage; 30
Vs1: voltage; PULSE(0 20 0 1E-4n 0.1E-4n 25m 50m); AC 1
Named nets: 0, VccH, VccL, VssH, VssL, in, VccH_MOD, out, InPD, outPD, feedback, E15, E16, MID_NEG, MID_POS, B17, B14, E10, E13, B13, B10, C8, C6, VccHF, VssHF, E6, E8, B6, B8, C3, E3, C5, E5, E1, B11, B12, E2, E4, out_filt
.lib BC548C.lib
.lib MBR1645.lib
.lib TL072.lib
.lib DN4370.lib
.lib MJL21193.lib
.lib MJL21194.lib
.lib DN5822.lib
.lib DN4007.lib
.lib BC558C.lib
.lib BD135.lib
.lib BD136.lib
.option plotwinsize=0
.option numdgt=9
.param datastart=+{startdelay}
.tran 0 {datastop} {startdelay} {datastep}
.param RL=8
.param startdelay=500m
.param dataduration=500m
.param datastop=+{dataduration}+{startdelay}
.param datastep=0.001m
.lib NE5532.lib
.lib LEDS.lib
.param VH=35
.param LH=15
.lib 1N4007.lib
.lib 1N758.lib
.meas TRAN Vcch_mod_rms RMS (V(VccH_MOD) - VccH_MOD_mean) FROM {datastart}
.meas TRAN vcch_mod_mean AVG (V(vcch_mod)) FROM {datastart}
.meas TRAN Vout_filt_rms RMS (V(out_filt) - Vout_filt_mean) FROM {datastart}
.meas psrr PARAM (20*LOG10(Vcch_mod_rms/Vout_filt_rms))
.meas TRAN vcch_mod_rms_t RMS (V(vcch_mod)) FROM {datastart}
.meas TRAN Vout_filt_mean AVG (V(out_filt)) FROM {datastart}
.param rv2_10m=2.943k
.param rv2_min_THD=2.3k
.param VPin_40W=1048m
.param VPin_1W=165.84m
.param rv2_max=1.28k
