MIDORIINU/DSE-CII/LTSPICE/amplifier/PSRR_circ.asc

C1: polcap; 1000µ
C2: polcap; 1000µ
D1: diode; 1N4007
D2: zener; 1N758
R1: res; 1
R2: res; 35
U1: IRF9530
V1: voltage; 5
V2: voltage; 31
Vs1: voltage; PULSE(0 12 0 1E-4n 0.1E-4n 25m 50m); AC 1
Named nets: 0
.tran 0 500m 0 0.001m
.lib 1N4007.lib
.lib 1N758.lib
