MIDORIINU/DSE-CII/LTSPICE/completo/circuito_completo.asc

C1: polcap; 2µ
C2: polcap; 100µ
C3: polcap; 100µ
C5: polcap; 470µ
C6: polcap; 470µ
C7: cap; 10n
C8: cap; 10n
C9: cap; 10n
C10: cap; 10n
C11: cap; 10n
C12: polcap; 100µ
C13: polcap; 100µ
C14: polcap; 100µ
C15: polcap; 100µ
C16: polcap; 1µ
C17: cap; 100p
C18: polcap; 1µ
C19: polcap; 1µ
C20: cap; 22n
C21: cap; 220n
C22: cap; 2.2n
C23: cap; 22n
Ccomp1: cap; 220p
Ccomp2: cap; 680p
D1: LED; BLUE_LED_ALT
D2: diode; DN4007
D3: zener; DN4370
D4: zener; DN4370
D5: diode; 1N4148
D6: diode; 1N4148
D7: diode; DN4007
D8: diode; DN5822
D9: diode; DN5822
Q1: npn; BC546B
Q2: pnp; BC556B
Q3: npn; BC546B
Q4: pnp; BC556B
Q5: npn; BC546B
Q6: npn; BC546B
Q7: pnp; BC556B
Q8: pnp; BC556B
Q9: npn; BD135
Q10: pnp; BD136
Q11: pnp; BD136
Q12: npn; BD135
Q13: npn; BD135
Q14: npn; MJL21194
Q15: npn; MJL21194
Q16: pnp; MJL21193
Q17: pnp; MJL21193
Q18: pnp; 2N3906
Q19: npn; 2N3904
R1: res; 22k
R2: res; 4.7k
R3: res; 4.7k
R4: res; 220
R5: res; 22
R6: res; 2k
R7: res; 22
R8: res; 220
R10: res; 220
R11: res; 5.6k
R12: res; 22k
R13: res; 22
R14: res; 10k
R15: res; 2.7k
R16: res; 100
R17: res; 100
R18: res; 100
R19: res; 100
R20: res; 0.22
R21: res; 0.22
R22: res; 100k
R23: res; 1k
R24: res; 73.5k
R25: res; 1Meg
R26: res; 220k
R27: res; 100k
R28: res; 10k
R29: res; 1k
R30: res; 1k
RL: res; {RL}
RV1: res; 950
RV2: res; 2.4181k
RV3: potentiometer_standard; Rtot=100K wiper=0.17; Rtap=1E-5 tap=0.5
RV4: potentiometer_standard; Rtot=100K wiper=1; Rtap=1E-5 tap=0.5
RV5: potentiometer_standard; Rtot=100K wiper=0.07; Rtap=1E-5 tap=0.5
U1: opamp2; Tl072
V1: voltage; {LH}
V2: voltage; {LH}
V3: voltage; {VH}
V4: voltage; {VH}
Vs: voltage; SINE(0 {VPin} {freq}); AC {VPin}
Named nets: 0, VccL, VssL, out_etapa1, in, VccH, VssH, out, InPD, outPD, feedback, E15, E16, MID_NEG, MID_POS, B17, B14, E10, E13, B13, B10, C8, C6, VccHF, VssHF, E6, E8, B6, B8, C3, E3, C5, E5, E1, B11, B12, E2, E4
En esta etapa entra directo la salida del celular, que segun lo que medi son como mucho 0.7V pico.
Deberia tener una ganancia (regulada por R24 y R25) tal que a la salida hayan aproximadamente 1V.
Trebel
Volume
Bass
.lib BC548C.lib
.lib MBR1645.lib
.lib TL072.lib
.lib DN4370.lib
.lib MJL21193.lib
.lib MJL21194.lib
.lib DN5822.lib
.lib DN4007.lib
.lib BC558C.lib
.lib BD135.lib
.lib BD136.lib
.fourier {freq} 30 4 V(out)
.option plotwinsize=0
.meas TRAN Vrms RMS V(out) FROM {datastart}
.meas TRAN Pout AVG V(out)*I(RL) FROM {datastart}
.option numdgt=9
.meas TRAN Vout_max MAX V(out)
.param datastart=+{startsigndelay}-{startdelay}
.tran 0 {datastop} {startdelay} {datastep}
.param freq=10k
.op
.ac dec 10000 0.01 10G
.param VPin={700m}
.param RL=8
.param startdelay=4m
.param startsigndelay=5m
.param dataduration=10m
.param datastop=+{dataduration}+{startdelay}
.param datastep=0.0001m
.lib NE5532.lib
.lib LEDS.lib
.param VH=35
.param LH=15
