MIDORIINU/DSE-CII/Kicad-original/kicad_ampli.kicad_pcb

## KiCad design Kicad-original/kicad_ampli.kicad_pcb (2019-12-07)

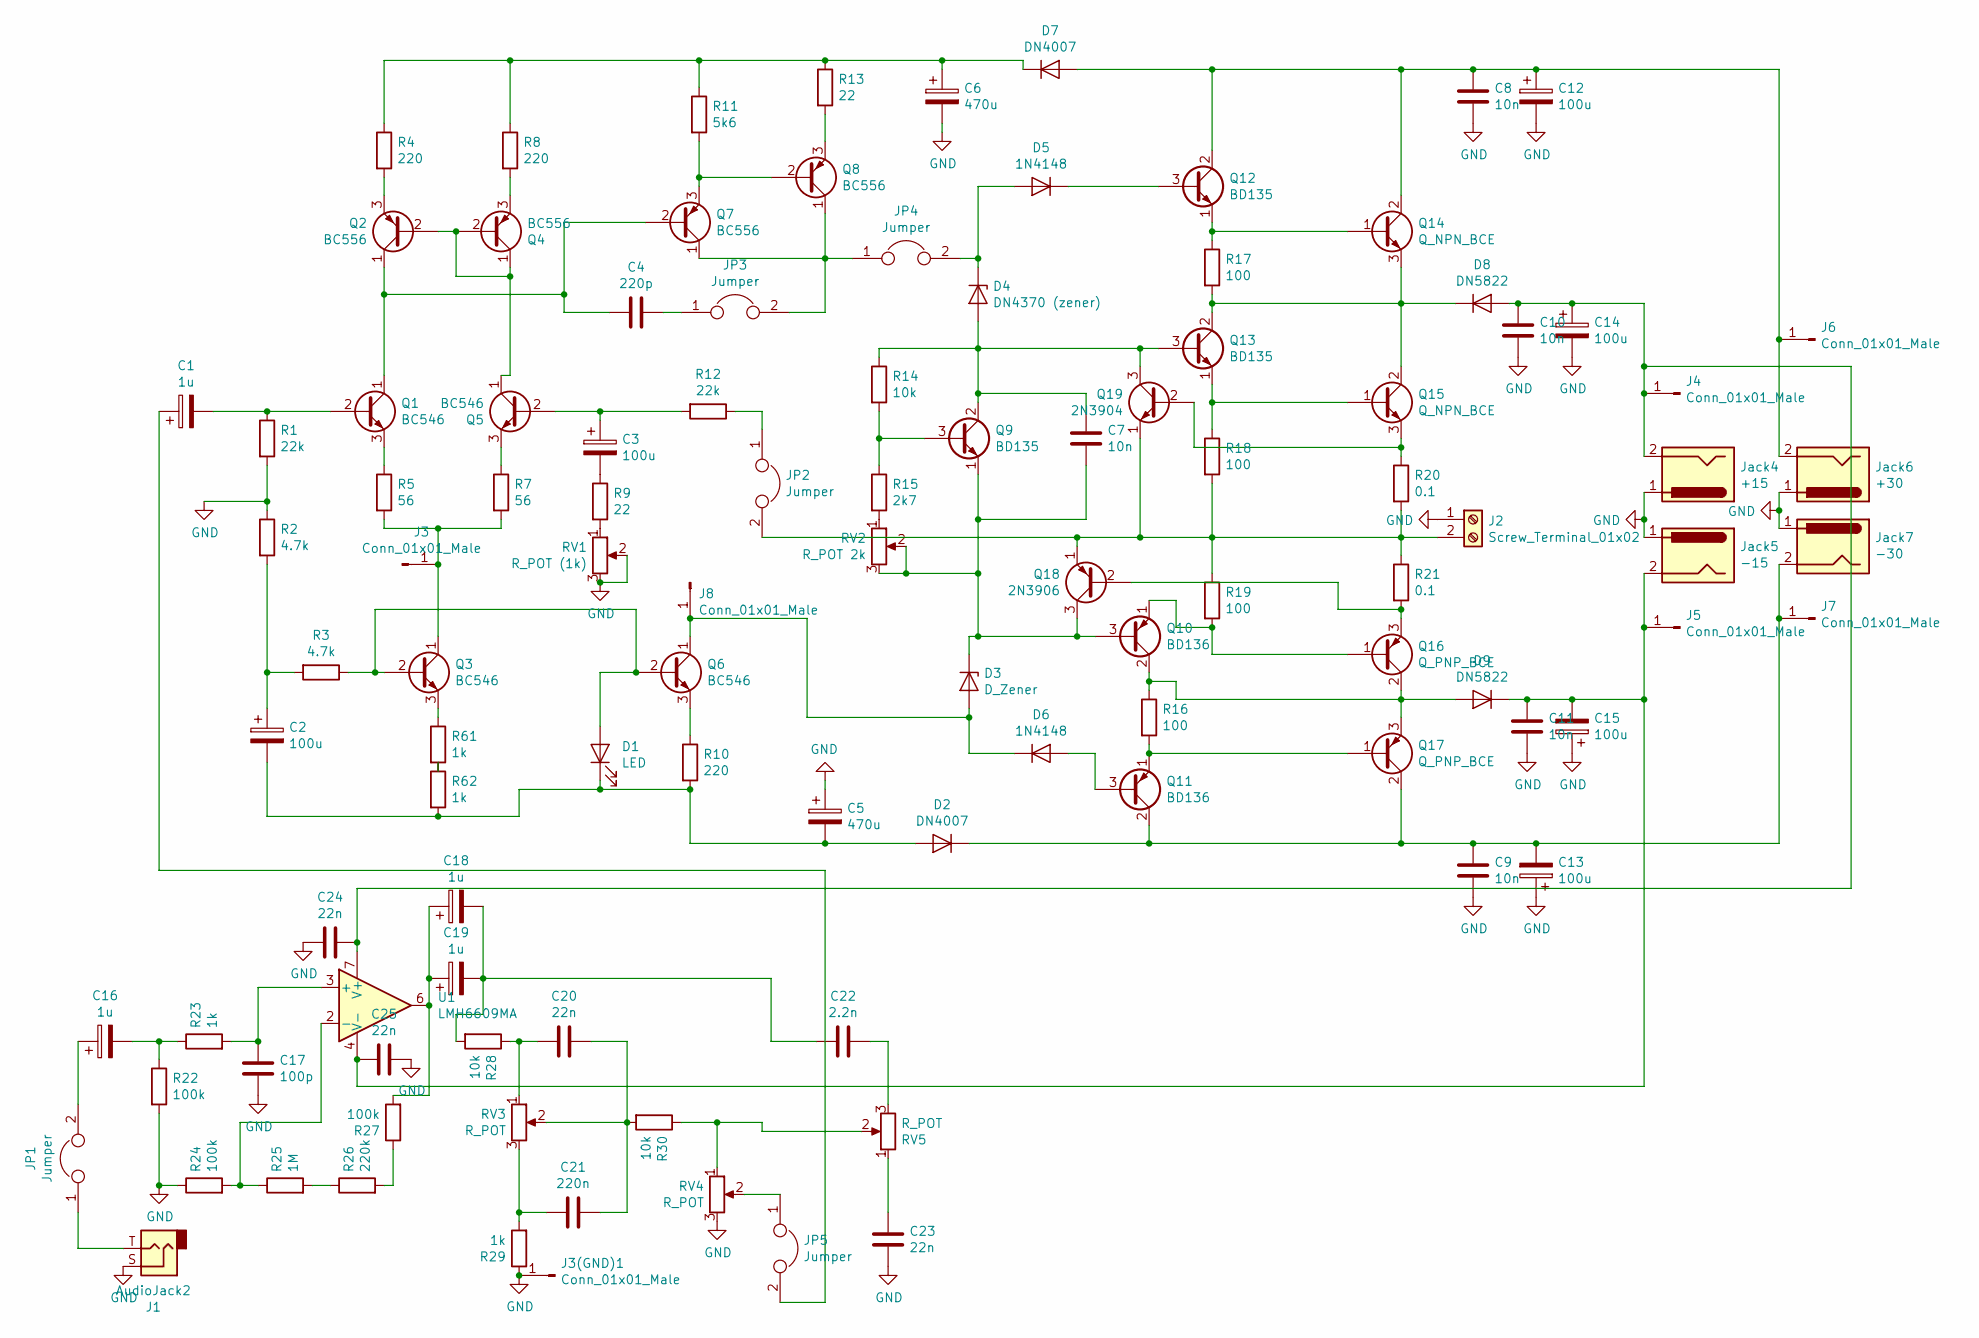
[picture p143: schematic kicad_ampli.sch]

Parts:
C1, C16: 1u; CP_Radial_D4.0mm_P2.00mm
C2, C3, C12, C13, C14, C15: 100u; CP_Radial_D8.0mm_P3.50mm
C4: 220p; C_1206_3216Metric
C5, C6: 470u; CP_Radial_D10.0mm_P5.00mm
C7, C8, C9, C10, C11: 10n; C_1206_3216Metric
C17: 100p; C_1206_3216Metric_Pad1.42x1.75mm_HandSolder
C18, C19: 1u; C_1206_3216Metric_Pad1.42x1.75mm_HandSolder
C20, C23, C24, C25: 22n; C_1206_3216Metric_Pad1.42x1.75mm_HandSolder
C21: 220n; C_1206_3216Metric_Pad1.42x1.75mm_HandSolder
C22: 2.2n; C_1206_3216Metric_Pad1.42x1.75mm_HandSolder
D1: LED; LED_D5.0mm_Horizontal_O1.27mm_Z3.0mm
D2, D7: DN4007; D_5W_P12.70mm_Horizontal
D3: D_Zener; D_DO-35_SOD27_P7.62mm_Horizontal
D4: DN4370 (zener); D_DO-35_SOD27_P7.62mm_Horizontal
D5, D6: 1N4148; D_DO-35_SOD27_P7.62mm_Horizontal
D8, D9: DN5822; D_DO-201AD_P15.24mm_Horizontal
J1: AudioJack2; ACJS-NH35
J2: Screw_Terminal_01x02; TerminalBlock_bornier-2_P5.08mm_BELOW_W3DM
J3, J3(GND)1, J4, J5, J6, J7, J8: Conn_01x01_Male; PinHeader_1x01_P1.00mm_Vertical
JP1, JP5: Jumper; PinHeader_1x03_P2.54mm_Vertical
JP2, JP3, JP4: Jumper; PinHeader_1x02_P2.54mm_Vertical
Jack4: +15; BarrelJack_Horizontal
Jack5: -15; BarrelJack_Horizontal
Jack6: +30; BarrelJack_Horizontal
Jack7: -30; BarrelJack_Horizontal
Q1, Q3, Q5, Q6: BC546; TO-92_Inline
Q2, Q4, Q7, Q8: BC556; TO-92_Inline
Q9, Q12, Q13: BD135; TO-126-3_Vertical
Q10, Q11: BD136; TO-126-3_Vertical
Q14, Q15: Q_NPN_BCE; TO-264-3_Vertical
Q16, Q17: Q_PNP_BCE; TO-264-3_Vertical
Q18: 2N3906; TO-92_Inline_Wide
Q19: 2N3904; TO-92_Inline_Wide
R1, R12: 22k; R_1206_3216Metric
R2, R3: 4.7k; R_1206_3216Metric
R4, R8, R10: 220; R_1206_3216Metric
R5, R7: 56; R_1206_3216Metric
R9, R13: 22; R_1206_3216Metric
R11: 5k6; R_1206_3216Metric
R14, R28, R30: 10k; R_1206_3216Metric
R15: 2k7; R_1206_3216Metric
R16, R17, R18, R19: 100; R_1206_3216Metric
R20, R21: 0.1; R_Axial_Power_L20.0mm_W6.4mm_P30.48mm
R22, R24, R27: 100k; R_1206_3216Metric
R23, R29, R61, R62: 1k; R_1206_3216Metric
R25: 1M; R_1206_3216Metric
R26: 220k; R_1206_3216Metric
RV1: R_POT (1k); Potentiometer_ACP_CA6-H2,5_Horizontal_BELOW_W3DM
RV2: R_POT 2k; Potentiometer_ACP_CA6-H2,5_Horizontal_BELOW_W3DM
RV3, RV4, RV5: R_POT; Potentiometer_Alps_RK163_Single_Horizontal_W3DM
U1: LMH6609MA; SOIC-8_3.9x4.9mm_P1.27mm

Connections:
GND: C5.1, C6.2, C8.2, C9.2, C10.2, C11.2, C12.2, C13.1, C14.2, C15.1, C17.2, C23.2, C24.2, C25.1, J1.S, J2.1, J3(GND)1.1, Jack4.1, Jack5.1, Jack6.1, Jack7.1, R1.2, R2.1, R22.2, R24.1, R29.1, RV1.2, RV1.3, RV4.3; also elsewhere on the board
unnamed: C1.1, JP5.2
unnamed: C1.2, Q1.2 (B), R1.1
unnamed: C2.1, R2.2, R3.2
unnamed: C2.2, C5.2, D1.1 (K), D2.2 (A), R10.2, R62.2
unnamed: C3.1, Q5.2 (B), R12.2
unnamed: C3.2, R9.1
unnamed: C4.1, JP3.1
unnamed: C4.2, Q1.1 (C), Q2.1 (C), Q7.2 (B)
unnamed: C6.1, D7.1 (K), R4.1, R8.1, R11.1, R13.1
unnamed: C7.1, D4.2 (A), Q9.2 (C), Q13.3 (B), Q19.3 (C), R14.1
unnamed: C7.2, D3.1 (K), Q9.1 (E), Q10.3 (B), Q18.3 (C), RV2.2, RV2.3
unnamed: C10.1, C14.1, C24.1, D8.2 (A), J4.1, Jack4.2, U1.7 (V+)
unnamed: C11.1, C15.2, C25.2, D9.1 (K), J5.1, Jack5.2, U1.4 (V-)
unnamed: C8.1, C12.1, D7.2 (A), J6.1, Jack6.2, Q12.2 (C), Q14.2 (C)
unnamed: C9.1, C13.2, D2.1 (K), J7.1, Jack7.2, Q11.2 (C), Q17.2 (C)
unnamed: C16.1, JP1.2
unnamed: C16.2, R22.1, R23.1
unnamed: C17.1, R23.2, U1.3 (+)
unnamed: C18.1, C19.1, R27.2, U1.6
unnamed: C18.2, C19.2, C22.2, R28.2
unnamed: C20.1, C21.1, R30.2, RV3.2
unnamed: C20.2, R28.1, RV3.1
unnamed: C21.2, R29.2, RV3.3
unnamed: C22.1, RV5.3
unnamed 25: C23.1, RV5.1; also elsewhere on the board
unnamed: D1.2 (A), Q3.2 (B), Q6.2 (B), R3.1
unnamed: D3.2 (A), D6.1 (K), J8.1, Q6.1 (C)
unnamed: D4.1 (K), D5.2 (A), JP4.2
unnamed: D5.1 (K), Q12.3 (B)
unnamed: D6.2 (A), Q11.3 (B)
unnamed: D8.1 (K), Q13.2 (C), Q14.3 (E), Q15.2 (C), R17.2
unnamed: D9.2 (A), Q10.2 (C), Q16.2 (C), Q17.3 (E), R16.1
unnamed: J1.T, JP1.1
unnamed: J2.2, JP2.2, Q18.1 (E), Q19.1 (E), R18.2, R19.1, R20.2, R21.1
unnamed: J3.1, Q3.1 (C), R5.2, R7.2
unnamed: JP2.1, R12.1
unnamed: JP3.2, JP4.1, Q7.1 (C), Q8.1 (C)
unnamed: JP5.1, RV4.2
unnamed: Q1.3 (E), R5.1
unnamed: Q2.2 (B), Q4.1 (C), Q4.2 (B), Q5.1 (C)
unnamed: Q2.3 (E), R4.2
unnamed: Q3.3 (E), R61.1
unnamed: Q4.3 (E), R8.2
unnamed: Q5.3 (E), R7.1
unnamed: Q6.3 (E), R10.1
unnamed: Q7.3 (E), Q8.2 (B), R11.2
unnamed: Q8.3 (E), R13.2
unnamed: Q9.3 (B), R14.2, R15.1
unnamed: Q10.1 (E), Q16.1 (B), R19.2
unnamed: Q11.1 (E), Q17.1 (B), R16.2
unnamed: Q12.1 (E), Q14.1 (B), R17.1
unnamed: Q13.1 (E), Q15.1 (B), R18.1
unnamed: Q15.3 (E), Q19.2 (B), R20.1
unnamed: Q16.3 (E), Q18.2 (B), R21.2
unnamed: R9.2, RV1.1
unnamed: R15.2, RV2.1
unnamed: R24.2, R25.1, U1.2 (-)
unnamed: R25.2, R26.1
unnamed: R26.2, R27.1
unnamed: R30.1, RV4.1, RV5.2
unnamed: R61.2, R62.1

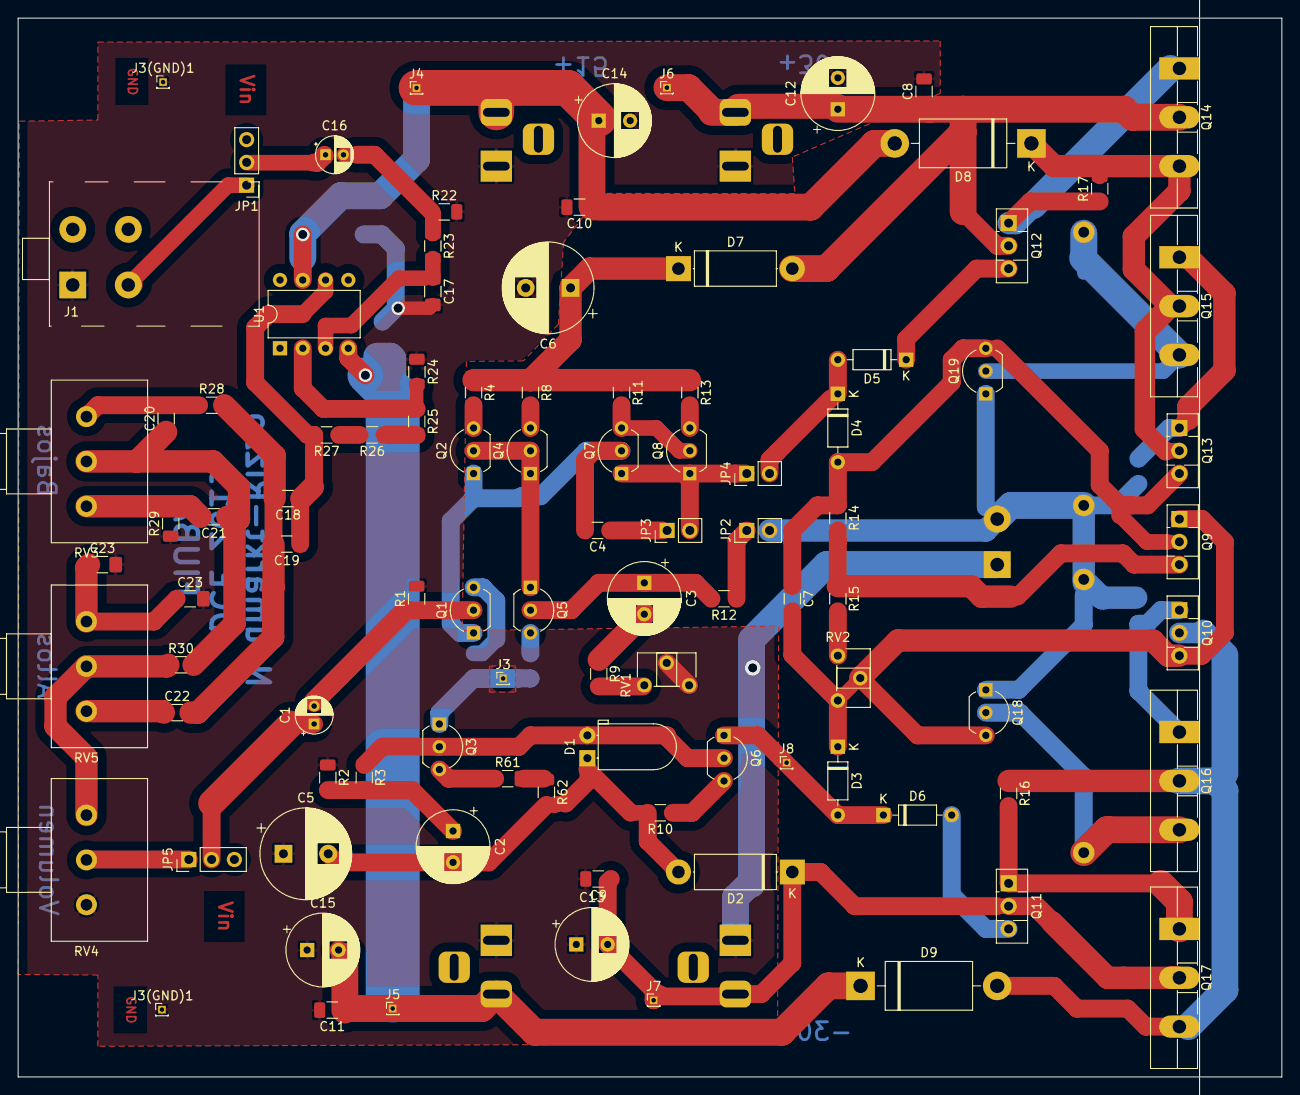
[picture p144: board kicad_ampli.kicad_pcb from above]

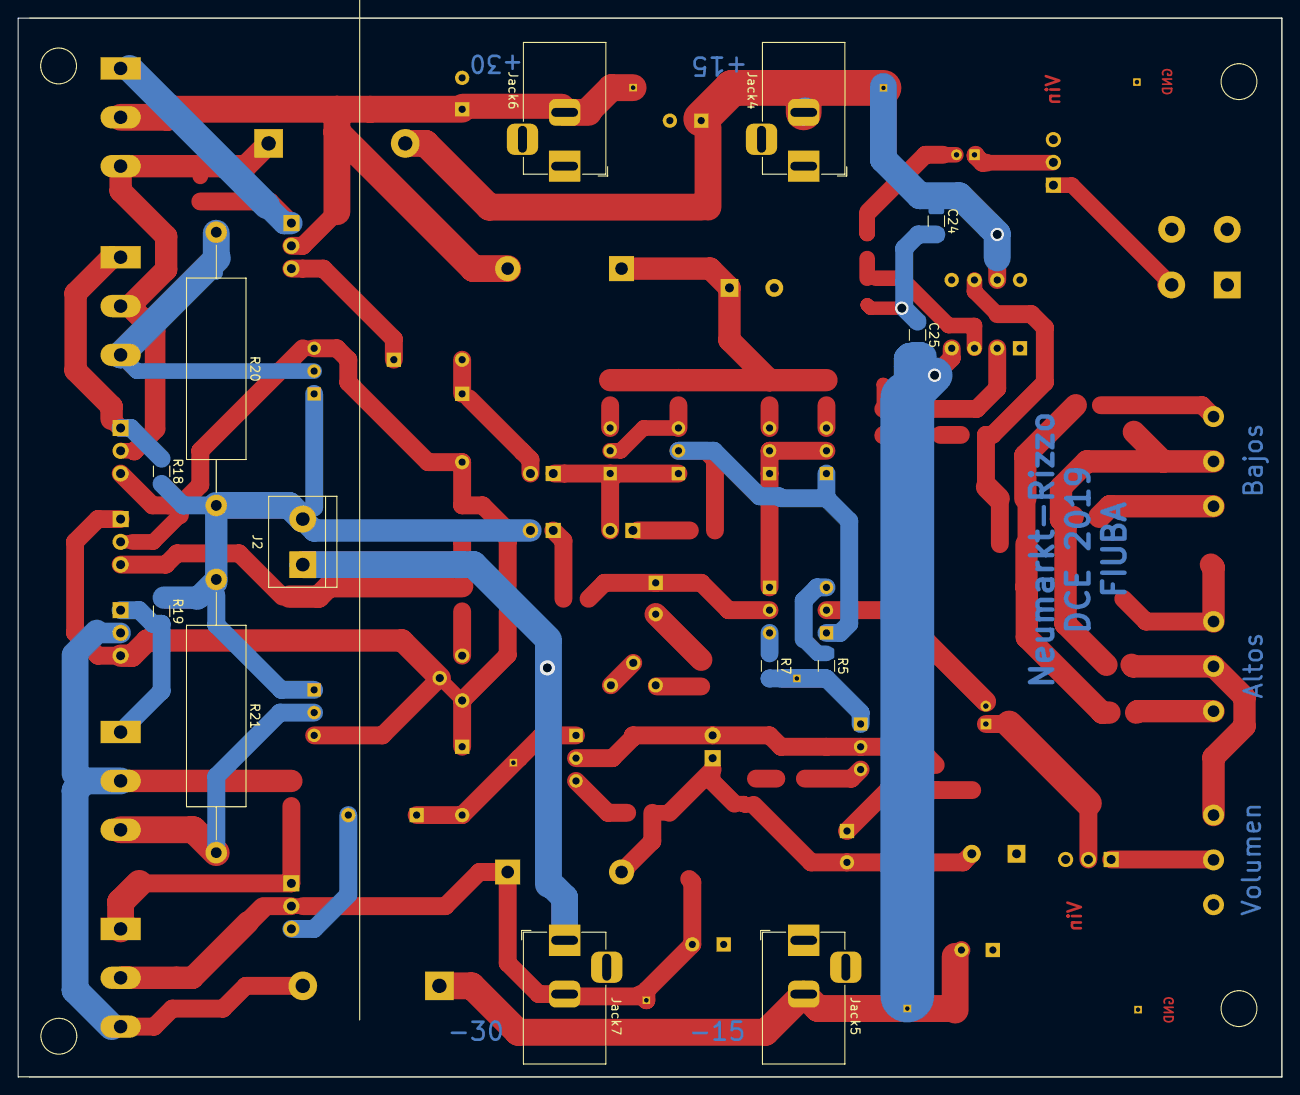
[picture p145: board kicad_ampli.kicad_pcb from below]

Board: 2 copper layers, 141.0 x 118.1 mm, 110 parts (13 on the bottom side), 62 nets.

Other parts of the board:
C23#2: 22n; C_1206_3216Metric_Pad1.42x1.75mm_HandSolder
J3(GND)1#2: Conn_01x01_Male; PinHeader_1x01_P1.00mm_Vertical

Their connections:
GND: C23#2.2, J3(GND)1#2.1; also elsewhere on the board
unnamed 25: C23#2.1; also elsewhere on the board
