MIDORIINU/DSE-CII/design/Fuente/kicad_fuente/kicad_fuente.kicad_pcb

## KiCad design design/Fuente/kicad_fuente/kicad_fuente.kicad_pcb (2019-12-07)

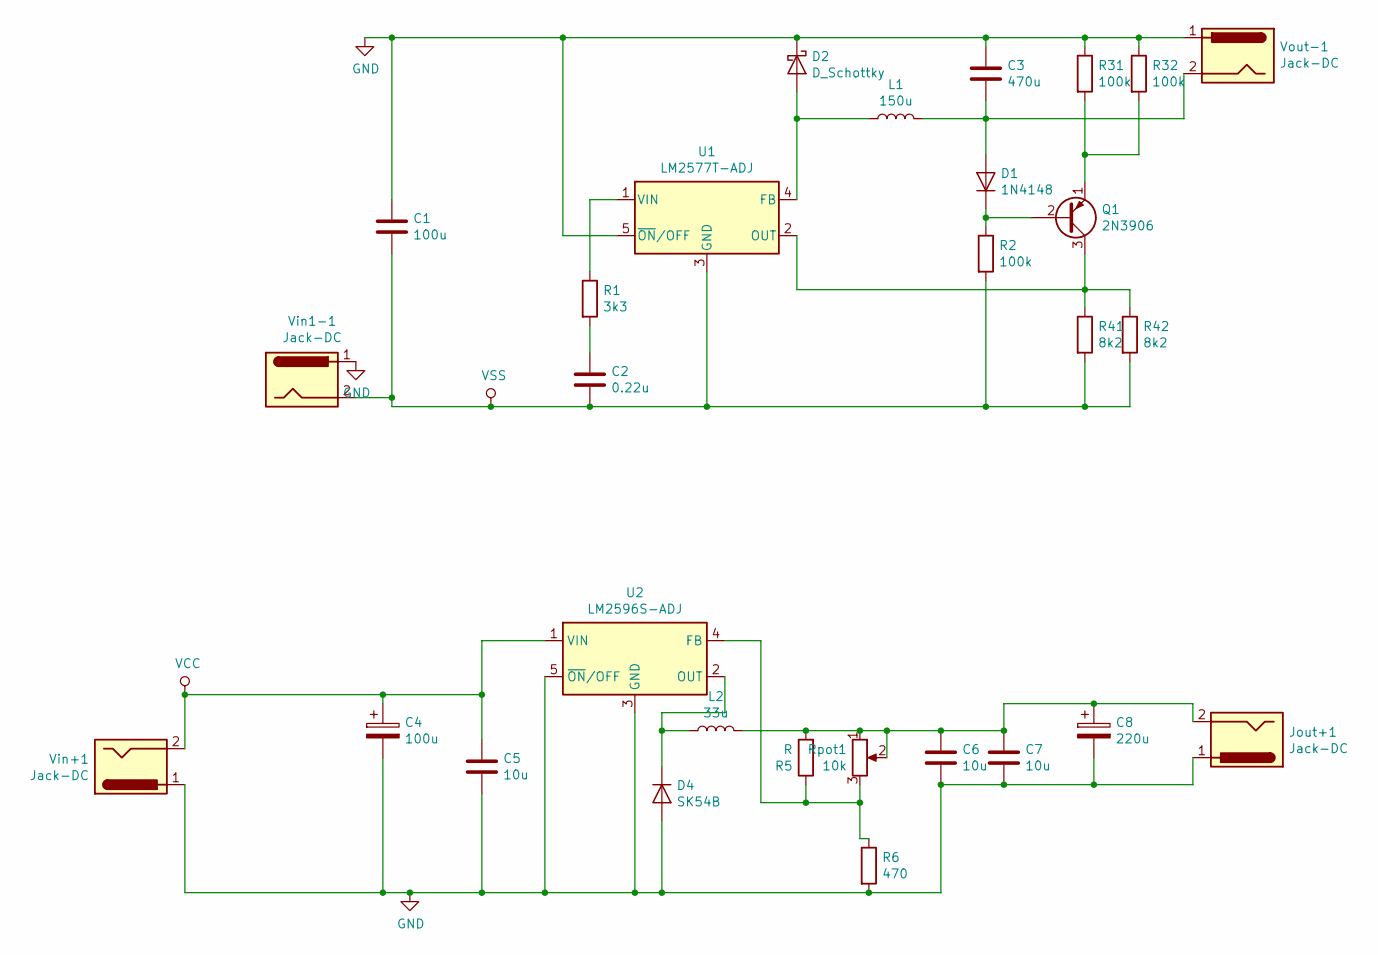
[picture p146: schematic kicad_fuente.sch]

Parts:
C1: 100u; CP_Radial_D8.0mm_P2.50mm
C2: 0.22u; C_1206_3216Metric
C3: 470u; CP_Radial_D12.5mm_P5.00mm
C4: 100u; CP_Elec_8x10
C5, C6, C7: 10u; C_1206_3216Metric_Pad1.42x1.75mm_HandSolder
C8: 220u; CP_Elec_8x10
D1: 1N4148; D_DO-35_SOD27_P7.62mm_Horizontal
D2: D_Schottky; D_DO-201AD_P15.24mm_Horizontal
D4: SK54B; D_2010_5025Metric_Pad1.52x2.65mm_HandSolder
Jout+1: Jack-DC; BarrelJack_Horizontal
L1: 150u; L_Toroid_Vertical_L19.1mm_W8.1mm_P7.10mm_Bourns_5700
L2: 33u; L_12x12mm_H8mm
Q1: 2N3906; TO-92_Inline
R1: 3k3; R_1206_3216Metric_Pad1.42x1.75mm_HandSolder
R2, R31, R32: 100k; R_1206_3216Metric_Pad1.42x1.75mm_HandSolder
R5: R; R_1206_3216Metric_Pad1.42x1.75mm_HandSolder
R6: 470; R_1206_3216Metric_Pad1.42x1.75mm_HandSolder
R41, R42: 8k2; R_1206_3216Metric_Pad1.42x1.75mm_HandSolder
Rpot1: 10k; Potentiometer_Bourns_3296W_Vertical
U1: LM2577T-ADJ; TO-220-5_Vertical
U2: LM2596S-ADJ; TO-263-5_TabPin3
Vin1-1: Jack-DC; BarrelJack_Horizontal
Vin+1: Jack-DC; BarrelJack_Horizontal
Vout-1: Jack-DC; BarrelJack_Horizontal

Connections:
GND: C1.1, C3.1, C4.2, C5.2, C6.2, C7.2, C8.2, D2.1 (K), D4.2 (A), Jout+1.1, R6.2, R31.1, R32.1, U1.5 (~ON~/OFF), U2.3 (GND), U2.5 (~ON~/OFF), Vin1-1.1, Vin+1.1, Vout-1.1
unnamed: C2.1, R1.2
unnamed: C3.2, D1.2 (A), L1.2, Vout-1.2
unnamed: C6.1, C7.1, C8.1, Jout+1.2, L2.2, R5.2, Rpot1.1, Rpot1.2
unnamed: D1.1 (K), Q1.2 (B), R2.1
unnamed: D2.2 (A), L1.1, U1.4 (FB)
unnamed: D4.1 (K), L2.1, U2.2 (OUT)
unnamed: Q1.1 (E), R31.2, R32.2
unnamed: Q1.3 (C), R41.1, R42.1, U1.2 (OUT)
unnamed: R1.1, U1.1 (VIN)
unnamed: R5.1, R6.1, Rpot1.3, U2.4 (FB)
VCC: C4.1, C5.1, U2.1 (VIN), Vin+1.2
VSS: C1.2, C2.2, R2.2, R41.2, R42.2, U1.3 (GND), Vin1-1.2

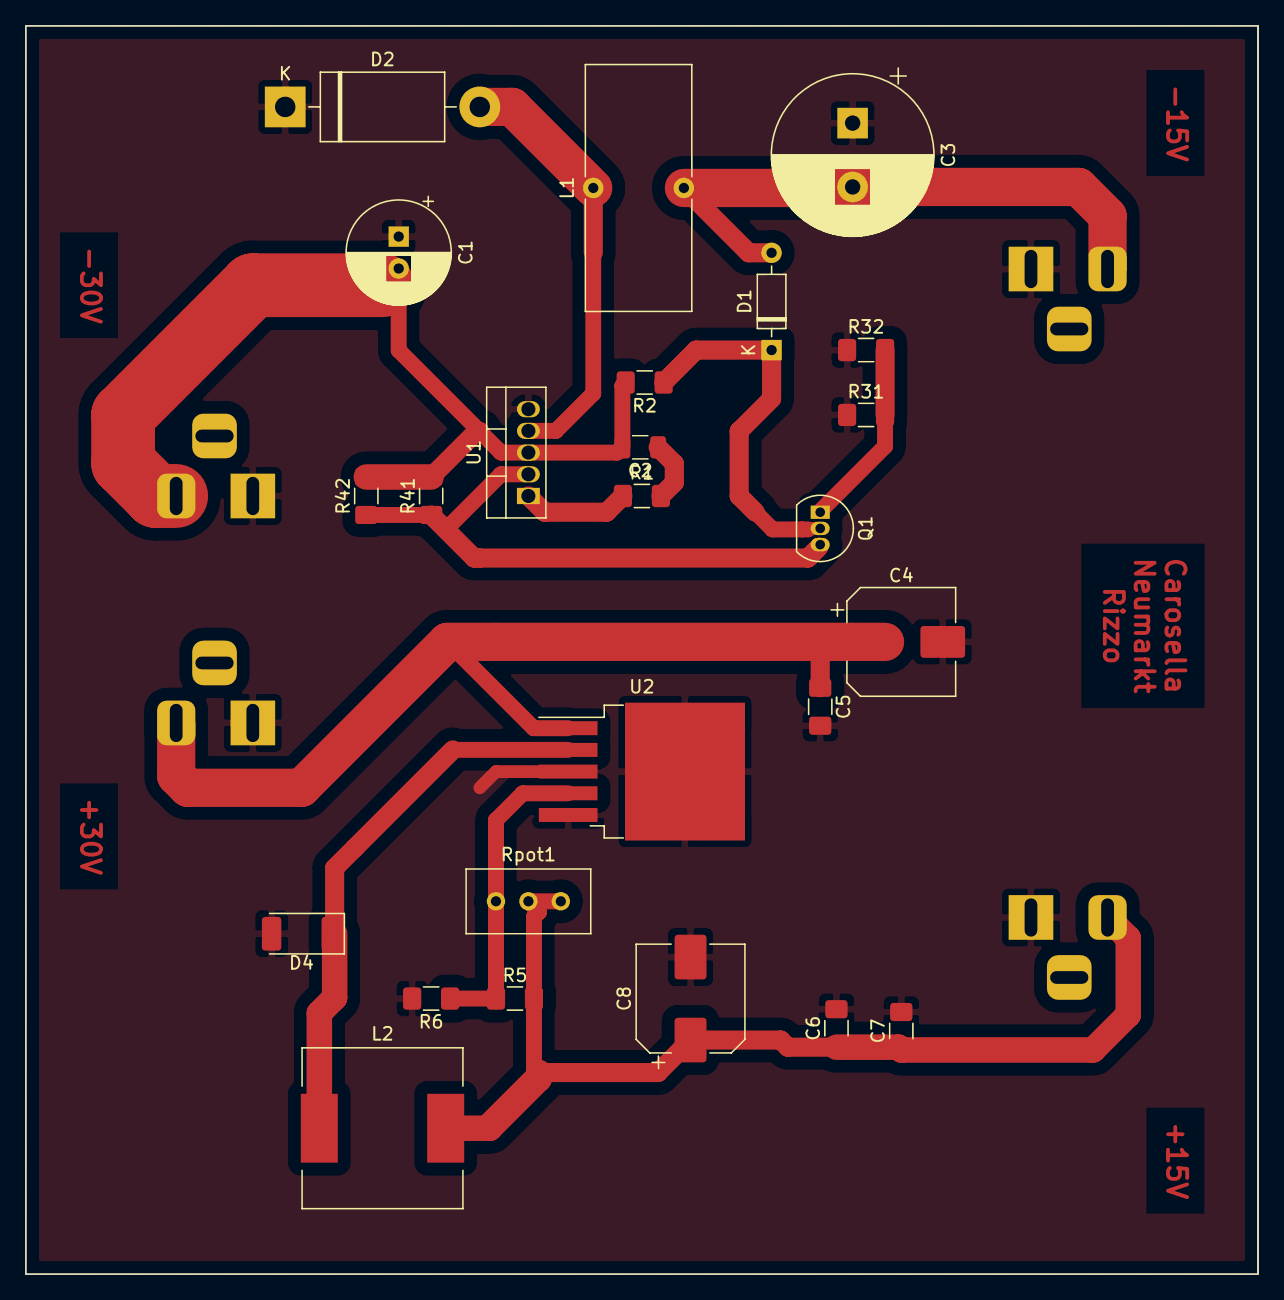
[picture p147: board kicad_fuente.kicad_pcb from above]

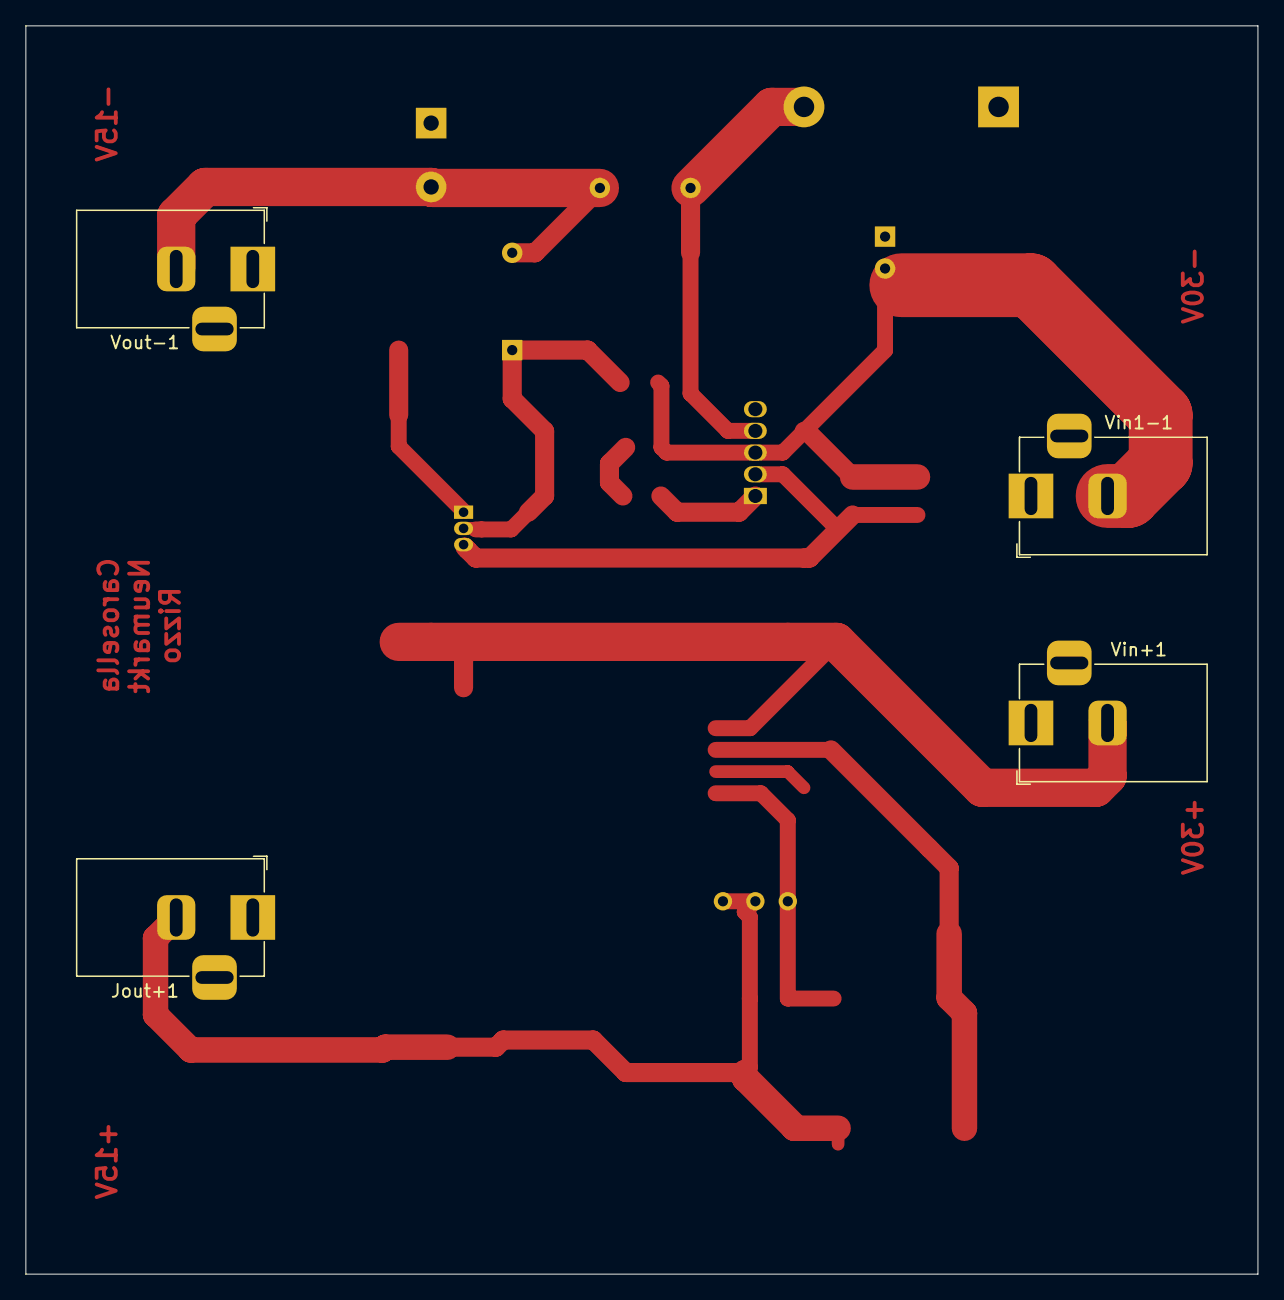
[picture p148: board kicad_fuente.kicad_pcb from below]

Board: 2 copper layers, 96.5 x 97.8 mm, 29 parts (4 on the bottom side), 13 nets.
