MIDORIINU/DSE-CII/(commit log)

2019-12-07 Inicializo nuevo repo.
    [ACJS-NH35.step, Bourns 3362R.step, Componentes.csv, Componentes.ods, DIP-8_W7.62mm.step, DIP-8_W7.62mm_Socket.step, HS150mmx59mmx28mm.step, PJ-102B.step]
2019-12-07 Agrego directorio para las mediciones.
2019-12-07 Agrego imágenes de algunas mediciones.
2019-12-08 Agrego gráficos de MATLAB de THD.
2019-12-08 Agrego curvas monótonas que se ajustan a los datos de THD.
2019-12-08 Corrigiendo simulaciones de THD.
2019-12-09 Agrego gráficos de THD medido vs simulado.
2019-12-09 Imagenes del spectra plus.
    [Mediciones del TP.xlsx]
2019-12-09 Agrego imágenes de la medición de THD con Spectra Plus.
2019-12-12 Actualizo planilla de punto de reposo.
    [Mediciones del TP.xlsx]
2019-12-14 Agrego simulación del circuito de rechazo de ruido de fuente.
2019-12-14 Subo fotos del amplificador y voy actualizando las mediciones de ayer.
    [Mediciones del TP.xlsx]
2019-12-15 Agrego imágenes en resolución original.
    [Mediciones del TP.xlsx]
2019-12-15 Reorganizo el repositorio y agrego copia del diseño en kicad para introducir las modificaciones.
    [ACJS-NH35.step, Bourns 3362R.step, Componentes.csv, Componentes.ods, DIP-8_W7.62mm.step, DIP-8_W7.62mm_Socket.step, HS150mmx59mmx28mm.step, PJ-102B.step]
2019-12-15 Reorganizando el repo.
    [Componentes.csv, Componentes.ods, Mediciones del TP.xlsx, componentes.xlsx, kicad_fuente.kicad_pcb, kicad_fuente.sch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]
2019-12-16 Sigo generando imágenes desde las simulaciones y los datos de las medidiciones.
2019-12-16 Subo algunas imágenes de simulaciones y mediciones al repo.
    [Q1.xlsx]
2019-12-16 Agrego scripts de MATLAB al repo.
2019-12-17 Versiones completas de los gráficos.
2019-12-17 Sincronizo con overleaf.
    [ACJS-NH35.step, Bourns 3362R.step, DIP-8_W7.62mm.step, DIP-8_W7.62mm_Socket.step, HS150mmx59mmx28mm.step, PJ-102B.step, POTENTIOMETER.step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]
2019-12-18 Agregadas las imégenes de los instrumentos.
2019-12-18 Ajustando ancho de las imágenes.
2019-12-20 Agrego la medición de eficiencia.
2019-12-20 Agrego el gráfico simulado de la eficiencia.
2019-12-21 Agrego algunas fotos para la versión final del informe.
2019-12-21 Version 2 del informe para entregar.
