MIDORIINU/DSE-CII/(notices)

Notices in the files:
Kicad-original/3D/DIP-8_W7.62mm.step:
Copyright (C) 2017, your name
This program is free software: you can redistribute it and/or modify
it under the terms of the GNU General Public License as published by
the Free Software Foundation, either version 3 of the License, or
any later version.
itself might be covered by the GNU General Public License.
